degesz/LATEX_Bakalarka/STM32_firmware/CLI.md

# CLI Reference

This document describes the serial command interface exposed by the STM32 LCR meter firmware.

The CLI is implemented with `SimpleCLI` in `src/command_interface.cpp`.

## Serial Settings

- baud rate: `115200`
- line ending: `LF` or `CRLF`

Commands are line-based. Send one command per line.
After each command response, the firmware emits one extra blank line to make responses easier to separate in a serial terminal.

Example:

```text
status
capture
dds 10000 1
```

## Startup Messages

On successful startup the firmware prints:

```text
ready,stm32f103_lcr_meter
```

If acquisition initialization fails, an error line is printed before the ready banner:

```text
error,<reason>
ready,stm32f103_lcr_meter
```

## Command Summary

- `help`
- `id`
- `status`
- `capture [count] [rate] [channel]`
- `capturepair [count] [rate]`
- `measure [count] [rate]`
- `dds [freq_hz] [enable]`
- `amp [value]`
- `offset [value]`
- `range [value]`
- `vpga [value]`
- `ipga [value]`

## Command Details

### `help`

Prints the command list generated by `SimpleCLI`.

Example:

```text
help
```

### `id`

Prints the device identifier and burst buffer capacity.

Example:

```text
id
```

Typical output:

```text
device,stm32f103_lcr_meter
firmware,acquisition_control
max_burst_samples,2048
```

### `status`

Prints the current acquisition settings and output settings.

Example:

```text
status
```

Typical output:

```text
sample_rate_hz,25000
sample_count,500
dds_frequency_hz,1000
dds_enabled,1
amp_wiper,128
offset_pwm,0
shunt_range,0
voltage_pga,0
current_pga,0
```

### `capture [count] [rate] [channel]`

Captures a synchronous AC burst and streams one selected channel in CSV format compatible with the PC oscilloscope script.

Arguments:

- `count`: number of synchronous voltage/current sample pairs
- `rate`: requested sample rate in Hz
- `channel`: `voltage`, `current`, `v`, or `i`

Defaults:

- `count = 500`
- `rate = 0` which means `min(dds_frequency_hz * 25, 1000000)`
- `channel = voltage`

Example:

```text
capture
capture 512 250000 voltage
```

Output format:

```text
sample_rate_hz,250000
index,value
0,2038
1,2060
2,2075
...
```

Notes:

- The actual sample rate reported back is the configured timer rate after integer divider rounding.
- With `rate = 0`, the firmware derives the request from the active DDS frequency so the target is `25` samples per period.
- If `dds_frequency_hz * 25` exceeds `1000000 Hz`, the firmware captures `500` samples at the fastest achievable rate instead.
- Requested sample rates must be between `1000 Hz` and `1000000 Hz`.
- On the current STM32F103 setup, `TIM3` runs from a `72 MHz` timer clock, so the reported rate is the nearest achievable divider result in that range.
- Valid sample count is limited by the burst buffer size.

### `capturepair [count] [rate]`

Captures a synchronous AC burst and prints both channels together.

Arguments:

- `count`: number of sample pairs
- `rate`: requested sample rate in Hz

Defaults:

- `count = 500`
- `rate = 0` which means `min(dds_frequency_hz * 25, 1000000)`

Example:

```text
capturepair
capturepair 128 100000
```

Typical output:

```text
sample_rate_hz,100000
index,v_raw,i_raw
0,2042,2037
1,2068,2059
2,2081,2074
...
```

This command is useful when host software needs both synchronous AC channels at once.

Sample-rate limits are the same as `capture`: request `1000..1000000 Hz`, or pass `0` to auto-select from DDS frequency with a `25` samples-per-period target.

### `measure [count] [rate]`

Captures a synchronous burst, converts both channels to physical units, runs a single-frequency DFT at the active DDS frequency, and reports amplitude, phase, and impedance.

Arguments:

- `count`: number of sample pairs
- `rate`: requested sample rate in Hz

Defaults:

- `count = 500`
- `rate = 0` which means `min(dds_frequency_hz * 25, 1000000)`

Example:

```text
measure
measure 512 200000
```

Typical output:

```text
sample_rate_hz,200000
dds_frequency_hz,10000
shunt_range,1
voltage_pga,0
current_pga,0
shunt_resistance_ohm,1000.000000
samples_per_period,20.000000
captured_cycles,25.600000
voltage_amplitude_v,0.120000
voltage_phase_deg,3.400000
current_amplitude_a,0.000118
current_phase_deg,-1.100000
phase_diff_deg,4.500000
impedance_mag_ohm,1016.949158
impedance_real_ohm,1013.815613
impedance_imag_ohm,79.796631
```

Notes:

- ADC samples are converted from `0..3.3 V` and centered by subtracting `1.65 V`.
- Current is derived from the centered current-channel voltage and the active shunt value.
- With `rate = 0`, the firmware requests `25` samples per DDS period and caps the request at `1000000 Hz`.
- The reported phase difference includes a fixed `180 deg` compensation for the inverted current analog path.
- Shunt mapping is `0=100 ohm`, `1=1 kohm`, `2=10 kohm`, `3=100 kohm`.
- Voltage and current PGA scaling currently use placeholder gain tables set to `1.0`; update `src/impedance_analyzer.cpp` with real analog gains later.

### `dds [freq_hz] [enable]`

Sets DDS frequency and output enable state.

Arguments:

- `freq_hz`: desired DDS output frequency in Hz
- `enable`: `1` to run, `0` to hold reset

Defaults:

- `freq_hz = 1000`
- `enable = 1`

Example:

```text
dds 10000 1
```

Success response:

```text
ok,dds
```

### `amp [value]`

Sets the MCP4561 volatile wiper value.

Full-scale reference: `amp 255` corresponds to approximately `3.55 Vpp`.

Arguments:

- `value`: `0..255`

Example:

```text
amp 180
```

Success response:

```text
ok,amp
```

Failure response:

```text
error,mcp4561 write failed
```

### `offset [value]`

Sets the PWM duty applied to `PA7` for generated source offset control.

Full-scale reference: `offset 255` corresponds to approximately `3.3 V`.

Arguments:

- `value`: `0..255`

Example:

```text
offset 140
```

Success response:

```text
ok,offset
```

### `range [value]`

Sets the 2-bit shunt range selector.

Arguments:

- `value`: `0..3`

Example:

```text
range 2
```

Success response:

```text
ok,range
```

### `vpga [value]`

Sets the 2-bit voltage PGA selector.

Arguments:

- `value`: `0..3`

Example:

```text
vpga 1
```

Success response:

```text
ok,vpga
```

### `ipga [value]`

Sets the 2-bit current PGA selector.

Arguments:

- `value`: `0..3`

Example:

```text
ipga 3
```

Success response:

```text
ok,ipga
```

## Error Responses

The CLI returns simple text errors when parsing or validation fails.

Examples:

```text
error,invalid capture arguments
error,invalid range value
error,invalid dds arguments
error,dma transfer error
```

`SimpleCLI` parser errors are also forwarded as:

```text
error,<SimpleCLI message>
```

## Typical Workflows

### 1. Basic bring-up

```text
id
status
```

### 2. Set source and frontend, then capture one channel

```text
dds 10000 1
amp 160
offset 0
range 1
vpga 2
ipga 2
capture 512 200000 voltage
```

### 3. Capture both synchronous AC channels

```text
capturepair
```

### 4. Use with the Python oscilloscope

Run on the PC:

```bash
python3 pc_osc/pc_oscilloscope.py --port /dev/ttyACM0 --baud 115200 --samples 500 --sample-rate 0
```

Then send on the device serial port:

```text
capture
```

## Notes

- The CLI is designed for development and bring-up, not yet for a polished production protocol.
- `capture` is the easiest way to stay compatible with the existing oscilloscope tool.
- `capturepair` is more suitable for future host-side impedance processing.
- The MCP4561 digipot address is fixed in firmware to `47` decimal (`0x2F`).
