degesz/LATEX_Bakalarka/LATEX_Bakalarka/text/zkratky.tex

\chapter*{\listofabbrevname}
\phantomsection
\addcontentsline{toc}{chapter}{\listofabbrevname}

\begin{acronym}[KolikMista]

	\acro{LCR}
		{indukčnost, kapacita, odpor}
	\acro{ESR}
		{equivalent series resistance (ekvivalentní sériový odpor)}
	\acro{DUT}	 
		{device under test (měřené zařízení)}
	\acro{A/D}	
		{analogově--digitální}
	\acro{DDS}	
		{direct digital synthesis}
	\acro{LUT}	
		{lookup table}
	\acro{D/A}	
		{digitálně--analogový}
	\acro{PGA}	
		{programmable gain amplifier}
	\acro{ADC}	
		{analog-digital converter (analogově-digitální převodník)}
	\acro{SAR}{successive approximation register (registr postupné aproximace)}		
	\acro{OZ}
		{operační zesilovač}
	\acro{GBW}
		{gain bandwidth product}
	\acro{DFT}
		{discrete Fourier transform (diskrétní Fourierova transformace)}
	\acro{FFT}
		{fast Fourier transform (rychlá Fourierova transformace)}
	\acro{RMS}
		{root mean square (efektivní hodnota)}
	\acro{CMOS}
		{complementary metal-oxide-semiconductor}
	\acro{I$^{2}$S}{inter-IC sound}
	\acro{DMA}{direct memory access (přímý přístup do paměti)}
	\acro{UART}{universal asynchronous receiver-transmitter}
	\acro{HP}{horní propust}
	\acro{BNC}{Bayonet Neill-Concelman}
	\acro{CR}{kapacita-odpor (capacitor-resistor)}
	\acro{CSV}{comma-separated values}
	\acro{DC}{direct current (stejnosměrný proud)}
	\acro{DPS}{deska plošných spojů}
	\acro{ESD}{electrostatic discharge (elektrostatický výboj)}
	\acro{HAL}{Hardware Abstraction Layer}
	\acro{I/O}{input/output (vstup/výstup)}
	\acro{I$^{2}$C}{Inter-Integrated Circuit}
	\acro{LAN}{local area network}
	\acro{LED}{light-emitting diode (svítivá dioda)}
	\acro{PC}{personal computer (osobní počítač)}
	\acro{PTC}{positive temperature coefficient (pozitivní teplotní koeficient)}
	\acro{PWM}{pulse-width modulation (pulzně šířková modulace)}
	\acro{RC}{odpor-kapacita (resistor-capacitor)}
	\acro{RGB}{red-green-blue}
	\acro{RL}{odpor-indukčnost (resistor-inductor)}
	\acro{RLC}{rezistor-indukčnost-kapacita (resistor-inductor-capacitor)}
	\acro{SMD}{surface-mount device (součástka pro povrchovou montáž)}
	\acro{SPI}{Serial Peripheral Interface}
	\acro{TVS}{transient voltage suppression}
	\acro{XOR}{exclusive OR}
	
	\acro{DAC}
		{digital-analog converter (digitálně-analogový převodník)}
% rozvinutí zkratky
	%%% bsymfvz
	\acro{symfvz}						% název
		[\ensuremath{f_\textind{vz}}] % symbol
		{vzorkovací kmitočet}					% popis
	%%% esymfvz
 
\end{acronym}
