degesz/LATEX_Bakalarka/LATEX_Bakalarka/text/firmware.tex

\chapter{Firmware}

Firmware finálního prototypu je určen především pro ovládání analogové části, vzorkování napěťového a proudového signálu a následný výpočet impedance. 
Je napsán pro mikrokontrolér STM32F103C8 v prostředí PlatformIO s frameworkem Arduino. 
Pro části, které se dotýkají časování a nastavení ADC, je však použita přímo knihovna STM32 HAL. \cite{STM32_manual}

Program po spuštění inicializuje komunikační rozhraní, řídicí výstupy, zdroj měřicího signálu, indikační LED a snímací část. 
Poté  v hlavní smyčce pouze zpracovává příkazy ze sériové linky. 
Samotné měření tedy není spuštěno trvale, ale vždy až na požadavek z počítače.

\section{Komunikační rozhraní}

Zařízení je ovládáno textovým příkazovým rozhraním po sériové lince je k tomu využita knihovna SimpleCLI \cite{SimpleCLI}. 
Rozhraní slouží jak pro nastavování generátoru a analogového frontendu, tak pro vyvolání snímání nebo výpočtu impedance.

Mezi hlavní příkazy patří:
\begin{table}[H]
    \centering
    \small
    \begin{tabular}{ll}
        \toprule
        Příkaz & Význam \\
        \midrule
        \texttt{status} & Vypíše aktuální nastavení. \\
        \texttt{dds <frekvence> <povoleni>} & Nastaví frekvenci a zapnutí zdroje měřicího signálu. \\
        \texttt{amp <hodnota>} & Nastaví amplitudu měřicího signálu. \\
        \texttt{offset <hodnota>} & Nastaví stejnosměrnou složku signálu pomocí PWM. \\
        \texttt{range <hodnota>} & Vybere bočník pro změnu měřicího rozsahu. \\
        \texttt{vpga <hodnota>} & Nastaví zesílení napěťového kanálu. \\
        \texttt{ipga <hodnota>} & Nastaví zesílení proudového kanálu. \\
        \texttt{capture} & Sejme a odešle jeden z měřicích kanálů. \\
        \texttt{capturepair} & Sejme a odešle oba měřicí kanály. \\
        \texttt{measure} & Sejme oba kanály a vypočítá impedanci. \\
        \bottomrule
    \end{tabular}
    \caption{Přehled podporovaných příkazů firmwaru}
    \label{tab:firmware_prikazy}
\end{table}

Odpovědi jsou záměrně jednoduché a mají podobu řádků oddělených čárkou. 
To umožňuje snadné algoritmické zpracování na straně počítače a zároveň jednoduché ruční testování v sériovém terminálu.

\section{Řízení zdroje měřicího signálu a rozsahů}

Zdroj měřicího signálu je založen na obvodu . 
Mikrokontrolér ovládá obvod AD9837 sériovým rozhraním. 
Při změně frekvence firmware vypočítá ladicí slovo podle hodinového kmitočtu 16 MHz 
a zapíše jej do frekvenčního registru DDS. 
Výstup lze také softwarově zapnout a vypnout.

Amplituda výstupního signálu je nastavována digitálním potenciometrem MCP4561 přes sběrnici I\textsuperscript{2}C. 
Firmware zapisuje hodnotu 0 až 255 do jeho registru jezdce. 
Stejnosměrná složka zdroje je nastavována změnou střídy PWM výstupu, který je v analogové části filtrován.

Proudový rozsah a zesílení obou měřicích větví jsou řízeny jako tři dvoubitové hodnoty na šesti digitálních výstupech. 
%%TODO: good or not?   Firmware pro tyto volby pouze nastavuje příslušné binární kombinace; fyzický význam jednotlivých kódů je dán zapojením analogové části.

\section{Synchronní snímání signálů}

Měřené střídavé signály jsou přivedeny na dva analogové vstupy mikrokontroléru. 
Protože pro výpočet impedance je důležitý nejen poměr amplitud, ale i fázový rozdíl,
musí být oba kanály vzorkovány současně.

Firmware k tomu využívá dvojici \acs{A/D} převodníků v režimu současné pravidelné konverze. 
Spouštění převodu zajišťuje časovač TIM3, jehož událost update je přivedena jako externí trigger pro ADC1. 
Po každém impulzu časovače tedy vznikne jeden synchronní pár vzorků.

Výsledky převodu jsou ukládány pomocí \acs{DMA} do paměťového bufferu. 
Každá položka bufferu je 32bitové slovo, ve kterém je v dolních 16 bitech uložen vzorek napěťového kanálu a v horních 16 bitech vzorek proudového kanálu. 
Maximální délka jedné dávky je 2048 dvojic vzorků.

Vzorkování je dávkové. 
Hostitelský počítač pošle požadovaný počet vzorků a požadovanou vzorkovací frekvenci. 
Firmware podle požadované frekvence nastaví děličku a periodu časovače TIM3, spustí ADC a DMA, 
počká na dokončení přenosu a po skončení časovač i převodníky zastaví. 
Protože časovač používá celočíselné dělení, skutečná frekvence nemusí být přesně rovna požadované hodnotě; 
firmware proto v odpovědi vždy vrací skutečně nastavenou hodnotu.

Pokud je požadovaná vzorkovací frekvence v příkazu zadána jako nula, 
firmware ji automaticky odvodí z aktuální frekvence DDS. 
Cílem je 25 vzorků na periodu měřicího signálu, při měřicí frekvenci větší než 40 kHz 
je však dosažen hardwarový limit vzorkovací frekvence 1 MHz a počet vzorků na periodu se snižuje.

Získané vzorky jsou následně buď odeslány po sériové lince do PC, nebo je z nich vypočítána impedance 
(v závislosti na použití příkazu \texttt{capture} nebo \texttt{measure}).

\section{Výpočet impedance}
%%TODO: vypocet impedance ve firmwaru

\section{Stavová indikace}

Pro jednoduchou kontrolu běhu programu je použit výstup na signalizační LED. 
Firmware na něm generuje signál PWM s pomalu se měnící střídou a tím vizuálně indikuje, 
že hlavní smyčka běží a mikrokontrolér není zablokovaný.

Pro další signalizační účely jsou na DPS zapojené dvě adresovatelné RGB diody, 
ale v současnosti nejsou ve firmwaru nijak implementovány.
