degesz/LATEX_Bakalarka/LATEX_Bakalarka/text/literatura.tex

% Seznam citací definovaný přímo pomocí prostředí thebibliography
% Formátováno podle normy ČSN ISO 690

\begin{thebibliography}{99}

% ==================== ZDROJE TEORIE ====================

\bibitem{KeysightImpedanceHandbook}
	KEYSIGHT TECHNOLOGIES.
	\emph{Impedance Measurement Handbook: A~Guide to Measurement Technology and Techniques.}  [online].
	6th ed.
	Application Note 5950-3000.
%	2020.
	Dostupné~z: \url{https://www.keysight.com/us/en/assets/7018-06840/application-notes/5950-3000.pdf}. [cit.\,2026-01-03].

\bibitem{ArtOfElectronics}
	HOROWITZ, Paul a~Winfield HILL.
	\emph{The Art of Electronics.}
	3rd ed.
	Cambridge: Cambridge University Press, 2015.
	ISBN~978-0521809269.

\bibitem{smith_dsp_guide}
	SMITH, Steven~W.
	\emph{The Scientist and Engineer's Guide to Digital Signal Processing.}
	San Diego: California Technical Publishing, 1997.
	ISBN~978-0-9660176-3-2.
	Dostupné také z: \url{http://www.dspguide.com/}. [cit.\,2026-01-03].

\bibitem{Shannon1949}
	SHANNON, Claude~E.
	\emph{Communication in the Presence of Noise.}
	v Proceedings of the IRE,
	vol.\,37, no.\,1, s.\,10--21, 1949.
	DOI:~10.1109/JRPROC.1949.232969.
	Dostupné také~z: \url{https://ieeexplore.ieee.org/document/1697831} [cit.\,2026-01-03].

\bibitem{TI_ImpedanceMeasurement}
	TEXAS INSTRUMENTS.
	\emph{LCR Meter Analog Front-End Reference Design (TIDA-060029).} [online].
	%TIDUEU6B.
	%2021.
	Dostupné~z: \url{https://www.ti.com/lit/ug/tidueu6b/tidueu6b.pdf}. [cit.\,2026-01-03].

\bibitem{elliott_peakdetection}
	ELLIOTT, Rod.
	\emph{AN014 -- Peak Detection Circuits} [online].
	2017.
	Dostupné~z: \url{https://sound-au.com/appnotes/an014.htm}. [cit.\,2026-01-03].

\bibitem{TI_stability}
	KAY, Art a~Collin WELLS.
	\emph{Operational Amplifier Stability Theory and Compensation Methods.} [online].
	Texas Instruments, 2025.
	White Paper SBOA626.
	Dostupné~z: \url{https://www.ti.com/jp/lit/wp/sboa626/sboa626.pdf}. [cit.\,2026-05-24].

\bibitem{Steinbauer_Mereni2010}
	STEINBAUER, Miloslav, Jan MIKULKA, Eva GESCHEIDTOVÁ, Radek KUBÁSEK a~Jiří REZ.
	\emph{Měření v elektrotechnice.}
	2., dopl. vyd.
	Brno: VUT v~Brně, 2010.
	ISBN~978-80-214-4160-6.

% ==================== DATASHEETY PŘÍSTROJŮ ====================

\bibitem{RS_LCX_Datasheet}
	ROHDE \& SCHWARZ.
	\emph{R\&S LCX LCR Meters: Data Sheet.} [online].
	%Munich, Germany, 2022.
	Verze 03.00
	Dostupné~z: \url{https://scdn.rohde-schwarz.com/ur/pws/dl_downloads/pdm/cl_brochures_and_datasheets/data_sheet/3609_8309_32/LCX_dat_en_3609-8309-32_v0300.pdf}. [cit.\,2026-01-03].

\bibitem{Keysight_U1732C_Datasheet}
	KEYSIGHT TECHNOLOGIES.
	\emph{U1730C Series Handheld LCR Meters: Data Sheet.} [online].
	Dostupné~z: \url{https://www.keysight.com/us/en/assets/7018-02950/data-sheets/5990-7778.pdf}. [cit.\,2026-01-03].

\bibitem{BKPrecision_880_Datasheet}
	B\&K PRECISION.
	\emph{Model 880: Dual Display Handheld 100\,kHz LCR Meter with ESR: Datasheet.} [online].
	Dostupné~z: \url{https://www.bkprecision.com/products/component-testers/880}. [cit.\,2026-04-30].

\bibitem{hadex_lcrt4}
	HADEX.
	\emph{Univerzální tester součástek LCR-T4} [online].
	%2025.
	Dostupné~z: \url{https://www.hadex.cz/r098-univerzalni-tester-soucastek-lcr-t4/}. [cit.\,2026-01-03].

% ==================== DATASHEETY SOUČÁSTEK ====================

\bibitem{CD4052B}
	TEXAS INSTRUMENTS.
	\emph{CD405xB CMOS Single 8-Channel Analog Multiplexer/Demultiplexer With Logic-Level Conversion.} [online].
	Dostupné~z: \url{https://www.ti.com/lit/ds/symlink/cd4052b.pdf}. [cit.\,2026-05-05].

\bibitem{citrelay_j104d}
	CIT RELAY \& SWITCH.
	\emph{J104D Series Relay Datasheet.} [online].
	Rev.\,B.
	%Rogers, MN, USA, 2022.
	Dostupné~z: \url{https://www.citrelay.com/wp-content/uploads/2025/05/Relay-J104D.pdf}. [cit.\,2026-01-03].

\bibitem{AD9837}
	ANALOG DEVICES, Inc.
	\emph{AD9837: Low Power, 8.5\,mW, 2.3\,V to 5.5\,V, Programmable Waveform Generator.} [online].
	Rev.\,A.
%	2011.
	Dostupné~z: \url{https://www.analog.com/media/en/technical-documentation/data-sheets/AD9837.PDF}. [cit.\,2026-01-03].

%% \bibitem{ESP32S3_Datasheet}
%% 	ESPRESSIF SYSTEMS.
%% 	\emph{ESP32-S3 Series Datasheet.} [online].
%% %	2024.
%% 	Dostupné~z: \url{https://documentation.espressif.com/esp32-s3_datasheet_en.pdf}. [cit.\,2026-01-03].
%% 
%% \bibitem{ESP32S3_HardwareDesign}
%% 	ESPRESSIF SYSTEMS.
%% 	\emph{ESP32-S3 Hardware Design Guidelines.} [online].
%% %	Release master.
%% %	2025.
%%	Dostupné~z: \url{https://docs.espressif.com/projects/esp-hardware-design-guidelines/en/latest/esp32s3/esp-hardware-design-guidelines-en-master-esp32s3.pdf}. [cit.\,2026-01-03].

\bibitem{LM27762}
	TEXAS INSTRUMENTS.
	\emph{LM27762 Switched Capacitor Inverting Regulator.} [online].
%	2024.
	Dostupné~z: \url{https://www.ti.com/lit/ds/symlink/lm27762.pdf}. [cit.\,2026-01-03].

\bibitem{REF3033}
	TEXAS INSTRUMENTS.
	\emph{REF3033-Q1: 3.0-V, 50-ppm/°C, 50-µA, SOT-23-3 Voltage Reference.} [online].
%	2024.
	Dostupné~z: \url{https://www.ti.com/lit/ds/symlink/ref3033-q1.pdf}. [cit.\,2026-01-03].

%% \bibitem{NCD9801}
%% 	ON SEMICONDUCTOR.
%% 	\emph{NCD9801: 16-Bit, 1\,MSPS, Single-Channel, Low-Power ADC.} [online].
%% %	2024.
%% 	Dostupné~z: \url{https://www.onsemi.com/download/data-sheet/pdf/ncd9801-d.pdf}. [cit.\,2026-01-03].

%% \bibitem{OPA2810}
%% 	TEXAS INSTRUMENTS.
%% 	\emph{OPA2810 Wideband, Low-Noise, Voltage-Feedback Operational Amplifier.} [online].
%% %	2024.
%% 	Dostupné~z: \url{https://www.ti.com/lit/ds/symlink/opa2810.pdf}. [cit.\,2026-01-03].
%% 
\bibitem{OPA2192}
	TEXAS INSTRUMENTS.
	\emph{OPA2192: Dual, 36-V, 10-MHz, Low-Offset, Low-Noise, Rail-to-Rail Output Operational Amplifier.} [online].
	Dostupné~z: \url{https://www.ti.com/lit/ds/symlink/opa2192.pdf}. [cit.\,2026-05-01].

\bibitem{TLV9154}
	TEXAS INSTRUMENTS.
	\emph{TLV9154 Quad-Channel, 16-V, Low-Noise, Rail-to-Rail Input/Output Operational Amplifier.} [online].
%	2024.
	Dostupné~z: \url{https://www.ti.com/lit/ds/symlink/tlv9154.pdf}. [cit.\,2026-01-03].

\bibitem{INA823}
	TEXAS INSTRUMENTS.
	\emph{INA823 Precision, Low-Power, Wide-Supply (2.7-V to 36-V) Instrumentation Amplifier.} [online].
%	2021.
	Dostupné~z: \url{https://www.ti.com/lit/ds/symlink/ina823.pdf}. [cit.\,2026-01-03].

\bibitem{STM32_manual}
	STMICROELECTRONICS.
	\emph{RM0008: STM32F101xx, STM32F102xx, STM32F103xx, STM32F105xx a~STM32F107xx advanced Arm-based 32-bit MCUs.} [online].
	Rev.\,21.
	%2021.
	Dostupné~z: \url{https://www.st.com/resource/en/reference_manual/rm0008-stm32f101xx-stm32f102xx-stm32f103xx-stm32f105xx-and-stm32f107xx-advanced-armbased-32bit-mcus-stmicroelectronic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}. [cit.\,2026-05-24].

\bibitem{SimpleCLI}
SPACEHUHNTECH.
Knihovna \emph{SimpleCLI.} [online].
Dostupné~z: \url{https://github.com/spacehuhntech/SimpleCLI}. [cit.\,2026-05-06].

%%%  %%%%%%%%%%%%%%%%%%%%%%%%%%%%%%%%%%%%%%%%%%%%%%%%%%%%%%%%%%%%%%%%%%%%%%%%
%%%  %2) Seznam citací pomocí BibTeXu (automatické vytvoření seznamu literatury z databáze)
%%%  % V této variantě je třeba spouštět BibTeX zvlášť (není součástí překladu), což ale neplatí pro Overleaf, který BibTex spouští sám.
%%%  % Definice ‚stylu‘ seznamu
%%%  %\bibliographystyle{unsrturl}
%%%  %nebo
%%%  \bibliographystyle{czechiso} %pro ISO ČSN 690 (nespoléhejte na něj ale úplně; je to zastaralý soubor a z povahy věci rovněž plyne, že si neporadí se všemi nároky normy; běžnou praxí je nechat Bibtex vygenerovat seznam zdrojů a nakonec jej ručně doupravit do finální podoby.
%%%  % Soubor s databází zdrojů
%%%  \bibliography{text/literatura}

\end{thebibliography}
