degesz/LATEX_Bakalarka/LATEX_Bakalarka/text/prvni_prototyp.tex

\chapter{První prototyp}
První pokus o návrh zařízení byl založen na metodě převodu na stejnosměrná napětí, která je blíže popsána v kapitole \ref{sec:digit_DC}.
Tato metoda se však později ukázala jako slepá vývojová větev, protože neposkytovala dostatečnou přesnost měření. 
Pro ověření konceptu byl vytvořen prototyp zařízení (obr. \ref{fig:prototyp_render}).

Prototyp obsahoval pouze měřicí část bez uživatelského rozhraní. Naměřená data byla přenášena na počítač pomocí sériové linky.
Původní záměr byl připojit ovládací modul s displejem a tlačítky později jako samostatný modul.

\begin{figure}[htbp]
	\centering
	\begin{subfigure}[b]{0.48\textwidth}
		\centering
		
		\caption{ }
		\label{fig:prototyp_render_front}
	\end{subfigure}
	\hfill
	\begin{subfigure}[b]{0.48\textwidth}
		\centering
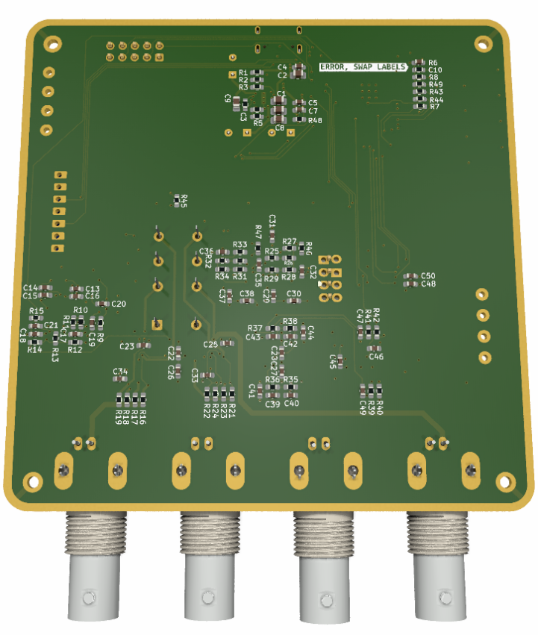
[picture p15: LATEX_Bakalarka/obrazky/prototyp_render_back.png]
		
		\caption{ }
		\label{fig:prototyp_render_back}
	\end{subfigure}
	\caption{3D render prvního prototypu: (a) přední strana, (b) zadní strana}
	\label{fig:prototyp_render}
\end{figure}

\section{Validované subsystémy}
Na prototypu byly odzkoušeny řešení pro napájení a generaci měřicího signálu. Tyto subsystémy fungovaly bezproblémově a byly proto přeneseny do finálního návrhu.

\subsection{Napájecí systém}
Celé zařízení je napájeno z 5V USB. Dále je zařazen jednoduchý lineární regulátor HT7533, který poskytuje napájecí linku 3,3 V pro digitální součástky.

Jelikož analogová část obvodu pracuje se střídavým napětím, potřebují \acs{OZ} kladnou i zápornou napájecí linku.
Tu zajišťuje integrovaný obvod LM27762 od společnosti Texas Instruments \cite{LM27762}.
Tento čip v sobě sdružuje invertující nábojovou pumpu a lineární regulátory pro obě koleje.
Schéma napájecího systému je zobrazeno na~obr.~\ref{fig:power_sch}.

\begin{figure}[h!]
    \centering
    
    \caption{Schéma napájecího systému prvního prototypu.}
    \label{fig:power_sch}
\end{figure}

Rezistory $R_{4}$ až $R_{7}$ tvoří děliče zpětné vazby a nastavují výstupní napětí regulátorů.

Výstupní napětí kladné koleje je dáno vztahem \ref{eq:vout_pos}.
\begin{equation}
    V_{OUT+} = 1{,}2\ \unit{V} \cdot \frac{R_4 + R_5}{R_5}
    \label{eq:vout_pos}
\end{equation}
Analogicky pro zápornou kolej platí vztah \ref{eq:vout_neg}.
\begin{equation}
    V_{OUT-} = -1{,}2\ \unit{V} \cdot \frac{R_6 + R_7}{R_7}
    \label{eq:vout_neg}
\end{equation}

Zvolením hodnot $R_4 = R_6 = 68\ \unit{k\Omega}$ a $R_5 = R_7 = 22\ \unit{k\Omega}$ je regulace výstupu nastavena na $\pm 4{,}91\ \unit{V}$.
Tím je zajištěn dostatečný prostor pro úbytek napětí na~regulátorech. \cite{LM27762}

\subsection{Generátor měřicího signálu}

Generátor měřicího signálu je realizován pomocí \acs{DDS} syntézy, jak bylo popsáno v~kapitole \ref{sec:dds}.
Jelikož výstupní signál integrovaného obvodu AD9837 má jak amplitudu, tak stejnosměrnou složku 0,3~V \cite{AD9837}, bylo nutné použít upravovací obvod se zesilovačem, digitálním potenciometrem a sčítačkou.
Schéma generátoru je zobrazeno na obr.~\ref{fig:sigsource_sch}.

Měřením bylo zjištěno, že tento návrh generátoru signálu je plně funkční i při maximální frekvenci 100~kHz.

\begin{figure}[h!]
    \centering
    
    \caption{Schéma generátoru měřicího signálu.}
    \label{fig:sigsource_sch}
\end{figure}

\subsection{Referenční bočníky}

Rozsah měření je určen referenčním bočníkem, což je rezistor, který převádí proud na napětí. 
Jejich přepínání je řešeno pomocí analogových spínačů CD4052 \cite{CD4052B}, které jsou řízeny dvěma binárními signály 
z mikrokontroléru. 

Jelikož vnitřní odpor spínačů není v porovnání s bočníkem o nejmenší hodnotě zanedbatelný, 
je tento bočník spínán pomocí relé. Toto relé je řízeno pomocí NOR hradla ze stejných binárních signálů.

Pro další potlačení vlivu vnitřního odporu spínačů je zapojení provedeno tak, 
aby proudová cesta a signál do vstupu \acs{OZ} měly separátní spínače (viz obr.~\ref{fig:range_switch}).

Hodnoty bočníků byly převzaty z doporučení v dokumentu Texas Instruments \cite{TI_ImpedanceMeasurement}.

\begin{figure}[H]
    \centering
    
    \caption{Zjednodušené schéma přepínání referenčních bočníků}
    \label{fig:range_switch}
\end{figure}

Pro vizualizaci aktuálně zvoleného bočníku byl použit další analogový spínač připojený na stejné řídící signály, 
který spínal signalizační LED.

\subsection{Nastavitelné zesilovače}
Aby nedošlo ke zkreslení měřených signálů vlivem vstupní impedance \acs{A/D} převodníku, musí být
signály odděleny aktivním prvkem s nízkou výstupní impedancí.

K tomu účelu byly zapojeny diferenční zesilovače INA823 \cite{INA823} s nastavitelným zesílením, 
díky kterým lze navíc zesílit slabé signály a tak rozšířit oblast použitelnosti jednotlivých bočníků.

Zesílení \(G\) se nastavuje připojeným rezistorem \(R_G\).

\begin{equation}
    G = 1 + \frac{100~\mathrm{k\Omega}}{R_G}
\end{equation}

Byly zvoleny možnosti zesílení \(1\times\), \(2\times\), \(5\times\) a \(10\times\), 
tedy rezistory \(R_G = 100~\mathrm{k\Omega}\), \(25~\mathrm{k\Omega}\) a \(11~\mathrm{k\Omega}\).
 Pro zesílení \(1\times\) je potřebný odpor nekonečný, není tedy zapojen žádný rezistor.

Přepínání rezistorů i se signalizací bylo řešeno analogovými spínači podobě jako přepínání bočníků.

%%TODO: auto balancing bridge stability issue - resistor in series with measured impedance

%%TODO: \subsection{Omezení při měření nízkých impedancí}
%%
%%Nejmenší použitý bočník má v současné revizi příliš vysokou hodnotu pro přesné měření velmi nízkých impedancí. To se projevuje zejména při výpočtu parametrů ESR, Q a D, které jsou citlivé na přesnost určení malé reálné nebo imaginární složky impedance. Tyto veličiny jsou proto ve výsledcích uváděny pouze jako orientační.
%%

\subsection{4-bodové měření}
Jelikož vodiče mezi měřenou impedancí a měřicím přístrojem mají vlastní impedanci, která není předmětem měření, 
byla k potlačení jejího vlivu použita 4-bodová konfigurace, v odborné literatuře často označovaná jako Kelvinovo připojení~\cite[str.~277]{ArtOfElectronics}.

\vspace{0.5cm}
\begin{figure}[htbp]
	\centering
	\begin{subfigure}[b]{0.34\textwidth}
		\centering
		
		\caption{ }
		\label{fig:4wire_connection_sch}
	\end{subfigure}
	\hfill
	\begin{subfigure}[b]{0.62\textwidth}
		\centering
		
		\caption{ }
		\label{fig:4wire_diagram}
	\end{subfigure}
	\caption{Princip 4-bodového (Kelvinova) připojení měřené impedance: (a) schématické znázornění, (b) fyzická realizace (převzato z~\cite{KeysightImpedanceHandbook}).}
	\label{fig:4wire_connection}
\end{figure}
Tato konfigurace se vyznačuje připojení měřené impedance čtyřmi vodiči, přičemž dvěmi protéká proud a dvěmi se snímá napětí.
Z důvodu vysoké vstupní impedance diferenciálních zesilovačů je proud protékající napěťovými vodiči zanedbatelný, nezpůsobuje tedy pokles napěťí.
Stínění připojené k zemi poskytuje další odolnost vůči šumu.

\begin{figure}[H]
    \centering
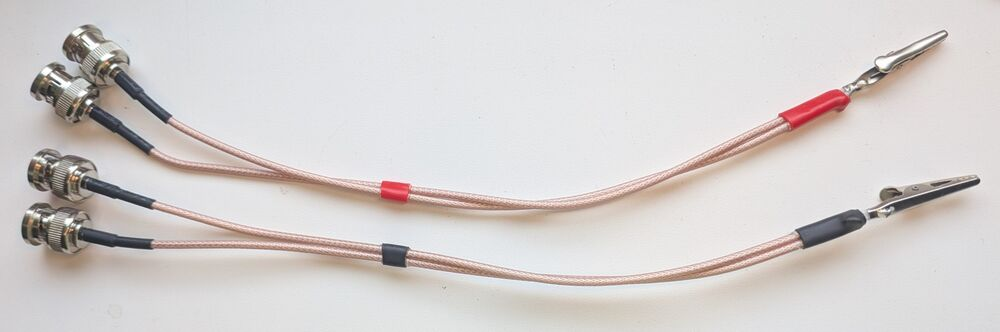
[picture p16: LATEX_Bakalarka/obrazky/leads.jpg]
    
    \caption{Fotografie měřicích vodičů.}
    \label{fig:merici_vodice}
\end{figure}

Terminály se standardně označují $H_{\mathrm{CUR}}$, $H_{\mathrm{POT}}$, $L_{\mathrm{POT}}$, $L_{\mathrm{CUR}}$ 
(z anglických slov \uv{potential} a \uv{current}).
Typicky jsou realizovány pomocí koaxiálních BNC konektorů s roztečí 22 mm, 
což bylo dodrženo pro zachování kompatibility komerčních měřicích fixtur.

\section{Zjištěné nedostatky}
V průběhu testování prototypu došlo k odkrytí několika chyb v návrhu. Z toho pramenil další výzkum způsobů měření, jako metoda přímého vzorkování signálů.

\subsection{Zkreslující OZ}
V zájmu snížení nákladů na prototyp byl v samovyvažovacím můstku použit levnější OZ TLV9154 \cite{TLV9154}.
Při vyšších frekvencích bylo osciloskopem změřeno, že tento OZ zkresluje tvar sinusového signálu, což výrazně snižuje přesnost měření.

%note
%%  \subsection{Nadbytečné zesilovače}
%%  V návrhu prototypu byly v dráze signálu měřeného napětí a proudu použity diferenční zesilovače INA823 s nastavitelným zesílením \cite{INA823}.
%%  Zesílení bylo nastavováno připojením různých rezistorů pomocí analogového multiplexeru.
%%  
%%  To se ukázalo jako zbytečná komplikace, nastavování rozsahů pak bylo příliš složité.

\subsection{Nevhodný způsob měření fáze}
V tomto prototypu bylo měření fáze implementováno pomocí detekce průchodu nulou komparátorem a následném měření časové prodlevy hran pulzů mikrokontrolérem.
Takové měření je nejen nákladné na procesorový čas vzhledem k časté aktivaci přerušení, ale také při frekvenci 100 kHz neposkytuje vysoké rozlišení.

\subsection{Nevhodný způsob měření amplitud}
Metoda převodu na stejnosměrné napětí blíže popsaná v kapitole \ref{sec:digit_DC} se ukázala jako nepřesná.
