degesz/LATEX_Bakalarka/LATEX_Bakalarka/obrazky/lcr_compensated_exact.pdf

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

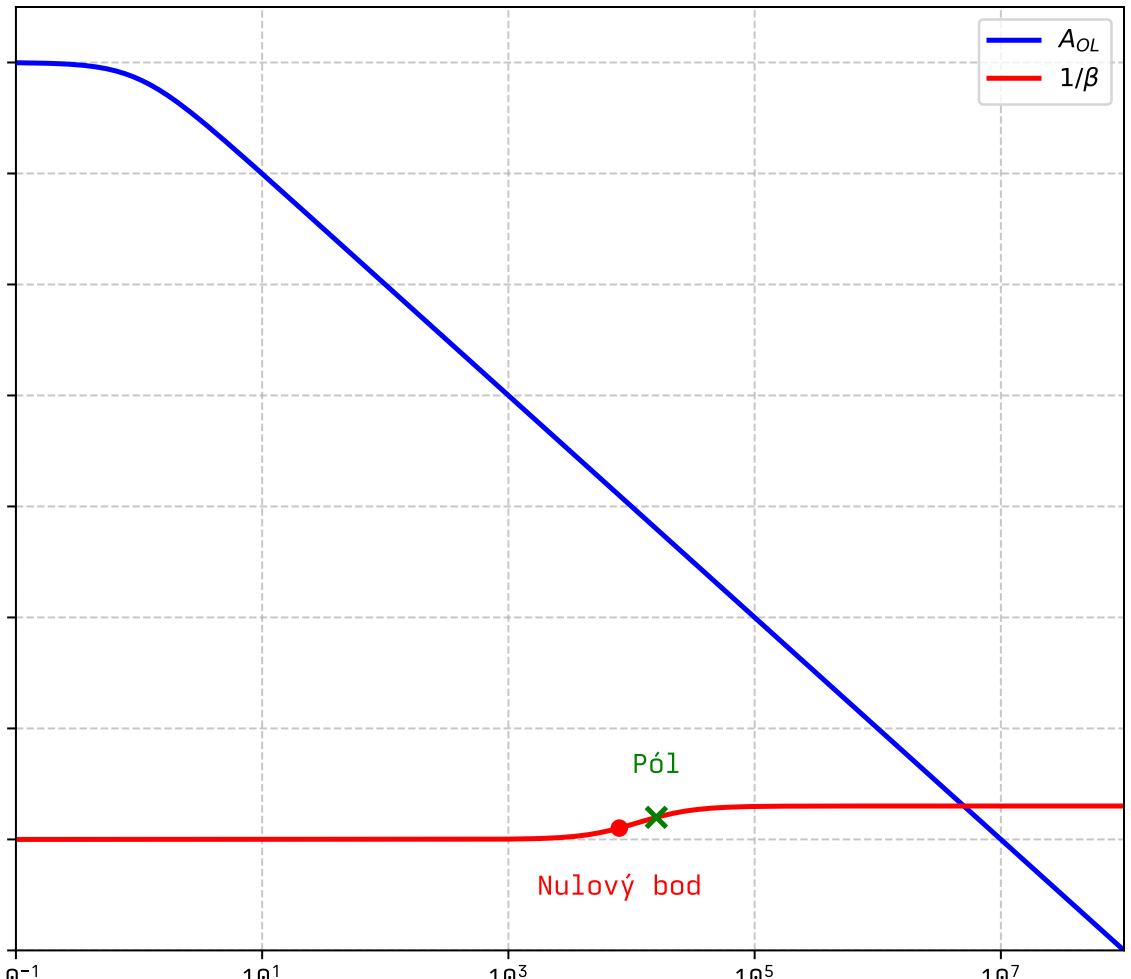
[picture p57: figure]
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
