degesz/LATEX_Bakalarka/LATEX_Bakalarka/obrazky/lcr_uncompensated_exact.pdf

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

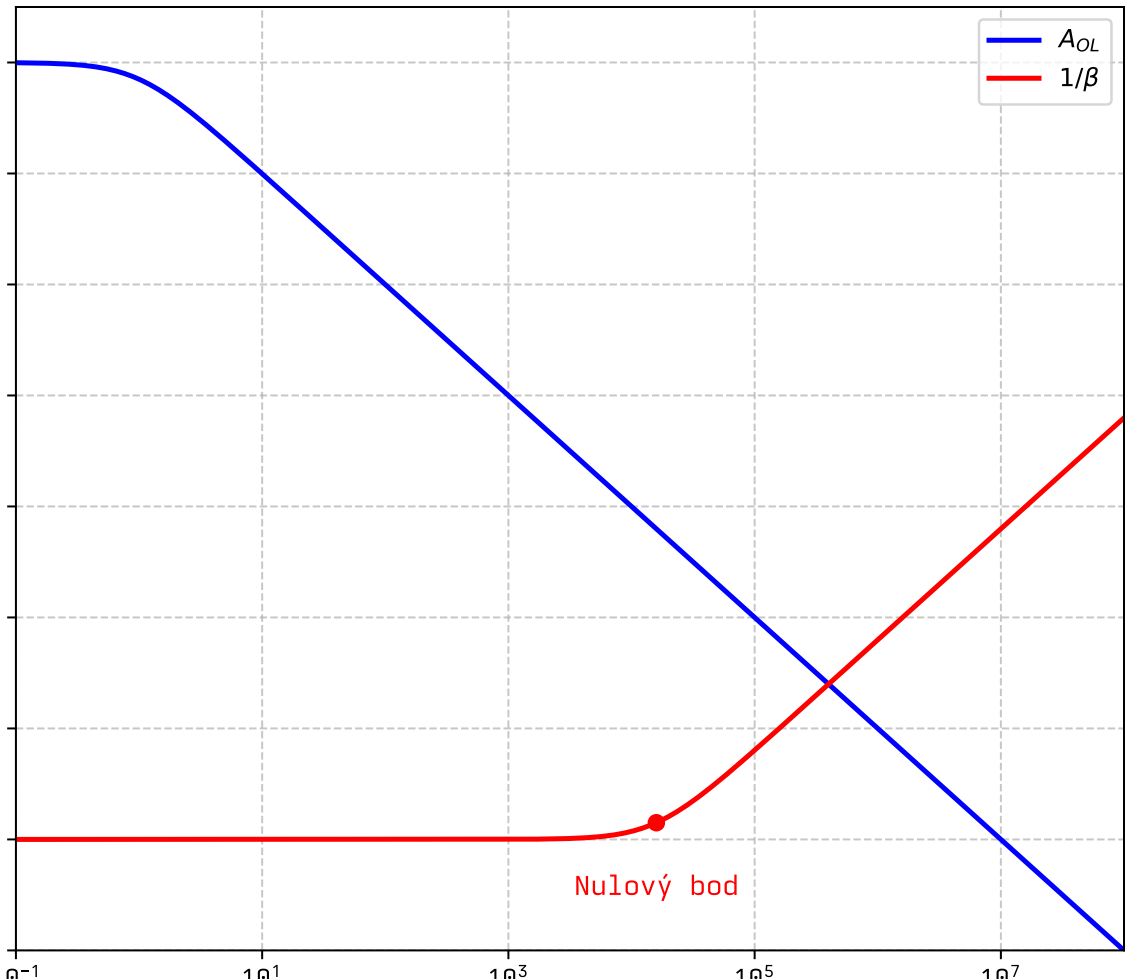
[picture p58: figure]
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
