degesz/LATEX_Bakalarka/LATEX_Bakalarka/obrazky/final_PCB_photo_marked.pdf

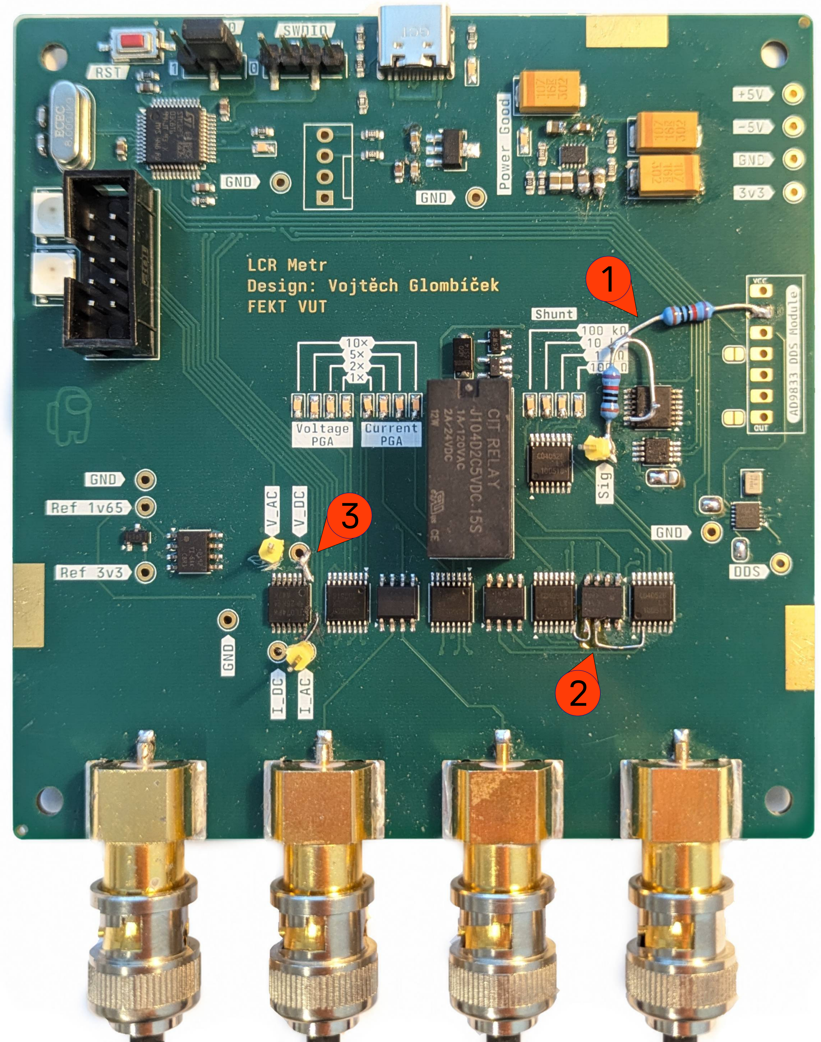
[picture p59: page 1]

1

2

3
