degesz/LATEX_Bakalarka/LATEX_Bakalarka/obrazky/layout_img.pdf

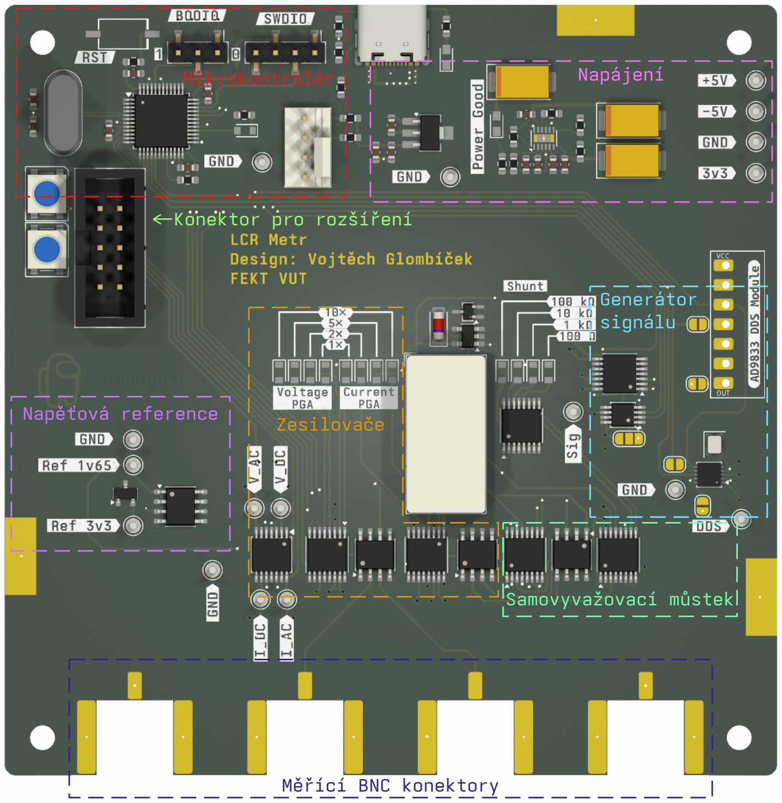
[picture p60: page 1]

Napájení

Napěťová reference Zesilovače

Samovyvažovací můstek

Generátor
signálu

Měřící BNC konektory

Mikrokontrolér

Konektor pro rozšíření

amongus
