degesz/LATEX_Bakalarka/LATEX_Bakalarka/obrazky/komponent_viz/C_Elektrolyt_1kHz.pdf

Kondenzátor elektrolytický

80 μF | 100 μF | 120 μF | 140 μF | 160 μF
