degesz/LATEX_Bakalarka/LATEX_Bakalarka/obrazky/komponent_viz/L_Toroid_1kHz.pdf

Induktor toroidní

100 μH | 105 μH | 110 μH | 115 μH
