degesz/LATEX_Bakalarka/2nd_prototype_LCRmeter/___V2_LCR_Meter.png

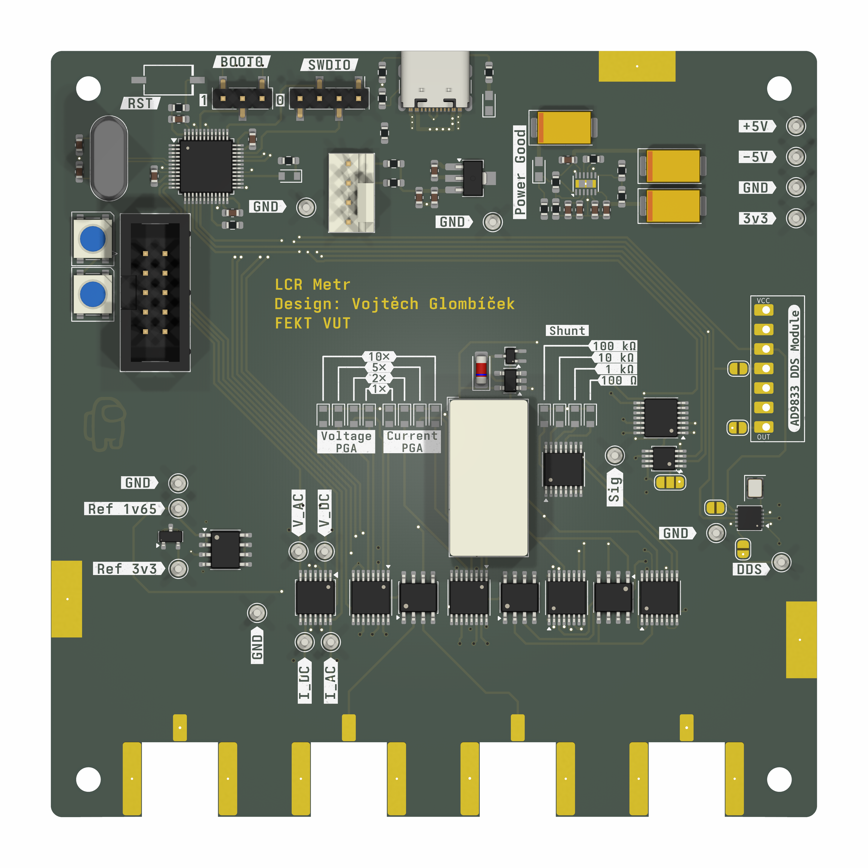
2nd_prototype_LCRmeter/___V2_LCR_Meter.png
