degesz/LATEX_Bakalarka/LATEX_Bakalarka/obrazky/komponenty/PXL_20260515_114136033.MP.jpg

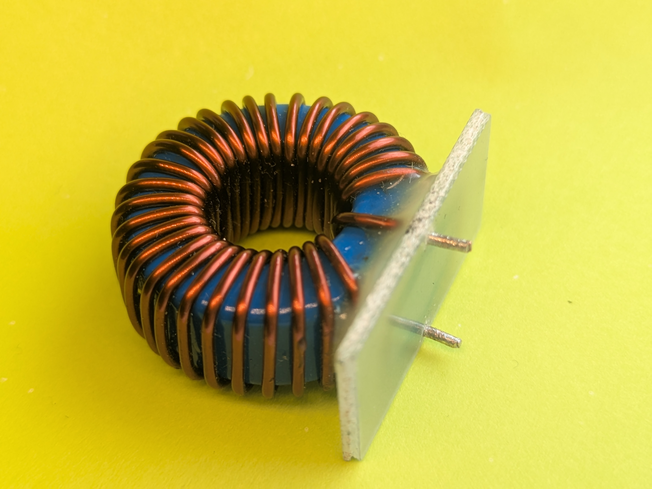
LATEX_Bakalarka/obrazky/komponenty/PXL_20260515_114136033.MP.jpg
