degesz/LATEX_Bakalarka/LATEX_Bakalarka/obrazky/stats_meas.png

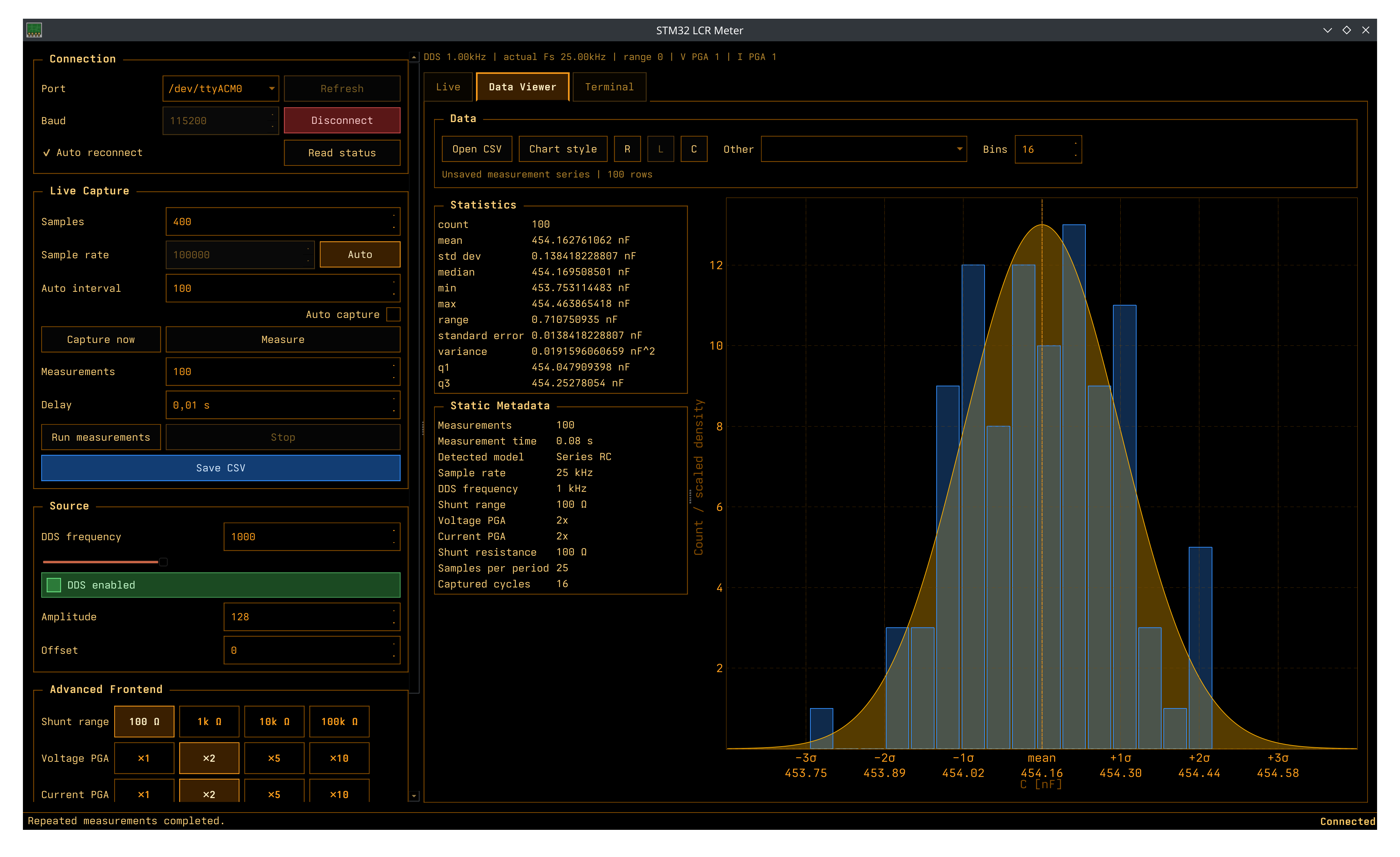
LATEX_Bakalarka/obrazky/stats_meas.png
