degesz/LATEX_Bakalarka/Test_board_BAKALARKA/front_panel/graphics/WideGamut-Spectrum-sRGB.jpg

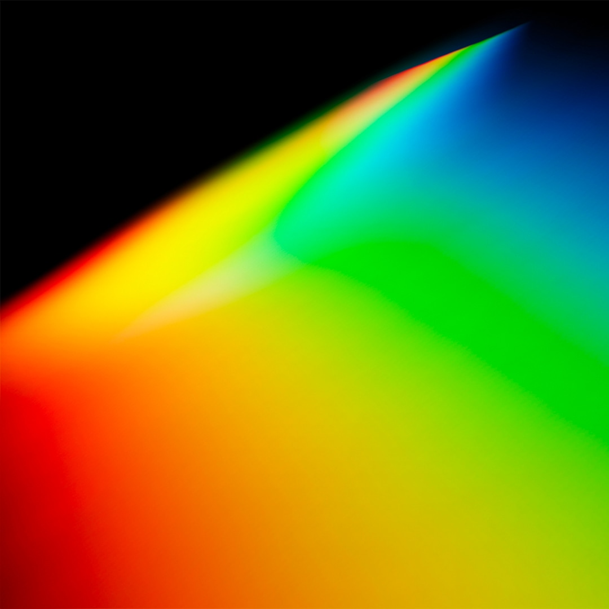
Test_board_BAKALARKA/front_panel/graphics/WideGamut-Spectrum-sRGB.jpg
