degesz/LATEX_Bakalarka/2nd_prototype_LCRmeter/3D_Models/ESP32-S2-SOLO-2.STEP

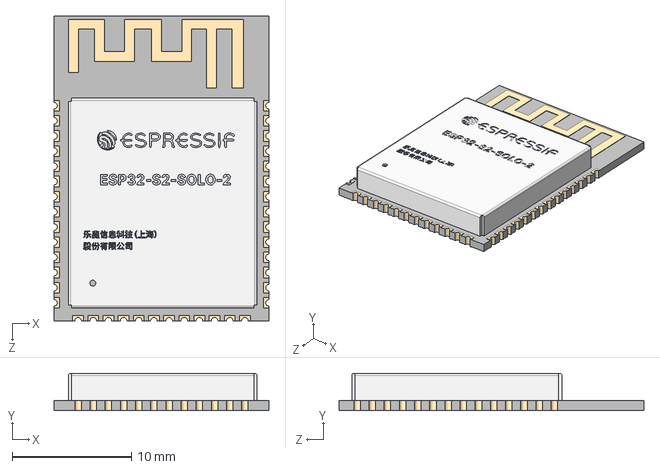
[picture p65: CAD file, 2026-02-22]
2nd_prototype_LCRmeter/3D_Models/ESP32-S2-SOLO-2.STEP
18.0 x 3.14 x 25.5 mm
