degesz/LATEX_Bakalarka/2nd_prototype_LCRmeter/3D_Models/GY-511_LSM303DLHC.step

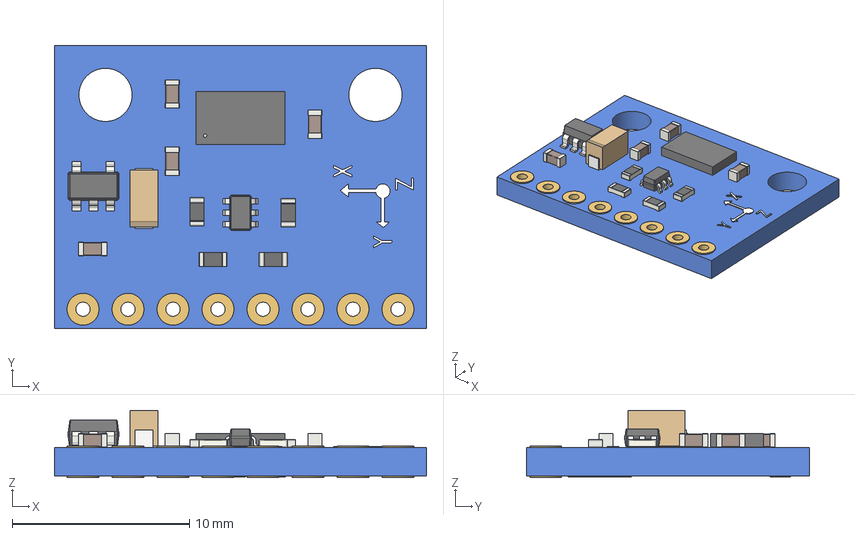
[picture p66: CAD file, 2026-02-22]
2nd_prototype_LCRmeter/3D_Models/GY-511_LSM303DLHC.step
21.0 x 16.0 x 3.80 mm
PCB
trou1
trou002
trou003
trou004
trou005
trou006
trou007
trou008
Text_VIN
Text_3.3V
Text_GND
Text_SCL
Text_SDA
Text_INT2
Text_INT1
Text_DRDY
R_0603_1608Metric
R_0603_1608Metric001
R_0603_1608Metric002
R_0603_1608Metric003
C_0603_1608Metric001
C_0603_1608Metric003
Corps002
Corps001 (Mirror #1)
C_0603_1608Metric004
C_0603_1608Metric005
Text_ITGMPU
SOT_23_5
Text_XYZ
LGA_14_3x5mm_P08mm_LayoutBorder1x6y
SOT_363_SC_70_6
Corps001
