degesz/LATEX_Bakalarka/2nd_prototype_LCRmeter/3D_Models/RELAY8_J104D2C24VDC_15S_CRS.step

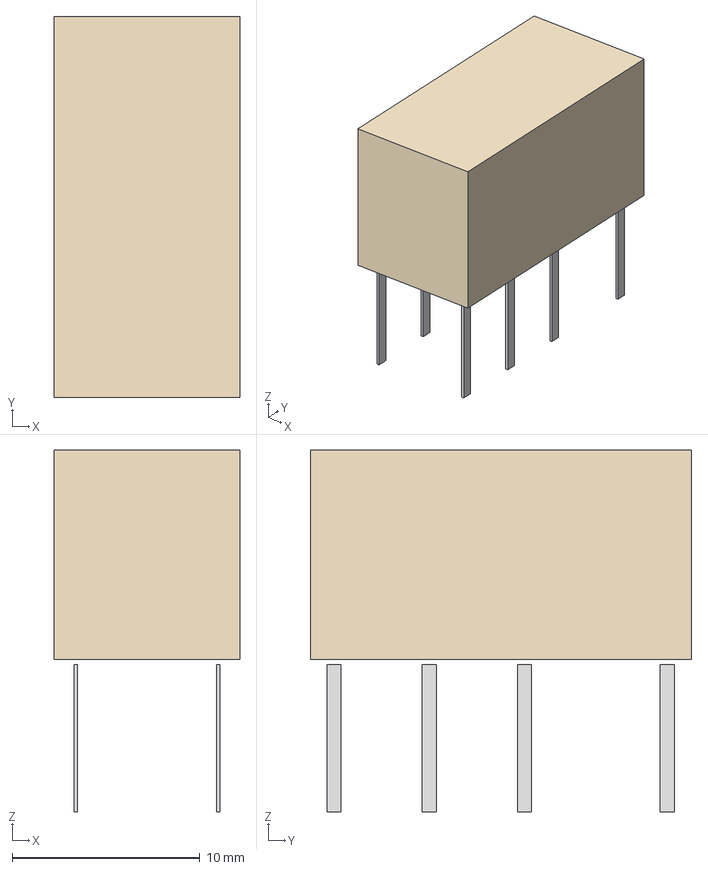
[picture p67: CAD file, 2025-12-03]
2nd_prototype_LCRmeter/3D_Models/RELAY8_J104D2C24VDC_15S_CRS.step
9.91 x 20.3 x 19.3 mm
