degesz/LATEX_Bakalarka/2nd_prototype_LCRmeter/3D_Models/TactileButton(6x3,5mm)_SMD.stp

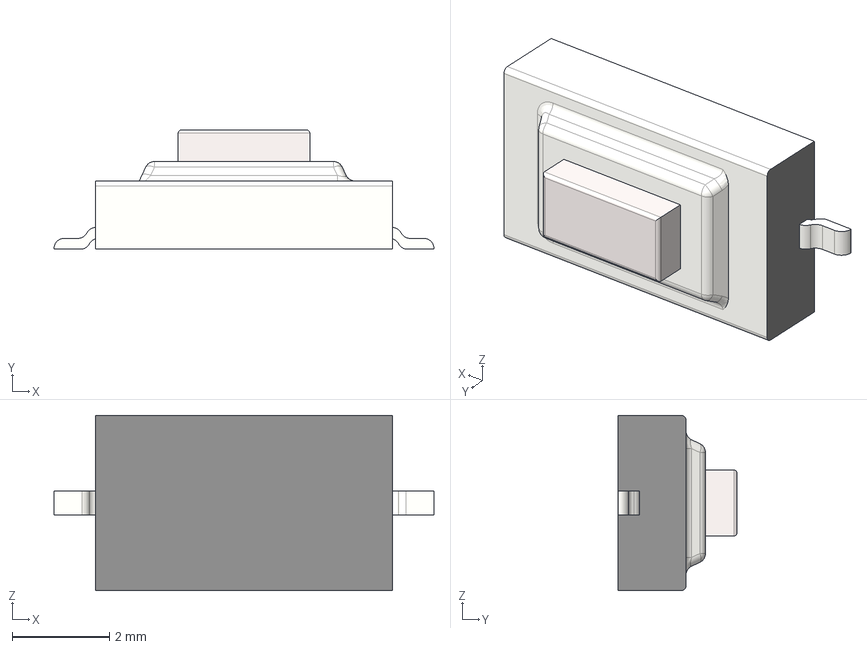
[picture p68: CAD file, 2025-12-03]
2nd_prototype_LCRmeter/3D_Models/TactileButton(6x3,5mm)_SMD.stp
7.80 x 2.45 x 3.60 mm
