degesz/LATEX_Bakalarka/2nd_prototype_LCRmeter/3D_Models/73100-0131.STEP

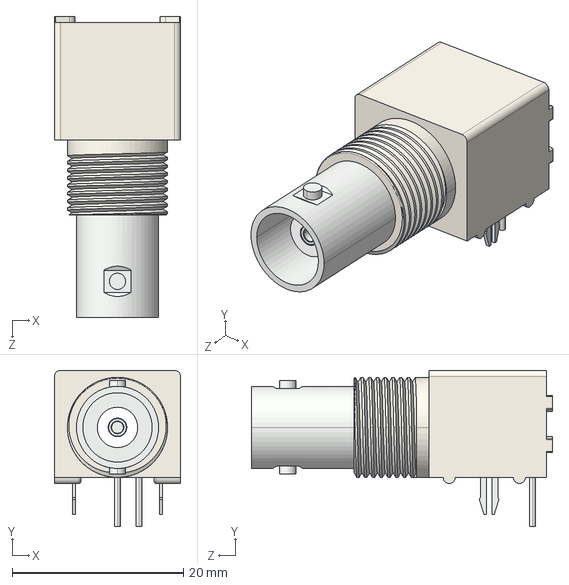
[picture p69: CAD file, 2025-12-03]
2nd_prototype_LCRmeter/3D_Models/73100-0131.STEP
14.8 x 18.2 x 35.2 mm
