degesz/LATEX_Bakalarka/Test_board_BAKALARKA/front_panel/production/gerb_1/How-to-order-PCB.txt

How to Order PCB

Please refer to:
https://prodocs.easyeda.com/en/pcb/order-order-pcb/index.html
