degesz/LATEX_Bakalarka/Test_board_BAKALARKA/front_panel/back_print.png

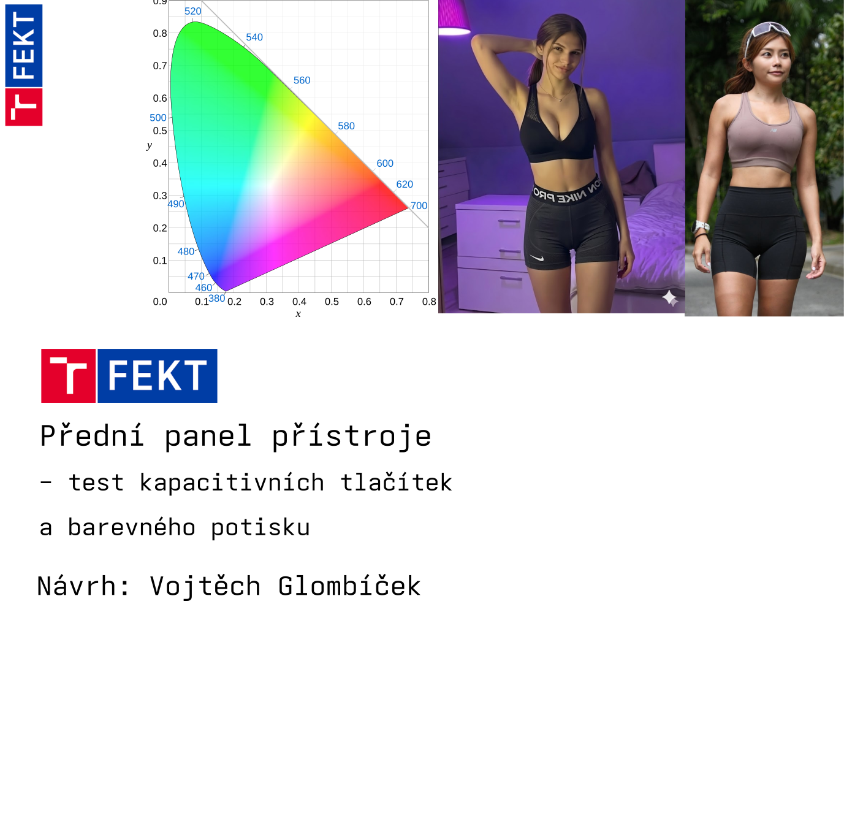
Test_board_BAKALARKA/front_panel/back_print.png
