degesz/LATEX_Bakalarka/Test_board_BAKALARKA/front_panel/front_print.png

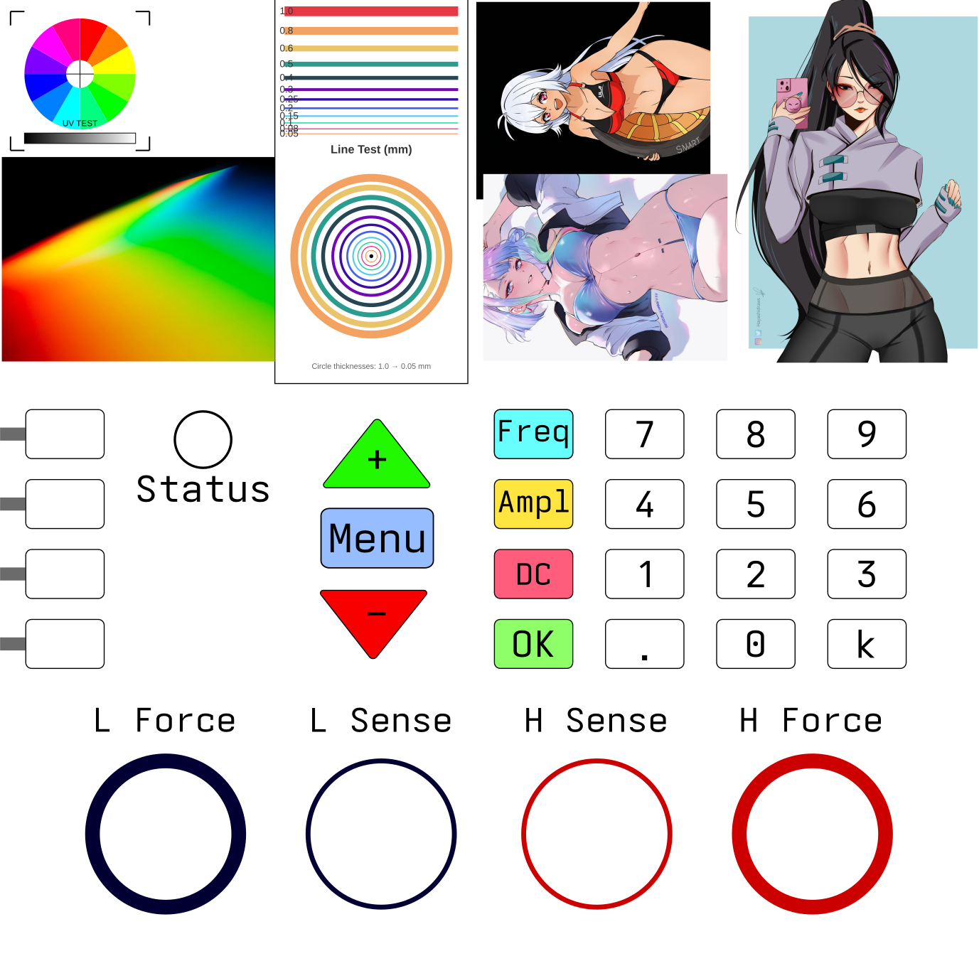
Test_board_BAKALARKA/front_panel/front_print.png
