degesz/LATEX_Bakalarka/Measurements/1000lcr_measurements_20260505_213827.csv

index | elapsed_s | model | series_r | series_l | series_c | current_phase_deg | voltage_phase_deg | samples_per_period | current_amplitude_a | shunt_resistance_ohm | current_pga | phase_diff_deg | dds_frequency_hz | shunt_range | voltage_pga | impedance_mag_ohm | impedance_imag_ohm | captured_cycles | voltage_amplitude_v | impedance_real_ohm | sample_rate_hz
1 | 0.055633 | Series RL | 0.344724 | 0.000108166967354 |  | -130.368652 | 139.050109 | 20.000000 | 0.007850 | 100.000000 | 0 | 89.418792 | 50000 | 0 | 0 | 33.983402 | 33.981655 | 20.000000 | 0.266763 | 0.344724 | 1000000
2 | 0.113849 | Series RL | 0.309534 | 0.000108025443595 |  | -23.397192 | -113.919761 | 20.000000 | 0.007852 | 100.000000 | 0 | 89.477432 | 50000 | 0 | 0 | 33.938606 | 33.937194 | 20.000000 | 0.266501 | 0.309534 | 1000000
3 | 0.169950 | Series RL | 0.483679 | 0.000108155842423 |  | -60.748580 | -151.564132 | 20.000000 | 0.007854 | 100.000000 | 0 | 89.184448 | 50000 | 0 | 0 | 33.981601 | 33.978160 | 20.000000 | 0.266875 | 0.483679 | 1000000
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
