degesz/LATEX_Bakalarka/Measurements/1X_1000SAMPLES_100.csv

index | elapsed_s | model | series_r | series_l | series_c | shunt_range | voltage_pga | impedance_imag_ohm | impedance_real_ohm | phase_diff_deg | shunt_resistance_ohm | current_pga | current_phase_deg | impedance_mag_ohm | samples_per_period | current_amplitude_a | sample_rate_hz | captured_cycles | dds_frequency_hz | voltage_amplitude_v | voltage_phase_deg
1 | 0.390346 | Series RL | 0.598305 | 0.000108521797994 |  | 0 | 0 | 40.911754 | 0.598305 | 89.162147 | 100.000000 | 0 | -0.200514 | 40.916126 | 16.666666 | 0.007765 | 1000000 | 60.000003 | 60000 | 0.317701 | -91.038360
2 | 0.777401 | Series RL | 0.539678 | 0.000108561302904 |  | 0 | 0 | 40.926647 | 0.539678 | 89.244506 | 100.000000 | 0 | -5.266184 | 40.930206 | 16.666666 | 0.007764 | 1000000 | 60.000003 | 60000 | 0.317784 | -96.021667
3 | 1.164556 | Series RL | 0.559295 | 0.00010854257302 |  | 0 | 0 | 40.919586 | 0.559295 | 89.216918 | 100.000000 | 0 | 81.587768 | 40.923408 | 16.666666 | 0.007766 | 1000000 | 60.000003 | 60000 | 0.317824 | -9.195309
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
