degesz/LATEX_Bakalarka/Measurements/1X_400SAMPLES_300.csv

index | elapsed_s | model | series_r | series_l | series_c | shunt_range | voltage_pga | impedance_imag_ohm | impedance_real_ohm | phase_diff_deg | shunt_resistance_ohm | current_pga | current_phase_deg | impedance_mag_ohm | samples_per_period | current_amplitude_a | sample_rate_hz | captured_cycles | dds_frequency_hz | voltage_amplitude_v | voltage_phase_deg
1 | 0.105638 | Series RL | 0.569612 | 0.000108663209814 |  | 0 | 0 | 40.965065 | 0.569612 | 89.203361 | 100.000000 | 0 | 66.858863 | 40.969024 | 16.666666 | 0.007763 | 1000000 | 24.000000 | 60000 | 0.318038 | -23.937776
2 | 0.159535 | Series RL | 0.608276 | 0.000108523527478 |  | 0 | 0 | 40.912406 | 0.608276 | 89.148200 | 100.000000 | 0 | -27.672140 | 40.916927 | 16.666666 | 0.007763 | 1000000 | 24.000000 | 60000 | 0.317650 | -118.523941
3 | 0.212827 | Series RL | 0.533992 | 0.000108574032647 |  | 0 | 0 | 40.931446 | 0.533992 | 89.252563 | 100.000000 | 0 | -30.930326 | 40.934928 | 16.666666 | 0.007762 | 1000000 | 24.000000 | 60000 | 0.317740 | -121.677764
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
