degesz/LATEX_Bakalarka/Measurements/2X_1000SAMPLES_100.csv

index | elapsed_s | model | series_r | series_l | series_c | shunt_range | voltage_pga | impedance_imag_ohm | impedance_real_ohm | phase_diff_deg | shunt_resistance_ohm | current_pga | current_phase_deg | impedance_mag_ohm | samples_per_period | current_amplitude_a | sample_rate_hz | captured_cycles | dds_frequency_hz | voltage_amplitude_v | voltage_phase_deg
1 | 0.410858 | Series RL | 0.191815 | 0.000107869116836 |  | 0 | 1 | 40.665699 | 0.191815 | 89.729743 | 100.000000 | 1 | 159.627090 | 40.666149 | 16.666666 | 0.007515 | 1000000 | 60.000003 | 60000 | 0.305586 | 69.356834
2 | 0.798367 | Series RL | 0.206072 | 0.000107843888125 |  | 0 | 1 | 40.656188 | 0.206072 | 89.709587 | 100.000000 | 1 | -156.798904 | 40.656711 | 16.666666 | 0.007516 | 1000000 | 60.000003 | 60000 | 0.305583 | 112.910667
3 | 1.186502 | Series RL | 0.203424 | 0.000107868488174 |  | 0 | 1 | 40.665462 | 0.203424 | 89.713386 | 100.000000 | 1 | 107.624214 | 40.665969 | 16.666666 | 0.007516 | 1000000 | 60.000003 | 60000 | 0.305651 | 17.337600
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
