degesz/LATEX_Bakalarka/Measurements/2X_400SAMPLES_300.csv

index | elapsed_s | model | series_r | series_l | series_c | shunt_range | voltage_pga | impedance_imag_ohm | impedance_real_ohm | phase_diff_deg | shunt_resistance_ohm | current_pga | current_phase_deg | impedance_mag_ohm | samples_per_period | current_amplitude_a | sample_rate_hz | captured_cycles | dds_frequency_hz | voltage_amplitude_v | voltage_phase_deg
1 | 0.107177 | Series RL | 0.182905 | 0.000107803868614 |  | 0 | 1 | 40.641101 | 0.182905 | 89.742141 | 100.000000 | 1 | -34.490848 | 40.641513 | 16.666666 | 0.007515 | 1000000 | 24.000000 | 60000 | 0.305432 | -124.748695
2 | 0.161450 | Series RL | 0.189718 | 0.000107892822964 |  | 0 | 1 | 40.674636 | 0.189718 | 89.732757 | 100.000000 | 1 | 77.204864 | 40.675079 | 16.666666 | 0.007516 | 1000000 | 24.000000 | 60000 | 0.305704 | -13.062384
3 | 0.216494 | Series RL | 0.208121 | 0.000107840328359 |  | 0 | 1 | 40.654846 | 0.208121 | 89.706695 | 100.000000 | 1 | -127.893486 | 40.655380 | 16.666666 | 0.007517 | 1000000 | 24.000000 | 60000 | 0.305597 | 141.813186
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
