degesz/LATEX_Bakalarka/Measurements/c_big_100khz_1k_500.csv

index | elapsed_s | model | series_r | series_l | series_c | impedance_imag_ohm | phase_diff_deg | current_phase_deg | sample_rate_hz | current_amplitude_a | samples_per_period | voltage_pga | impedance_mag_ohm | voltage_amplitude_v | shunt_resistance_ohm | voltage_phase_deg | current_pga | dds_frequency_hz | shunt_range | impedance_real_ohm | captured_cycles
1 | 0.202428 | Series RC | -1.043635 |  | 5.35368701975e-07 | -2.972810 | -109.344146 | -177.450653 | 1000000 | 0.009000 | 10.000000 | 1 | 3.150678 | 0.028357 | 100.000000 | -106.794792 | 0 | 100000 | 0 | -1.043635 | 50.000000
2 | 0.375856 | Series RC | -0.935867 |  | 5.16426972037e-07 | -3.081848 | -106.891990 | 25.594417 | 1000000 | 0.009025 | 10.000000 | 1 | 3.220812 | 0.029067 | 100.000000 | 98.702438 | 0 | 100000 | 0 | -0.935867 | 50.000000
3 | 0.549622 | Series RC | -0.894741 |  | 5.72190853399e-07 | -2.781501 | -107.831718 | 48.573802 | 1000000 | 0.009028 | 10.000000 | 1 | 2.921868 | 0.026380 | 100.000000 | 120.742080 | 0 | 100000 | 0 | -0.894741 | 50.000000
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
