degesz/LATEX_Bakalarka/Test_board_BAKALARKA/front_panel/graphics/1263143766426292228_1.jpg

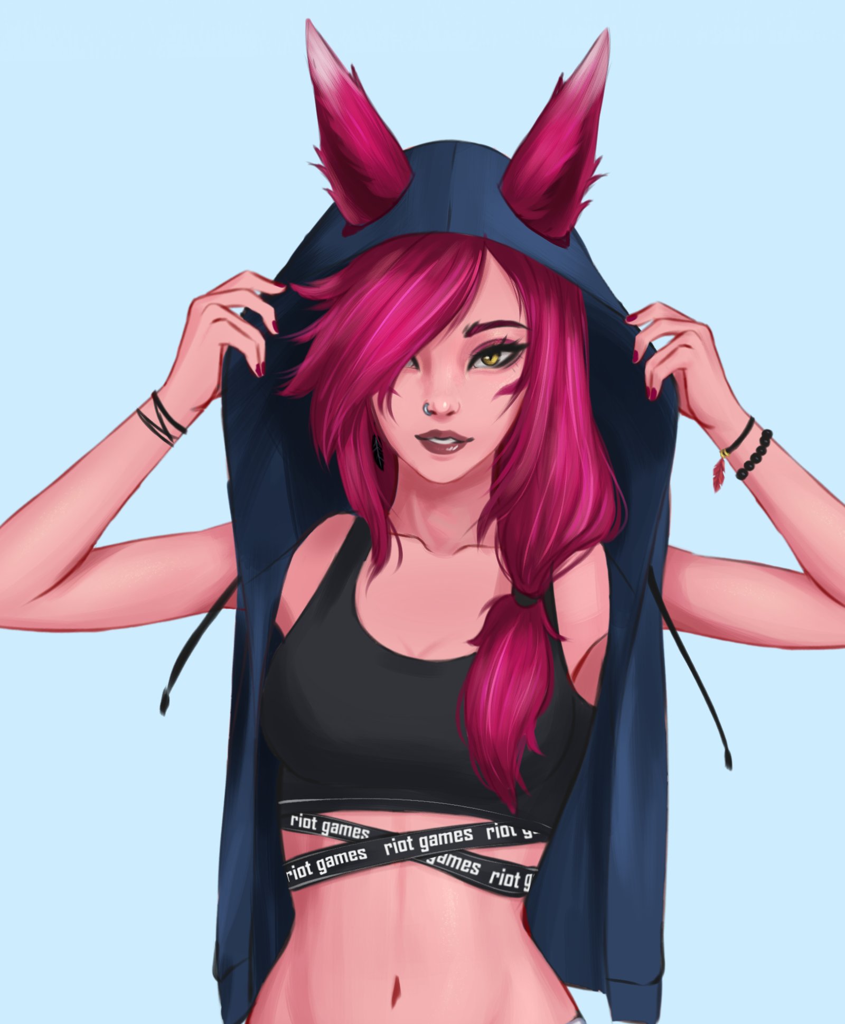
Test_board_BAKALARKA/front_panel/graphics/1263143766426292228_1.jpg
