degesz/LATEX_Bakalarka/Test_board_BAKALARKA/front_panel/graphics/1651703691420790786_1.jpg

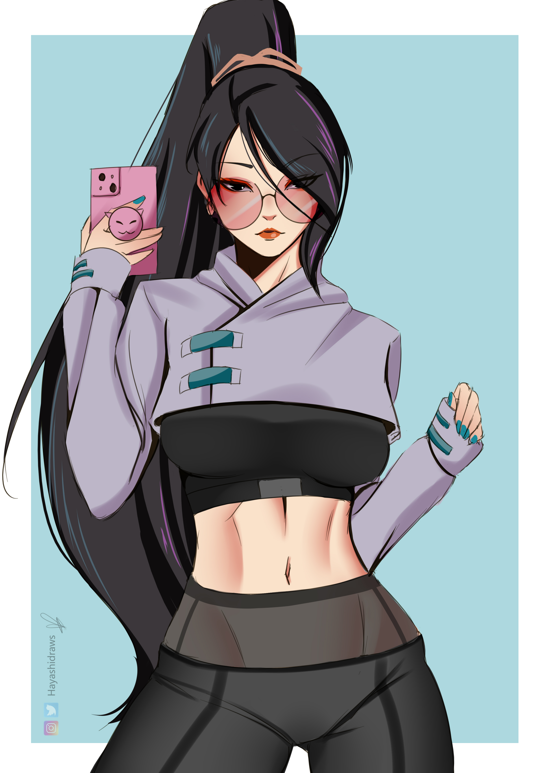
Test_board_BAKALARKA/front_panel/graphics/1651703691420790786_1.jpg
