degesz/LATEX_Bakalarka/Test_board_BAKALARKA/front_panel/graphics/images.png

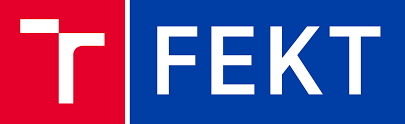
Test_board_BAKALARKA/front_panel/graphics/images.png
