degesz/LATEX_Bakalarka/Test_board_BAKALARKA/front_panel/graphics/jkjklliiiii.jpg

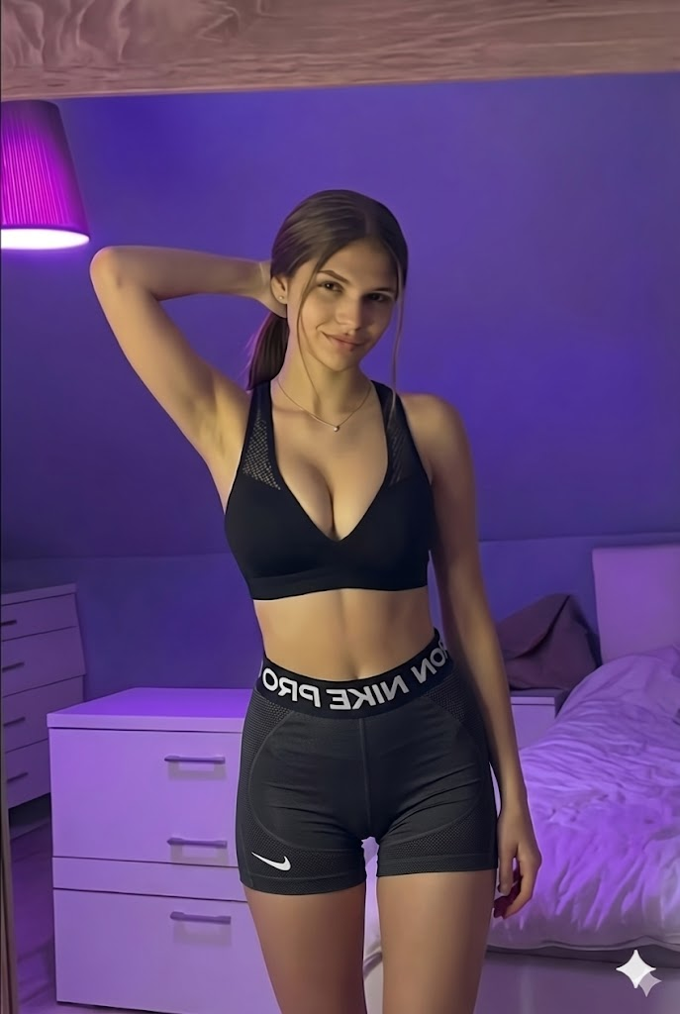
Test_board_BAKALARKA/front_panel/graphics/jkjklliiiii.jpg
