degesz/LATEX_Bakalarka/Test_board_BAKALARKA/front_panel/graphics/lucy_CyberpunkEdgerunners.jpg

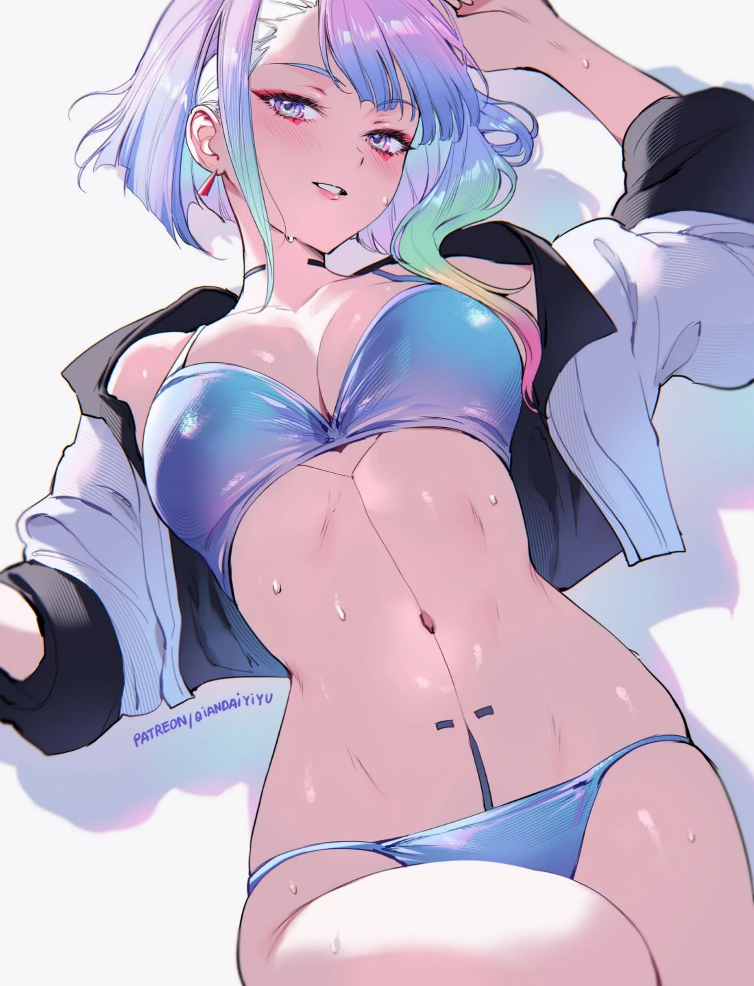
Test_board_BAKALARKA/front_panel/graphics/lucy_CyberpunkEdgerunners.jpg
