degesz/LATEX_Bakalarka/Test_board_BAKALARKA/front_panel/graphics/Screenshot_20251228-192421.png

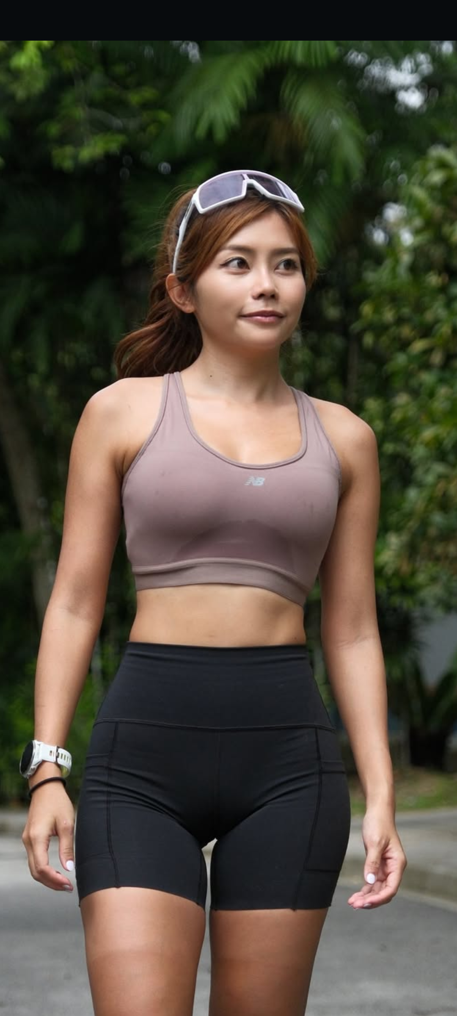
Test_board_BAKALARKA/front_panel/graphics/Screenshot_20251228-192421.png
