degesz/LATEX_Bakalarka/Test_board_BAKALARKA/front_panel/graphics/ULAchan.jpg

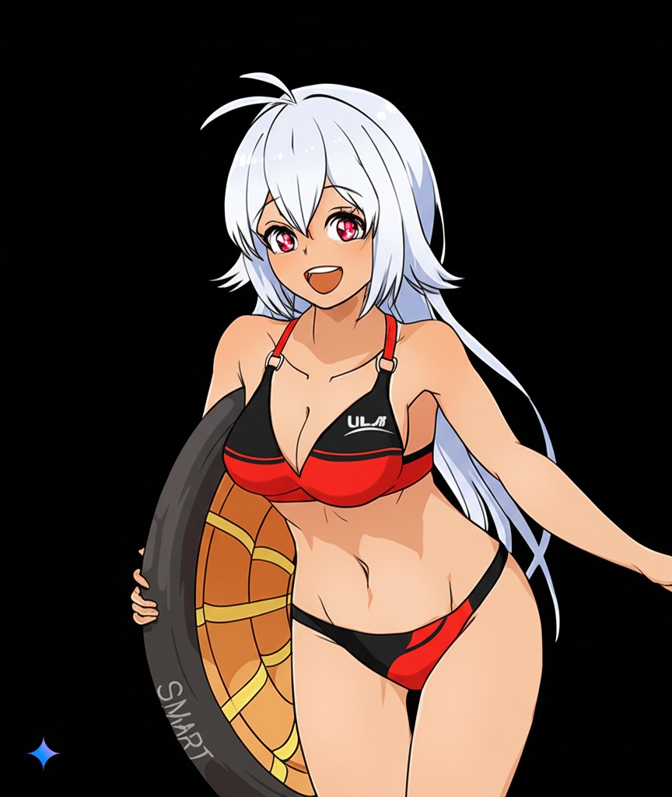
Test_board_BAKALARKA/front_panel/graphics/ULAchan.jpg
