degesz/LATEX_Bakalarka/LATEX_Bakalarka/obrazky/schema+layout/Final_LCR_Meter_page_1.pdf

2

2

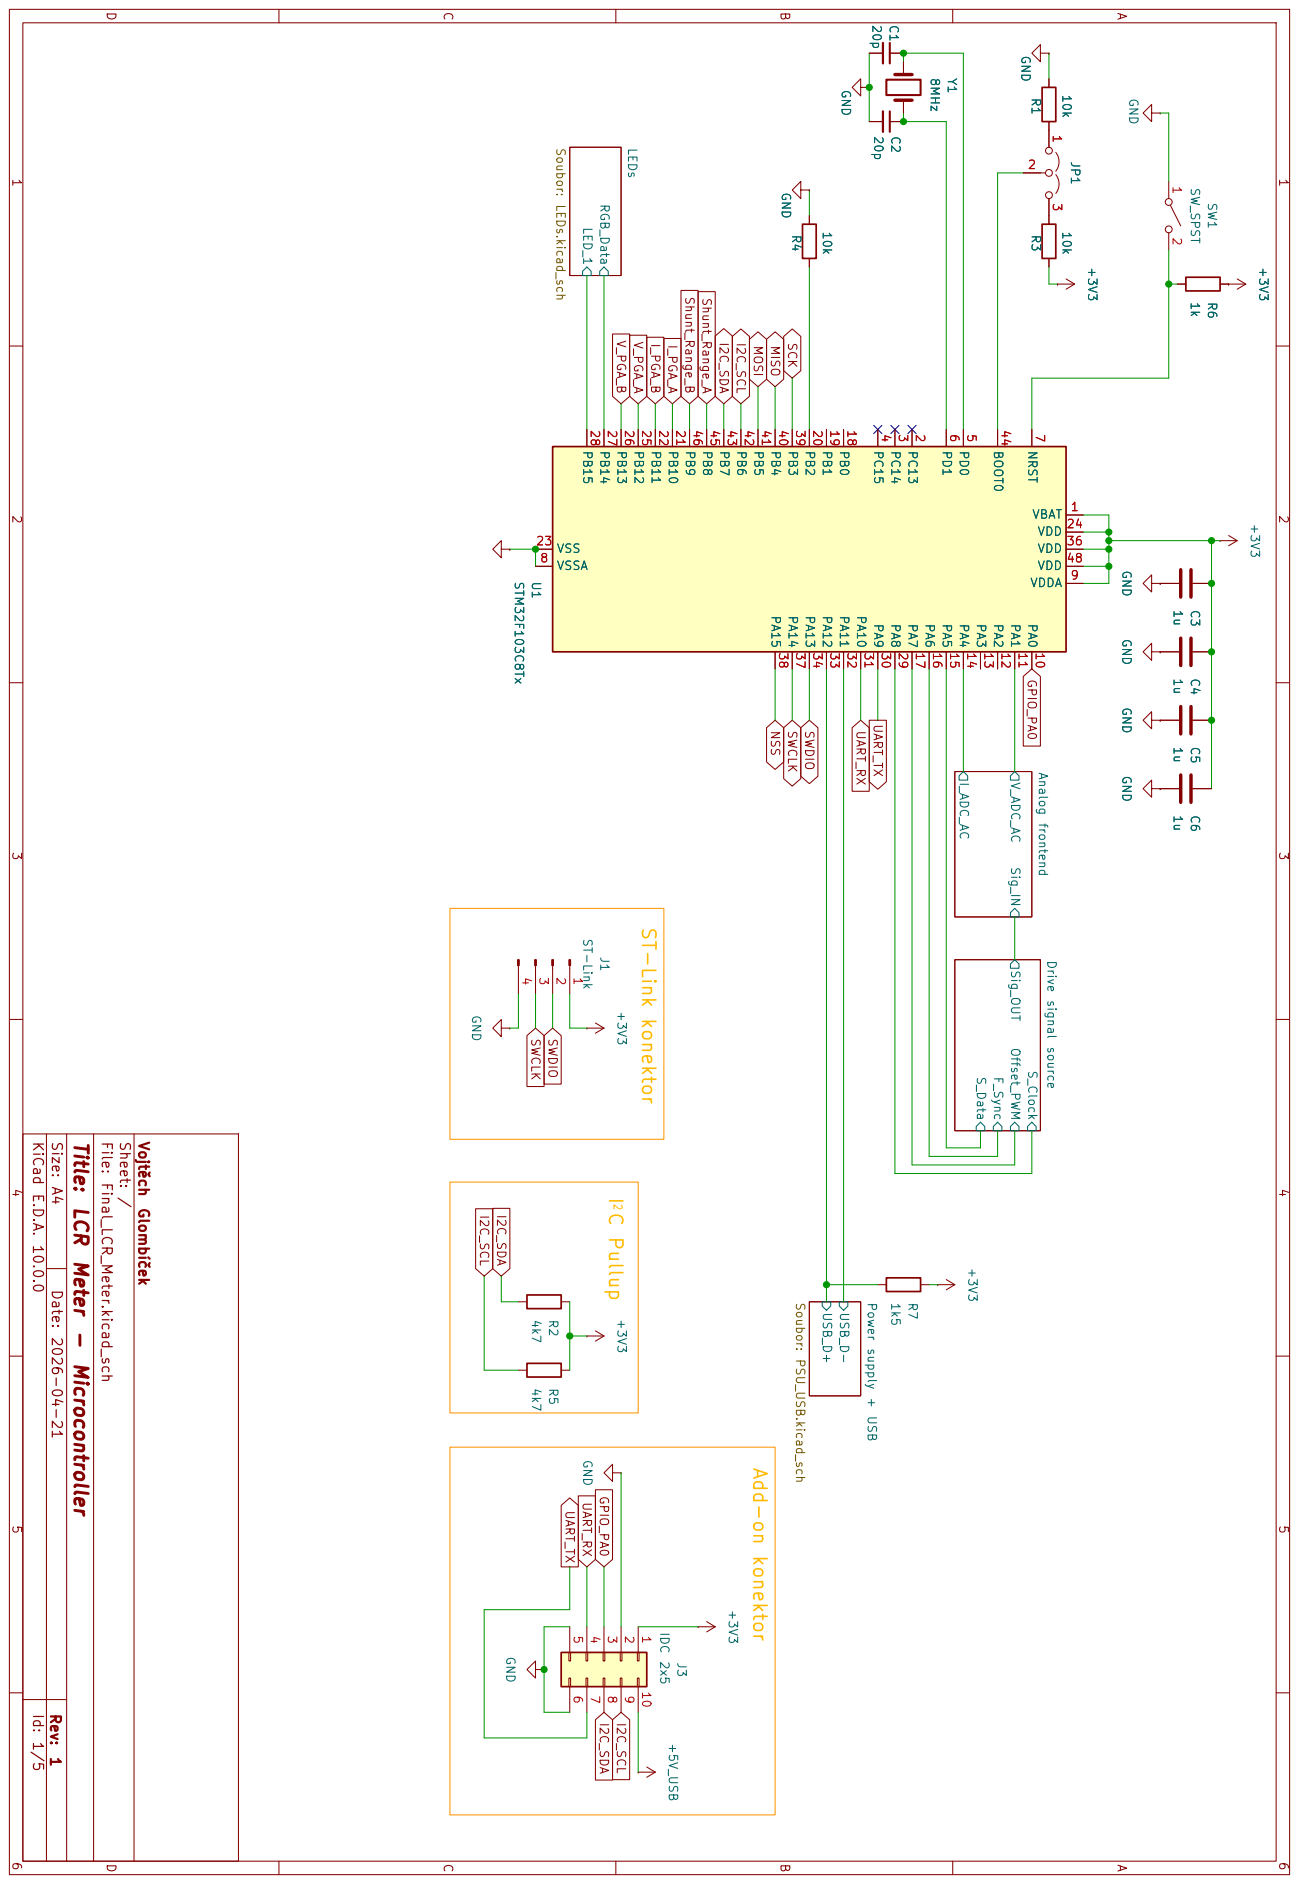
[picture p79: page 1]

SWDIO Net color tags

Date: 2026-04-21 KiCad E.D.A. 10.0.0 Rev: 1 Size: A4

Title: LCR Meter - Microcontroller
