degesz/LATEX_Bakalarka/LATEX_Bakalarka/obrazky/schema+layout/Final_LCR_Meter_page_2.pdf

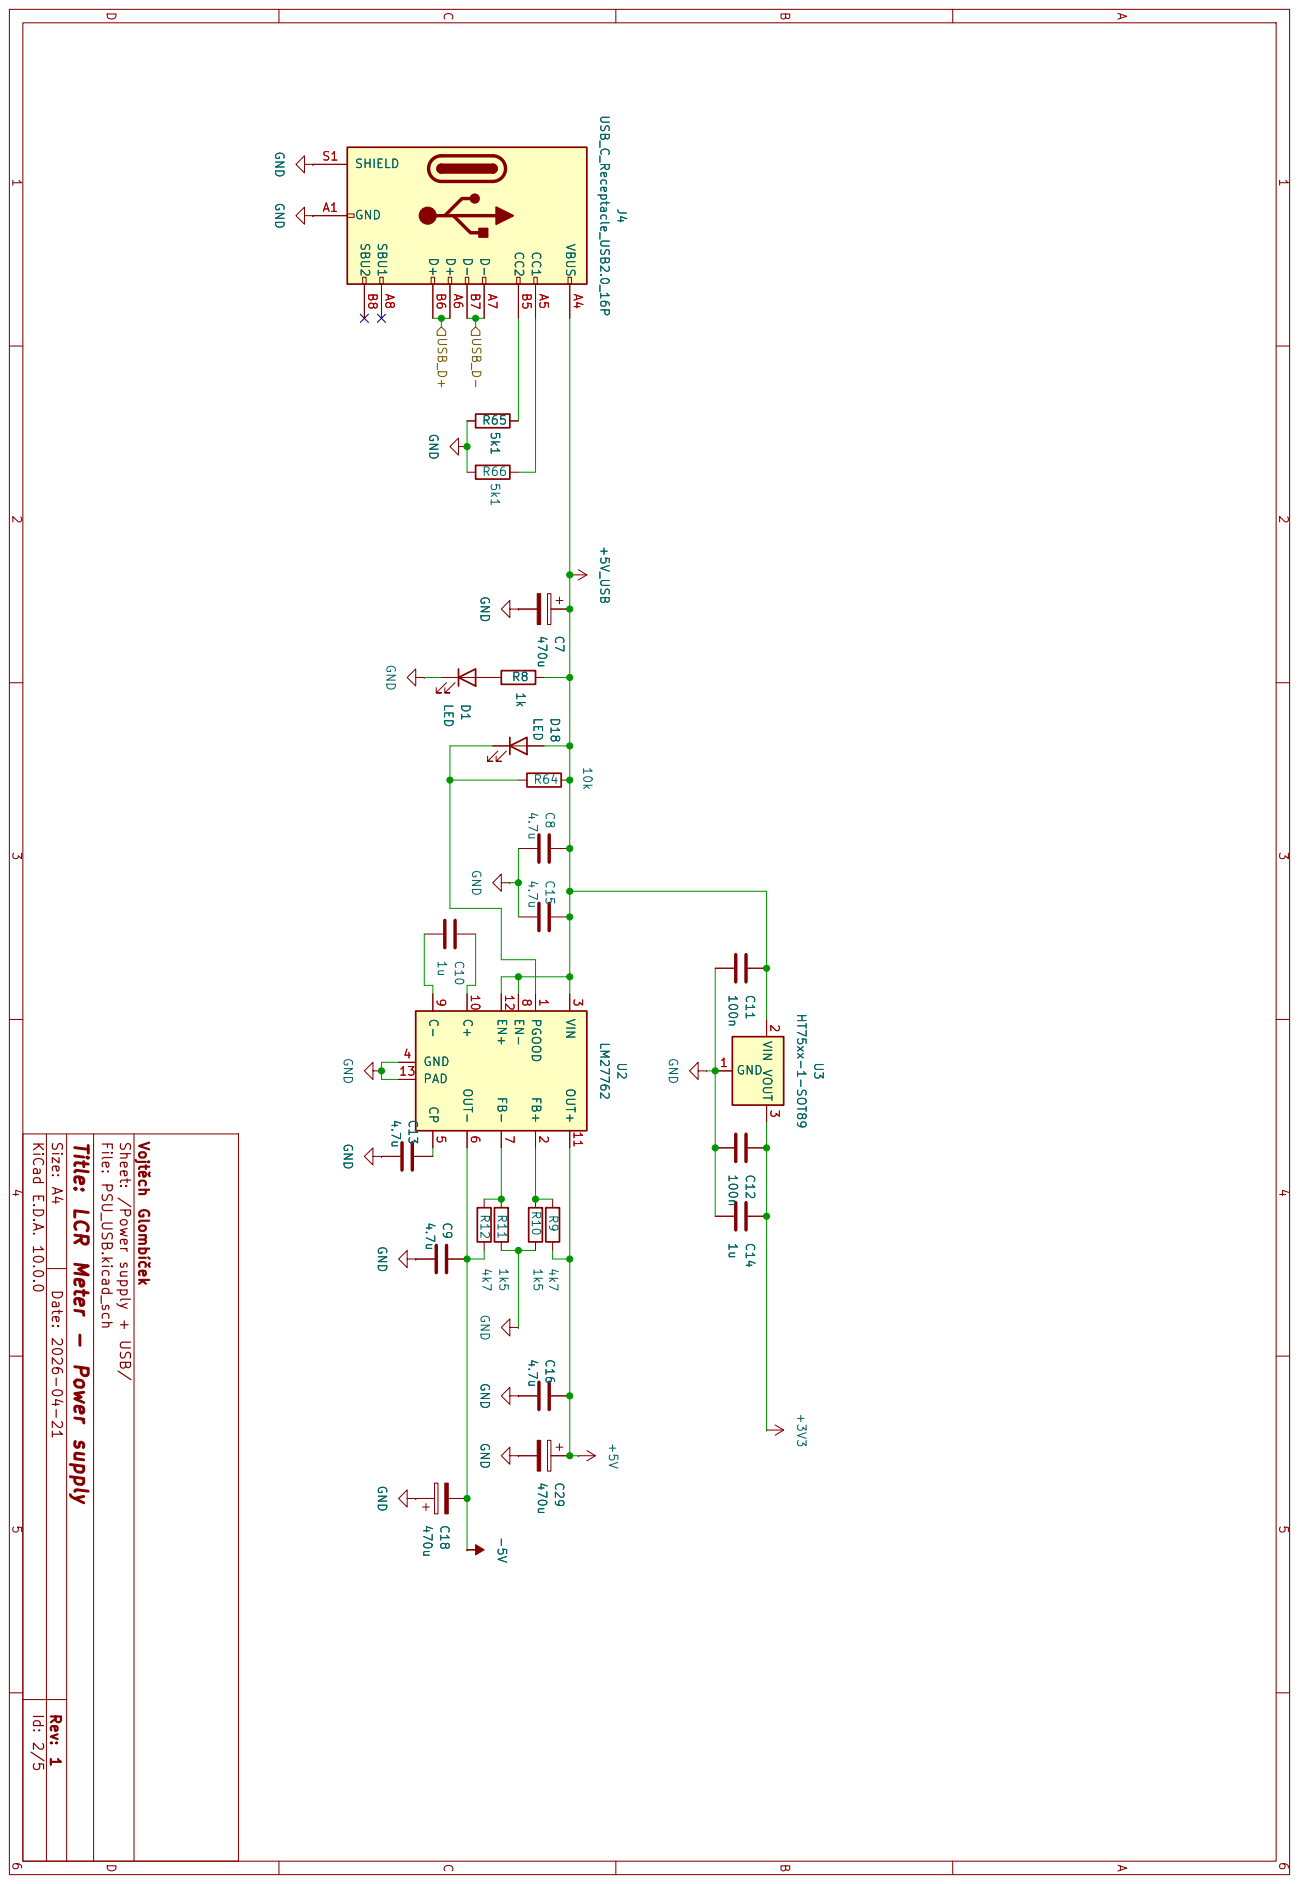
[picture p80: page 1]

Date: 2026-04-21 KiCad E.D.A. 10.0.0 Rev: 1 Size: A4

Title: LCR Meter - Power supply

Sheet: /Power supply + USB/
