degesz/LATEX_Bakalarka/LATEX_Bakalarka/obrazky/schema+layout/Final_LCR_Meter_page_3.pdf

8 | B

2

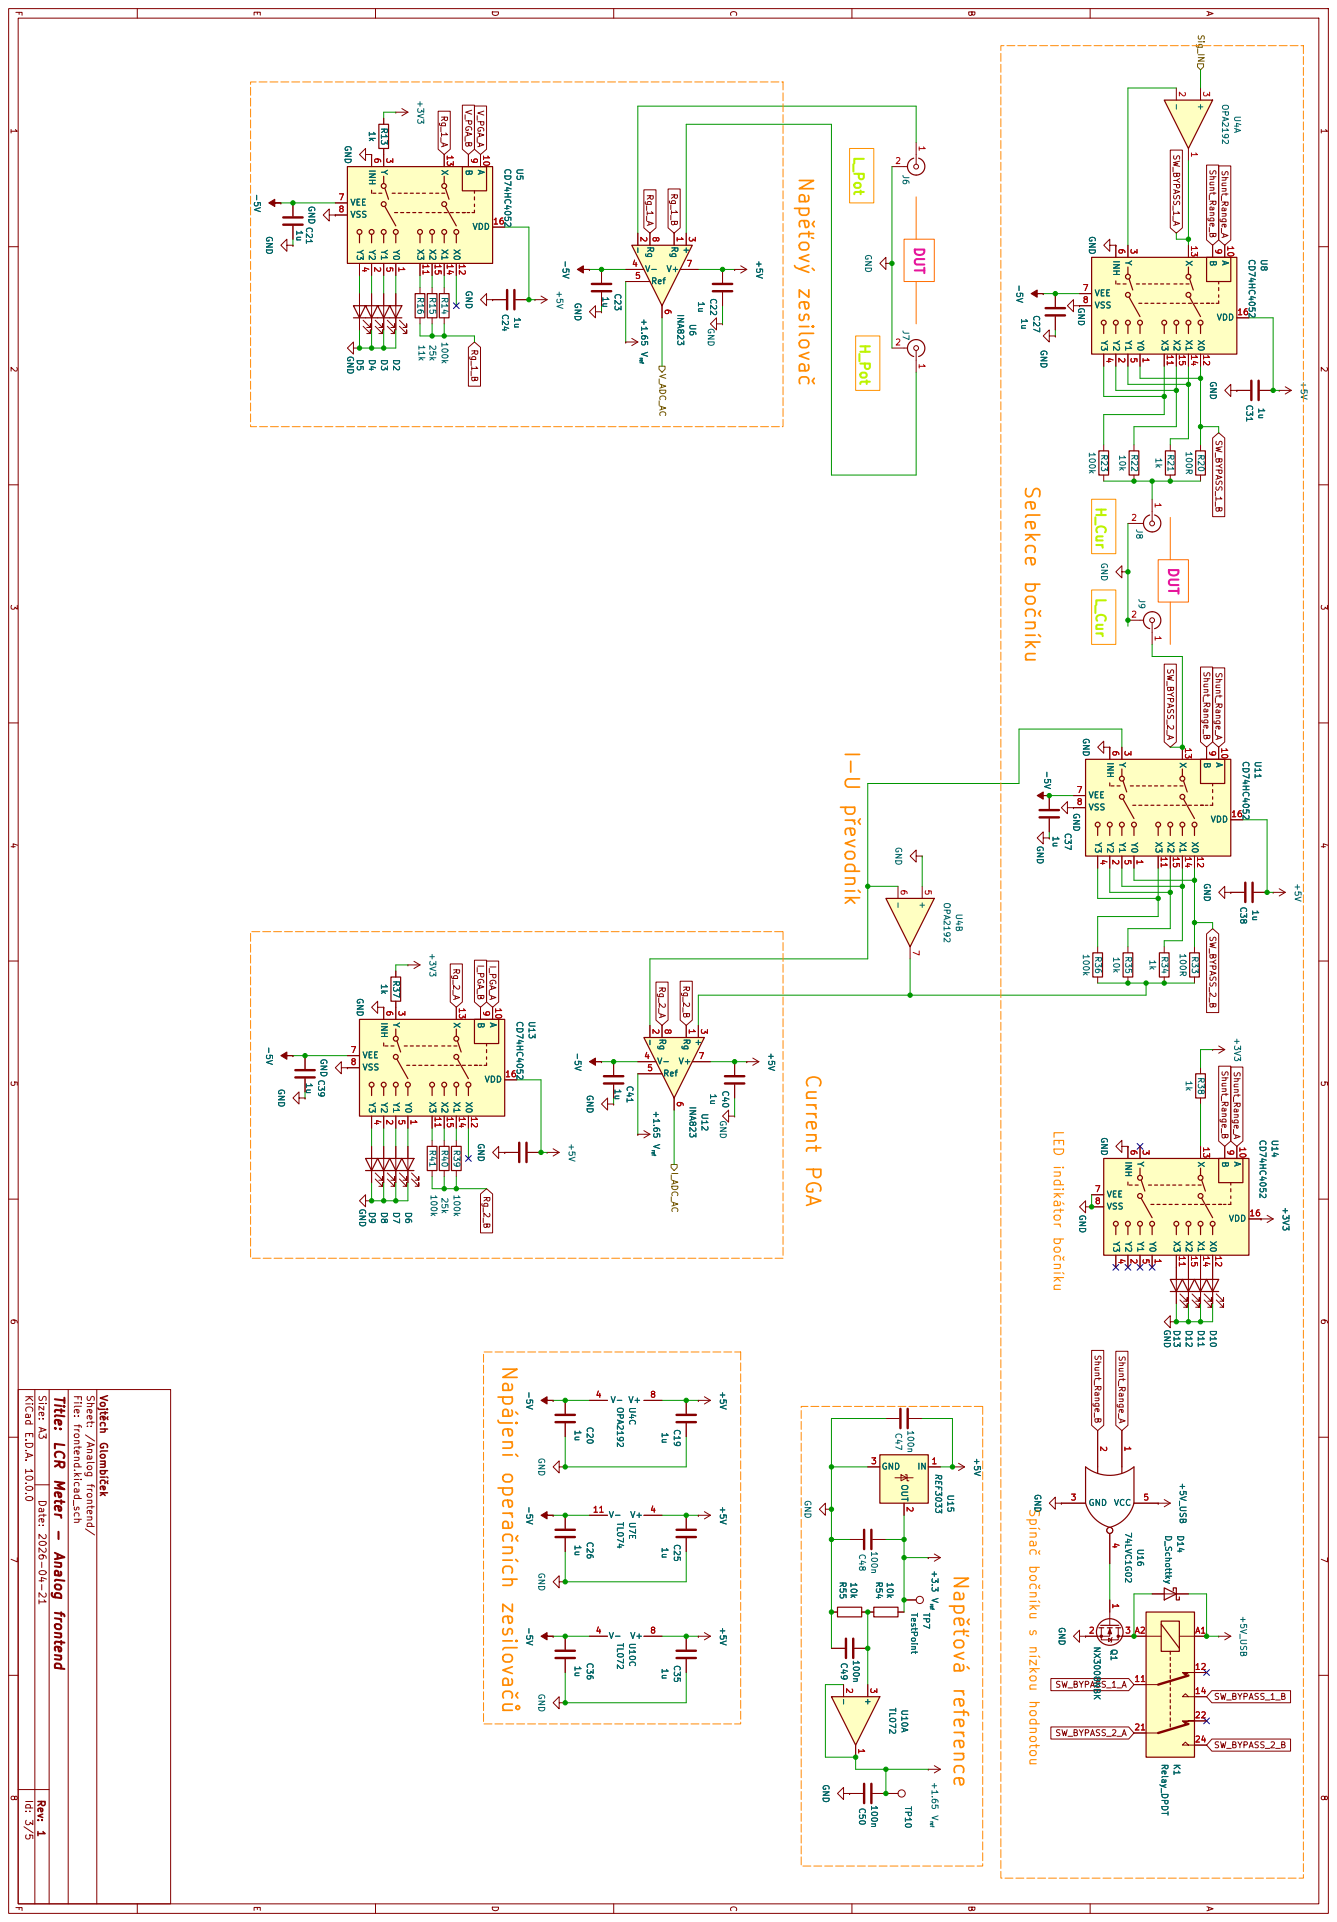
[picture p81: page 1]

Napěťový zesilovač Current PGA

Date: 2026-04-21 KiCad E.D.A. 10.0.0 Rev: 1 Size: A3

Title: LCR Meter - Analog frontend

Spínač bočníku s nízkou hodnotou
