degesz/LATEX_Bakalarka/LATEX_Bakalarka/obrazky/schema+layout/Final_LCR_Meter_page_4.pdf

4 V⁻ 11

## 2 OUT 3 Vcc 4

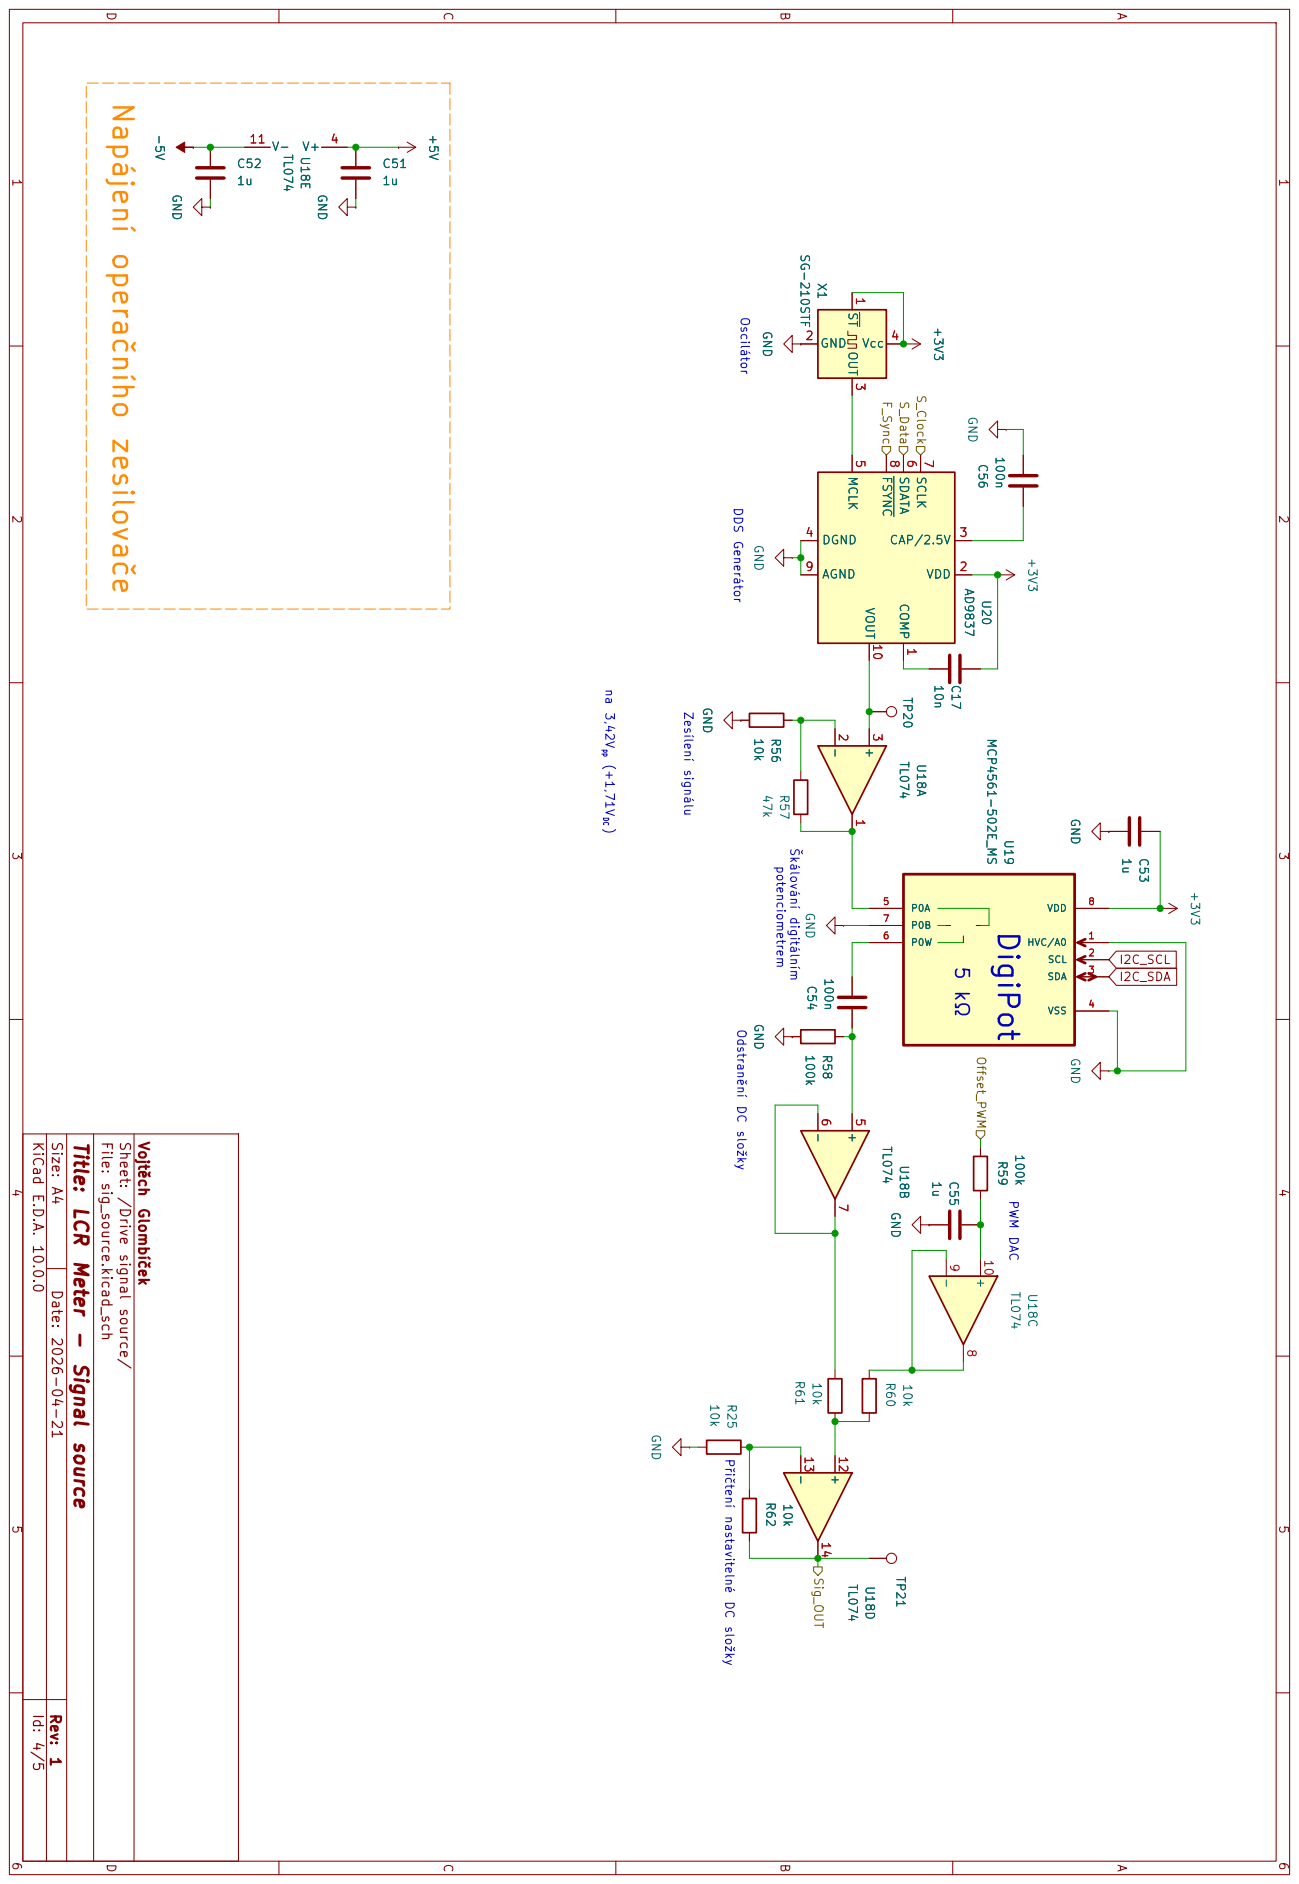
[picture p82: page 1]

Zesílení signálu Oscilátor Napájení operačního zesilovače

Přičtení nastavitelné DC složky DDS Generátor na 3,42V pp (+1,71V DC )

Date: 2026-04-21 KiCad E.D.A. 10.0.0 Rev: 1 Size: A4

Title: LCR Meter - Signal source

Sheet: /Drive signal source/
