degesz/LATEX_Bakalarka/LATEX_Bakalarka/obrazky/schema+layout/Final_LCR_Meter_page_5.pdf

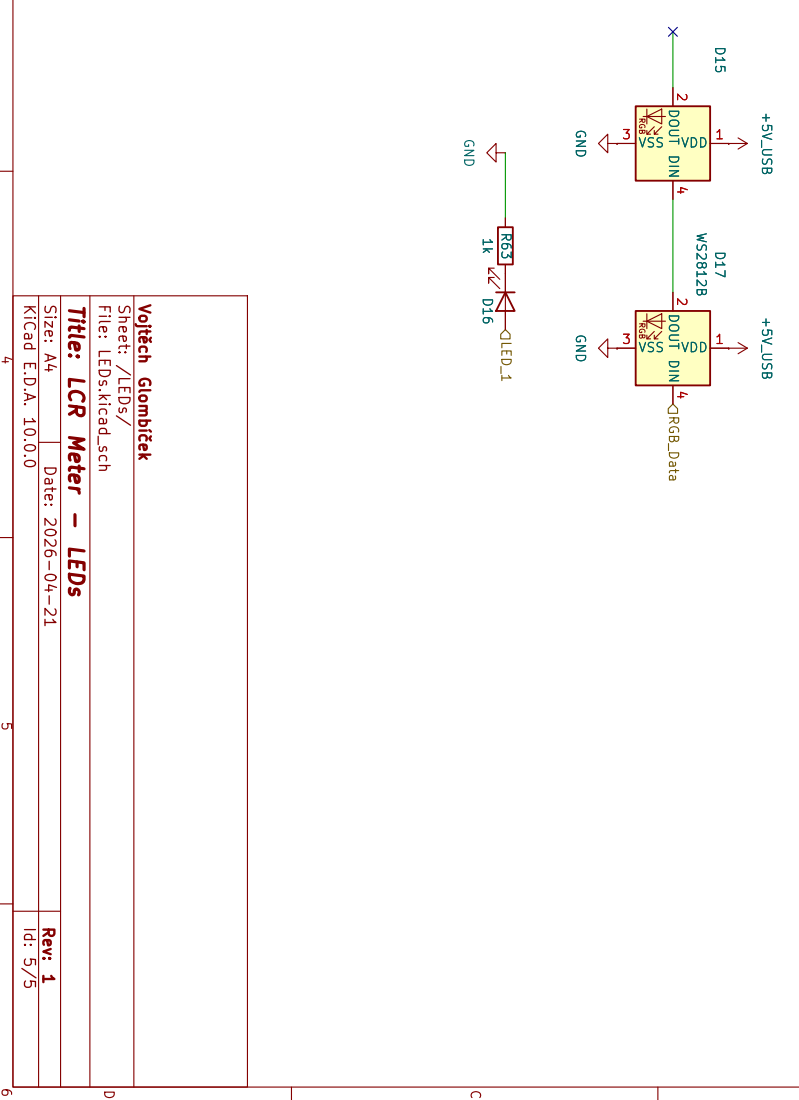
[picture p83: page 1]
File: LEDs.kicad_sch; Sheet: /LEDs/; RGB VDD; 1 DOUT 2 VSS; DIN; 4 D15 +5V_USB; GND; R63 1k +5V_USB; LED_1 RGB_Data D15 VDD; 4 +5V_USB; D17 WS2812B VDD

Vojtěch Glombíček GND

Date: 2026-04-21 KiCad E.D.A. 10.0.0 Rev: 1 Size: A4

Title: LCR Meter - LEDs
