degesz/LATEX_Bakalarka/LATEX_Bakalarka/obrazky/compensated.pdf

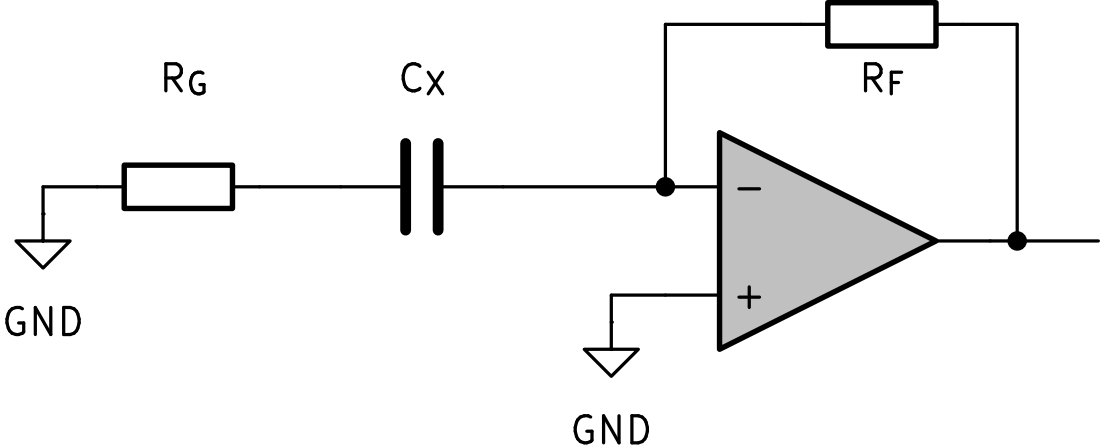
[picture p84: page 1]
