degesz/LATEX_Bakalarka/LATEX_Bakalarka/obrazky/uncompensated.pdf

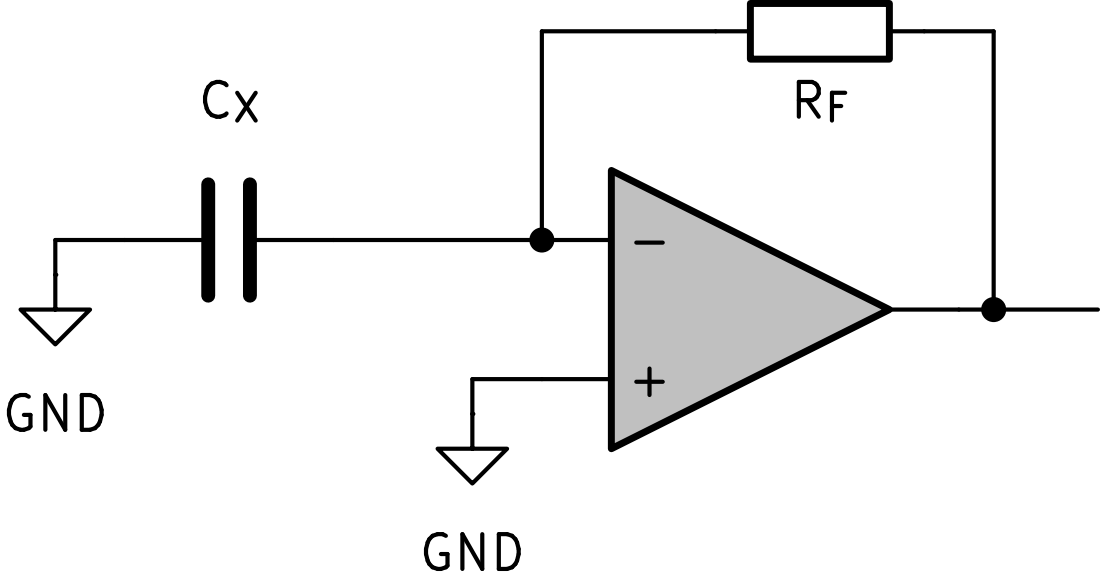
[picture p85: page 1]
