degesz/LATEX_Bakalarka/LATEX_Bakalarka/obrazky/4wire_connection.pdf

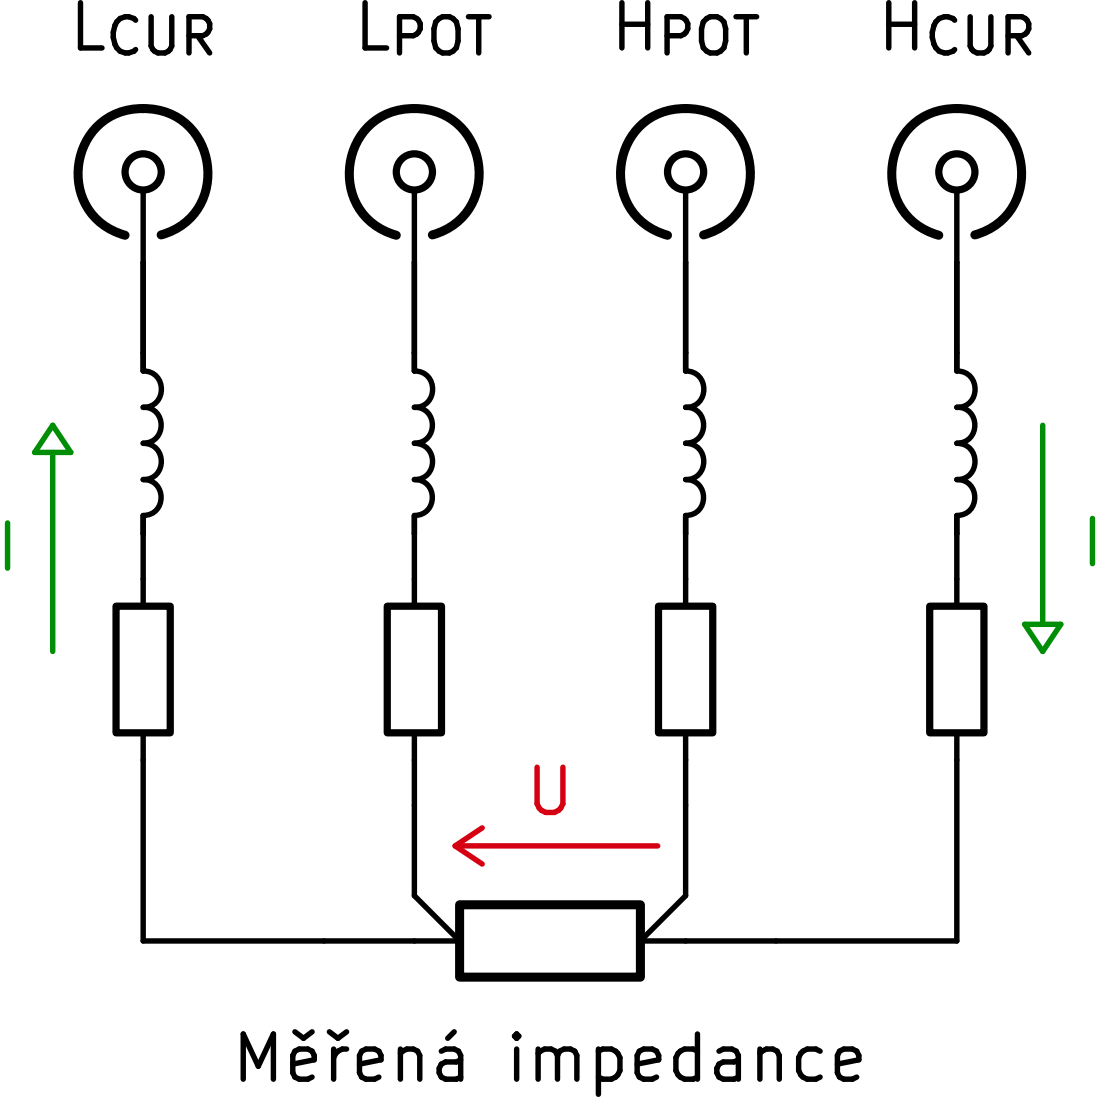
[picture p86: page 1]
