degesz/LATEX_Bakalarka/LATEX_Bakalarka/obrazky/4wire_diagram.pdf

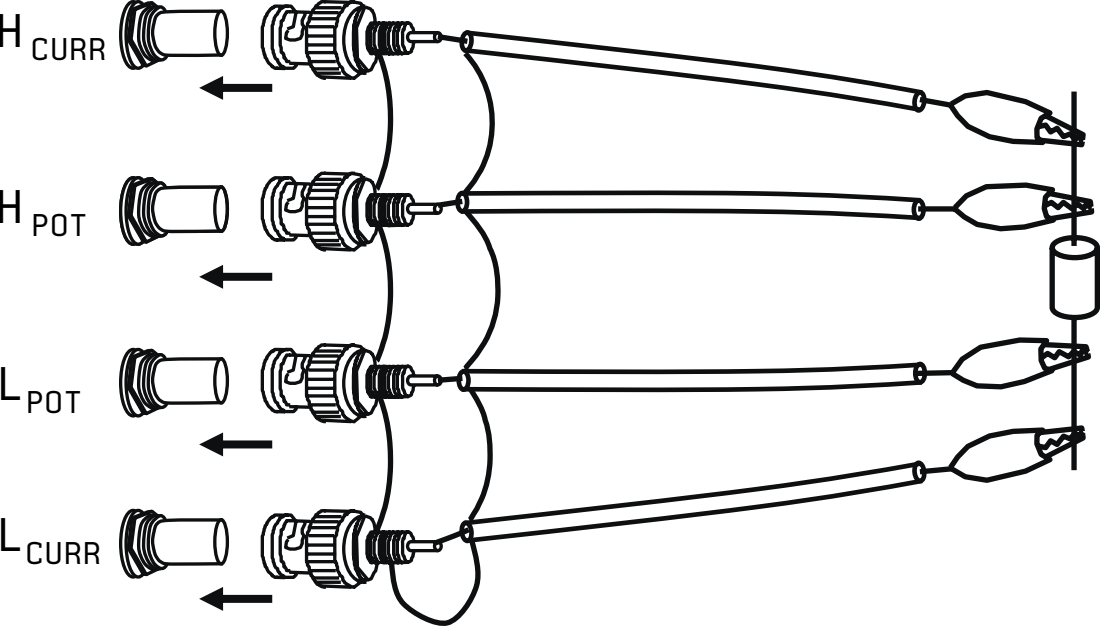
[picture p87: page 1]
HPOT; HCURR; LCURR; LPOT
