degesz/LATEX_Bakalarka/LATEX_Bakalarka/obrazky/4wire_diagram_with_current.pdf

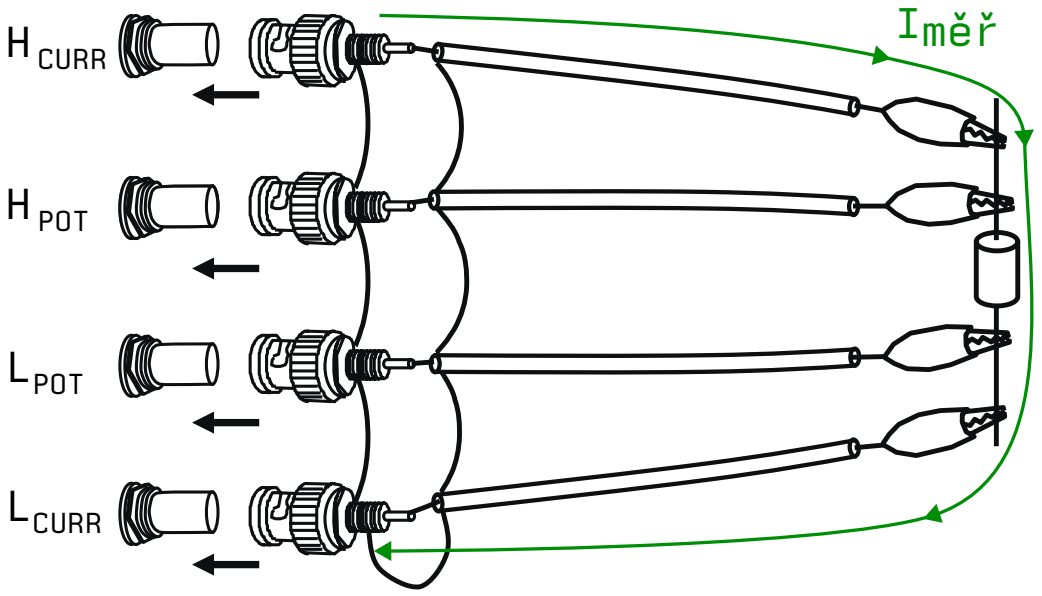
[picture p88: page 1]
měř

HPOT HCURR LCURR LPOT
