degesz/LATEX_Bakalarka/LATEX_Bakalarka/obrazky/range_switch.pdf

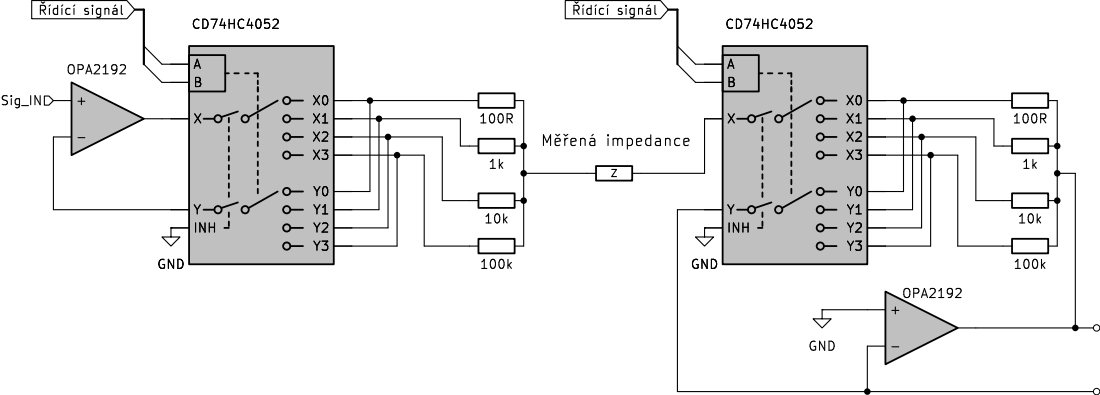
[picture p89: page 1]
