degesz/LATEX_Bakalarka/LATEX_Bakalarka/obrazky/block_diagram_meter.pdf

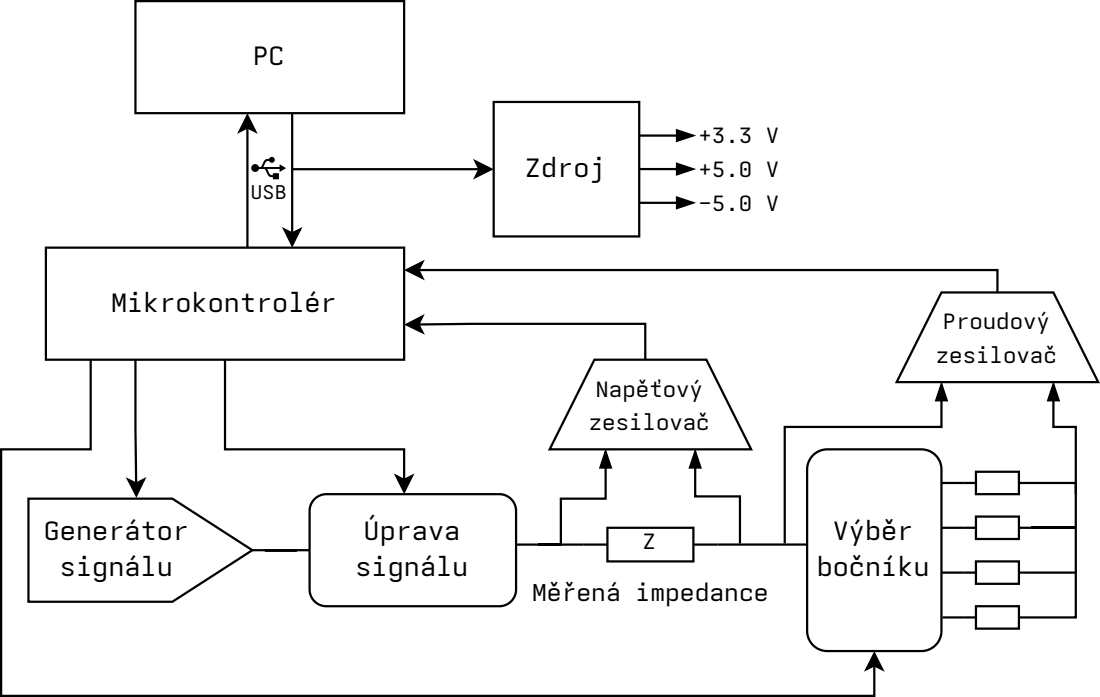
[picture p90: page 1]
Mikrokontrolér; USB; Úprava signálu; Výběr bočníku; Měřená impedance; Generátor signálu; Proudový zesilovač; Napěťový zesilovač; Zdroj
