degesz/LATEX_Bakalarka/LATEX_Bakalarka/obrazky/power_sch.pdf

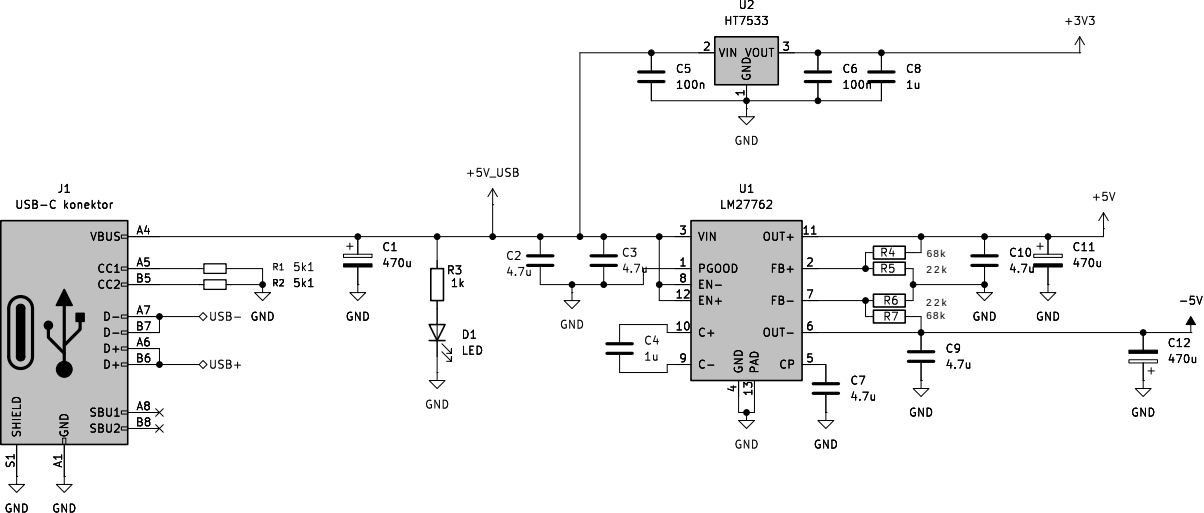
[picture p91: page 1]
