degesz/LATEX_Bakalarka/LATEX_Bakalarka/obrazky/sigsource_sch.pdf

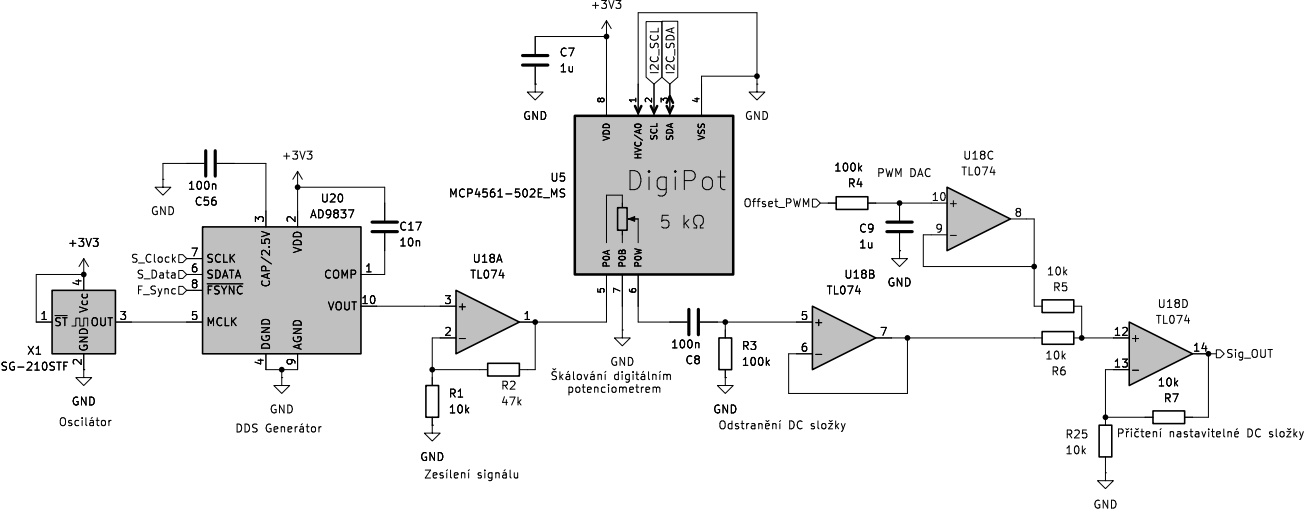
[picture p92: page 1]
