degesz/LATEX_Bakalarka/LATEX_Bakalarka/obrazky/wheatstone.pdf

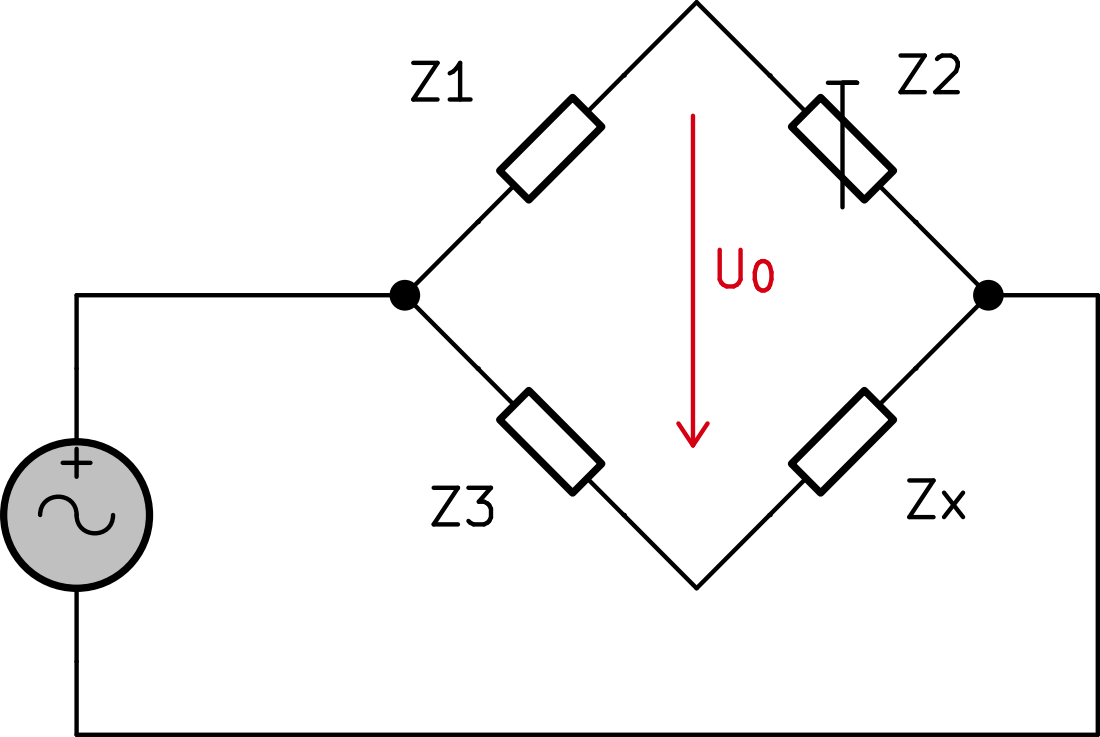
[picture p93: page 1]
