degesz/LATEX_Bakalarka/LATEX_Bakalarka/obrazky/adder_sch.pdf

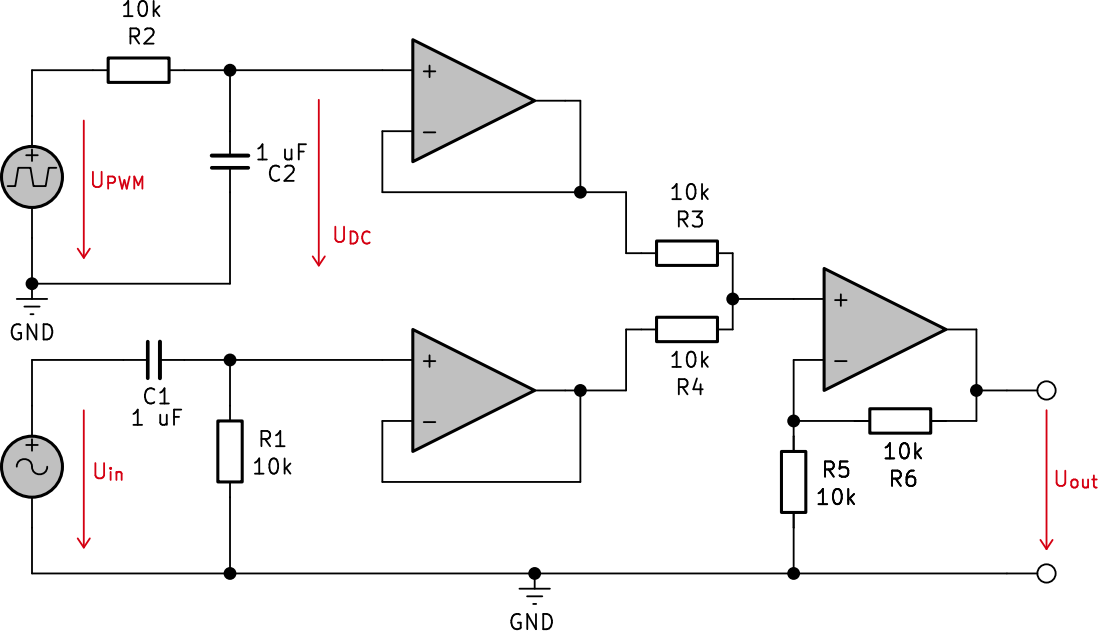
[picture p94: page 1]
