degesz/LATEX_Bakalarka/LATEX_Bakalarka/obrazky/amplitude_set_sch.pdf

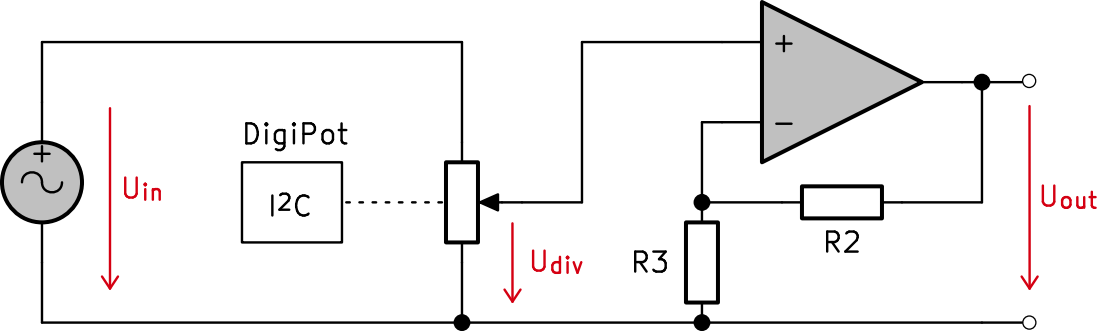
[picture p95: page 1]
