degesz/LATEX_Bakalarka/LATEX_Bakalarka/obrazky/DDS_chart.pdf

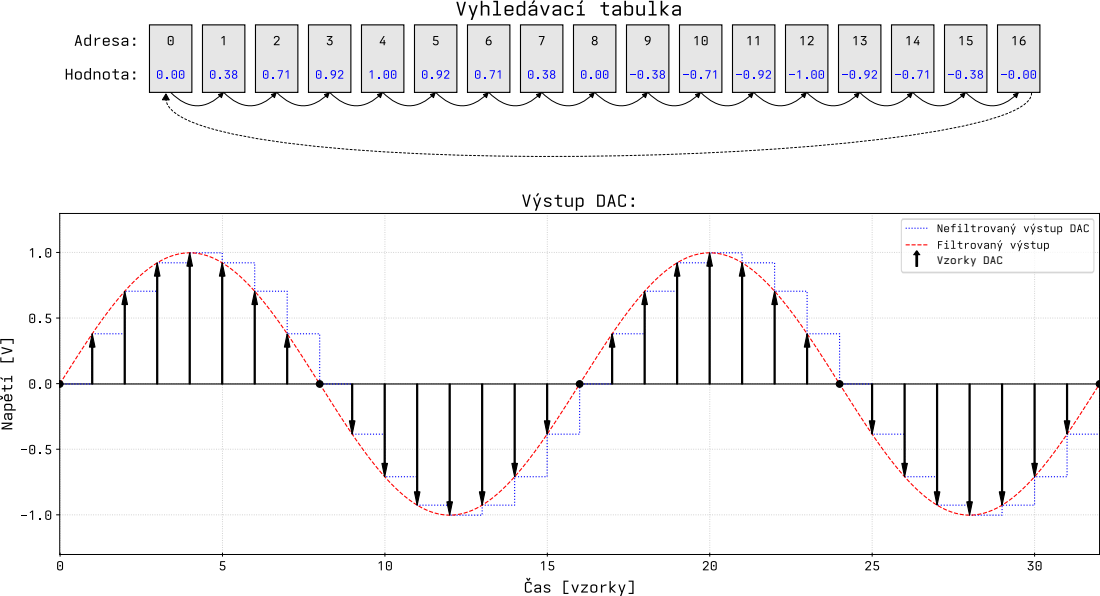
[picture p96: page 1]
Vzorky DAC
