degesz/LATEX_Bakalarka/LATEX_Bakalarka/obrazky/peak_detect_chart.pdf

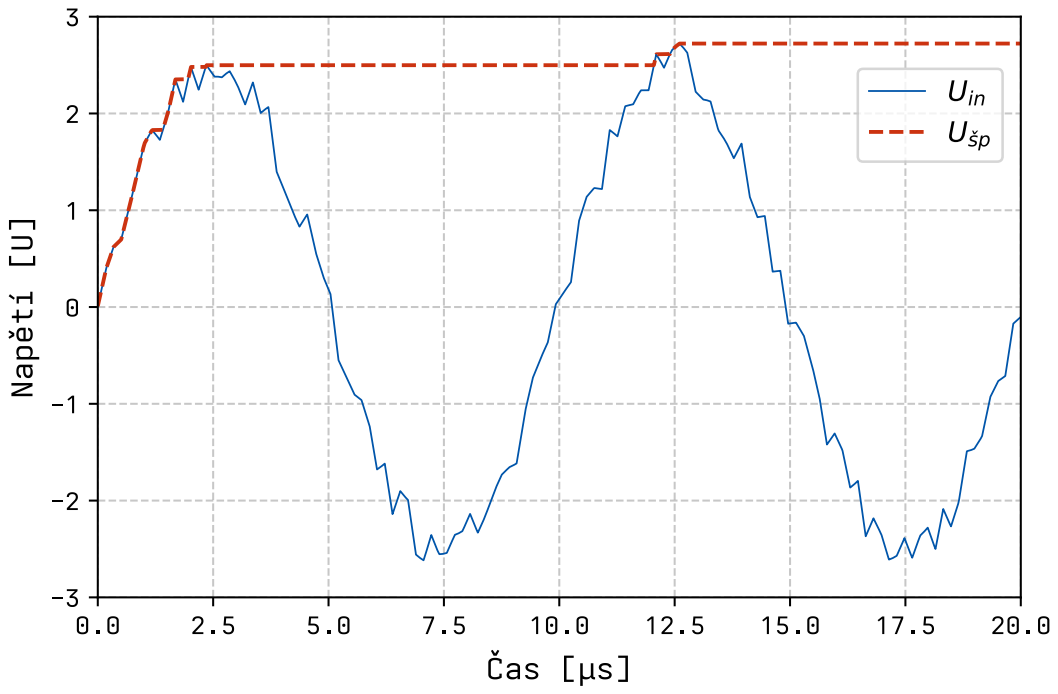
[picture p97: page 1]
