degesz/LATEX_Bakalarka/LATEX_Bakalarka/obrazky/peak_detector_sch.pdf

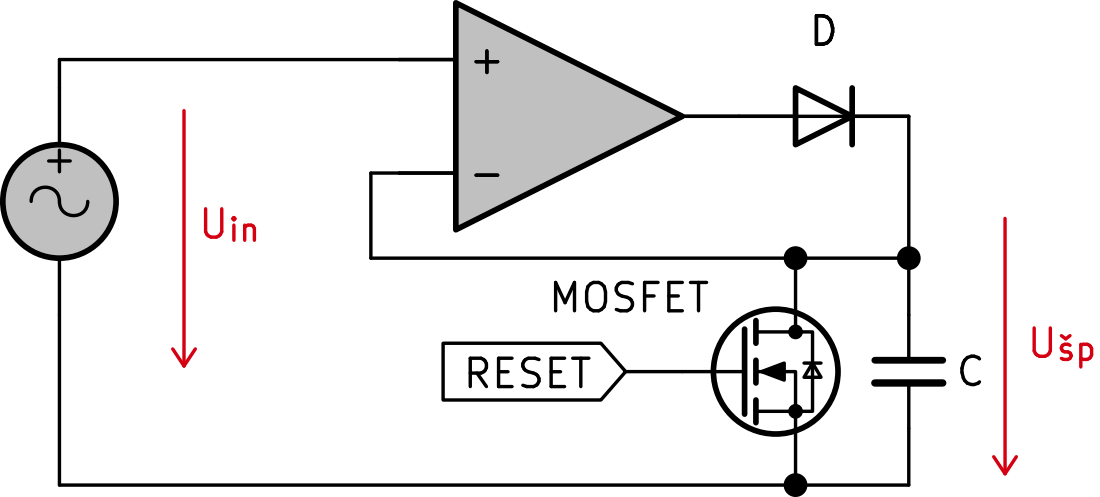
[picture p98: page 1]
