degesz/LATEX_Bakalarka/LATEX_Bakalarka/obrazky/text_37-9.pdf

Vzorky DAC
