degesz/LATEX_Bakalarka/LATEX_Bakalarka/obrazky/XOR_phase_chart.pdf

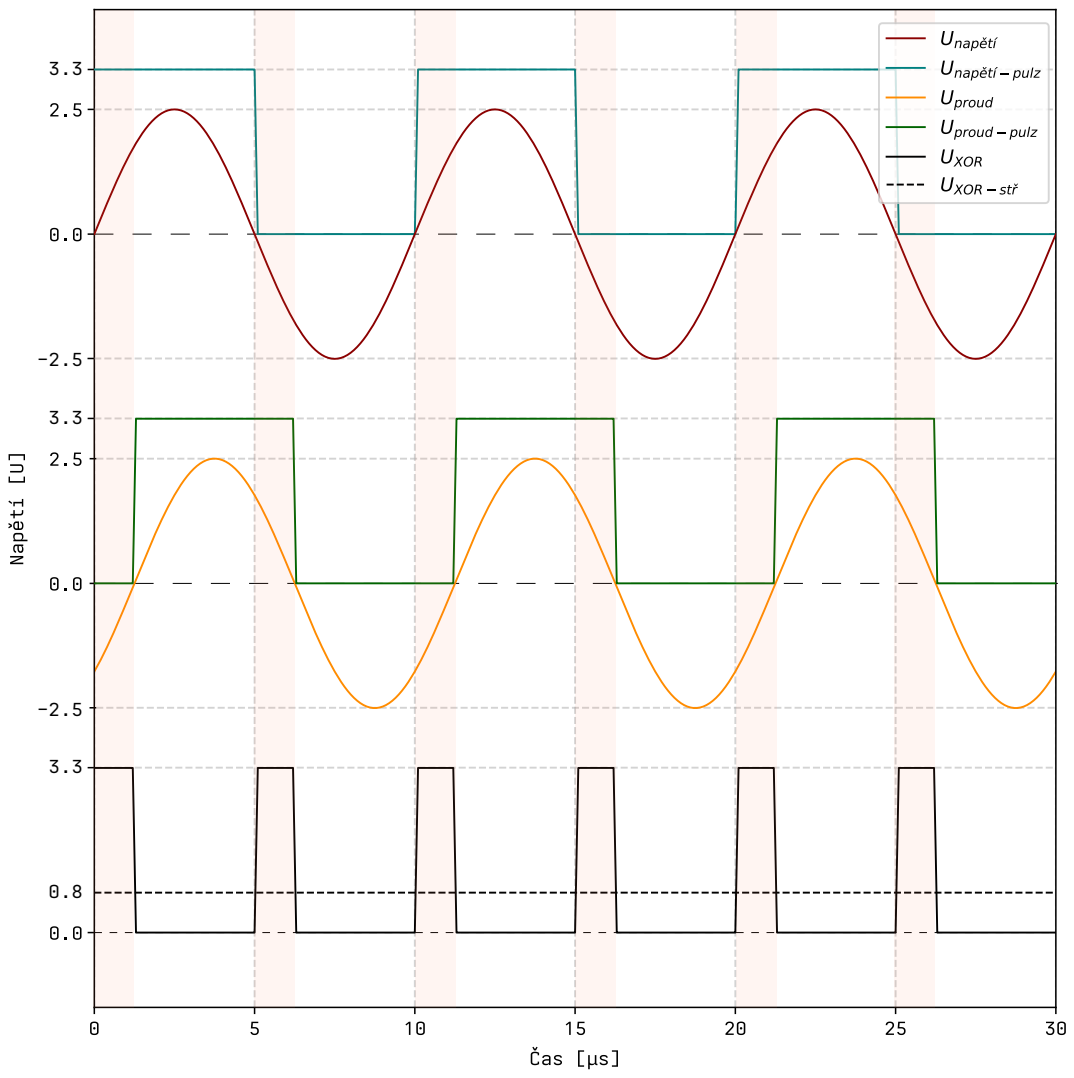
[picture p99: page 1]
