degesz/LATEX_Bakalarka/LATEX_Bakalarka/obrazky/XOR_phase_sch.pdf

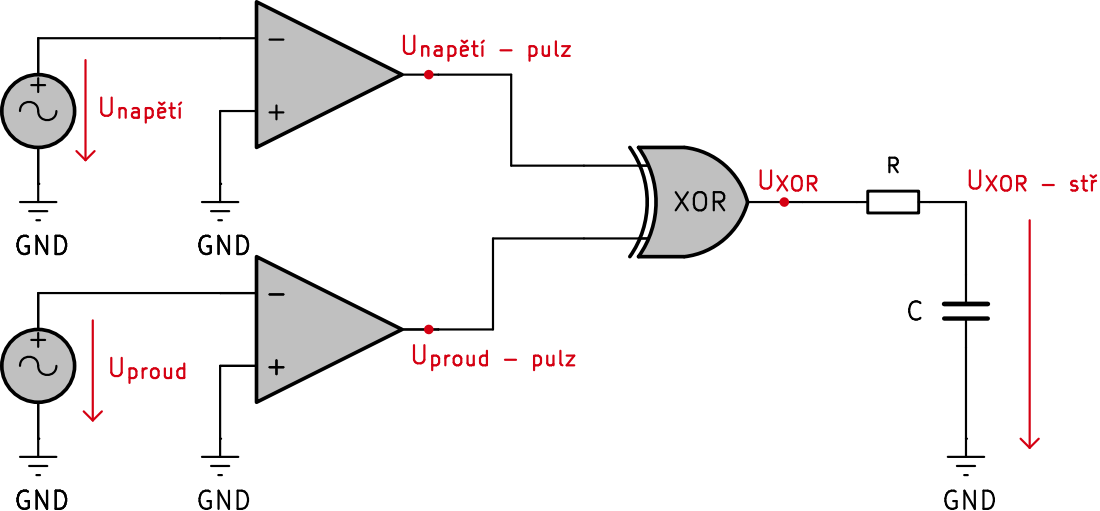
[picture p100: page 1]
