degesz/LATEX_Bakalarka/LATEX_Bakalarka/obrazky/zerocross_noise_chart.pdf

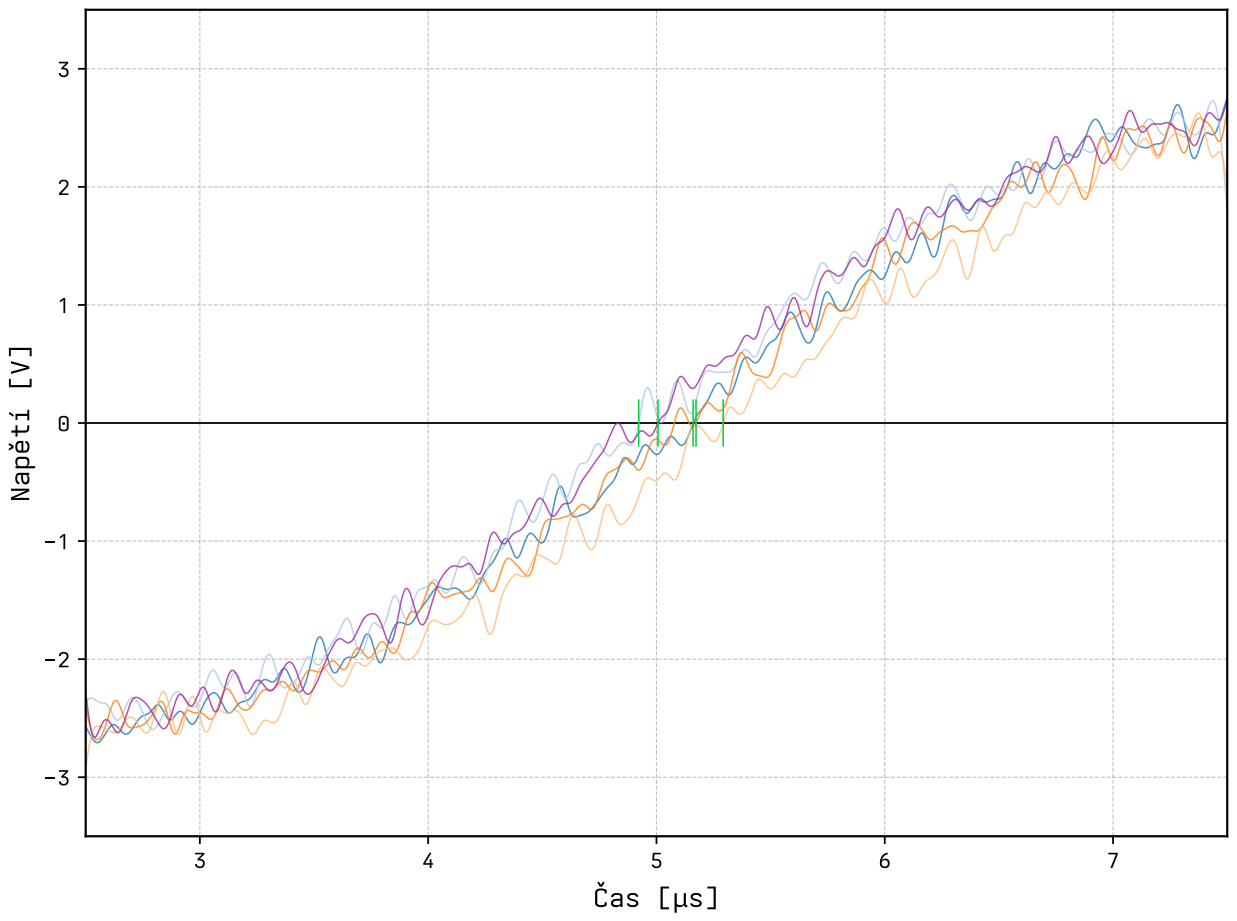
[picture p101: page 1]
