degesz/LATEX_Bakalarka/LATEX_Bakalarka/obrazky/i_v_conv.pdf

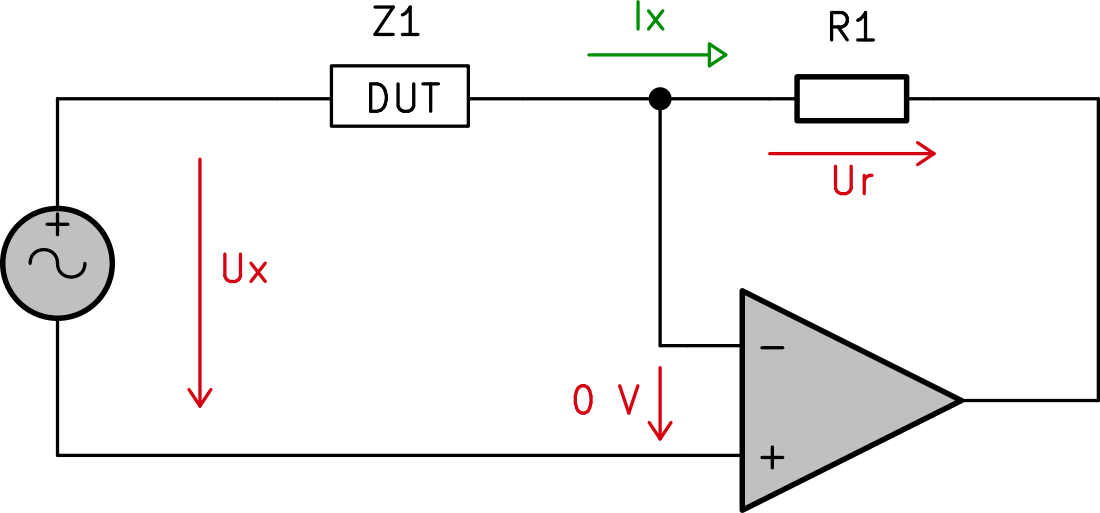
[picture p102: page 1]
