degesz/LATEX_Bakalarka/LATEX_Bakalarka/obrazky/schema+layout/cu_B.pdf

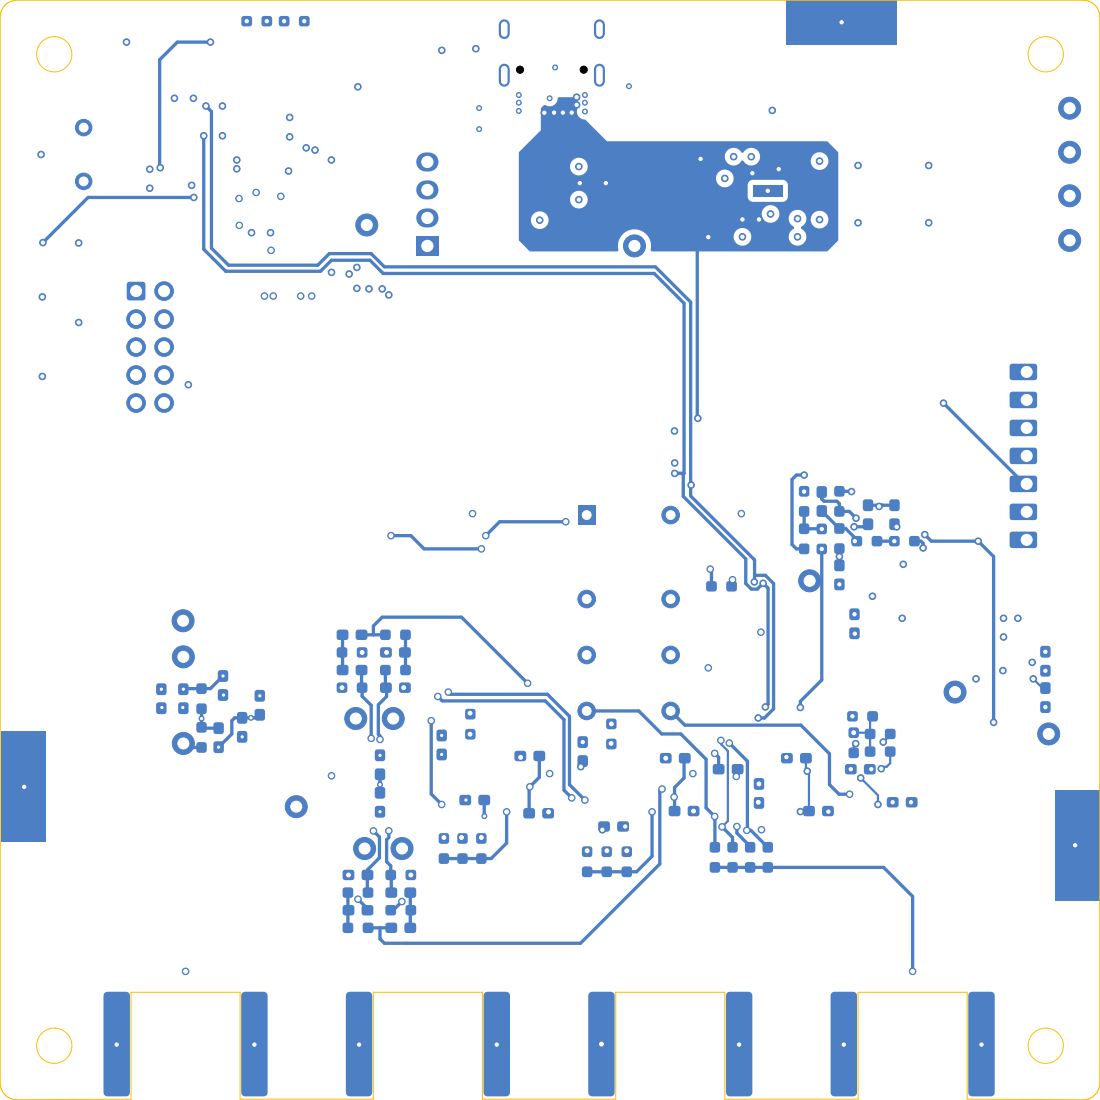
[picture p103: page 1]
