degesz/LATEX_Bakalarka/LATEX_Bakalarka/obrazky/schema+layout/cu_F.pdf

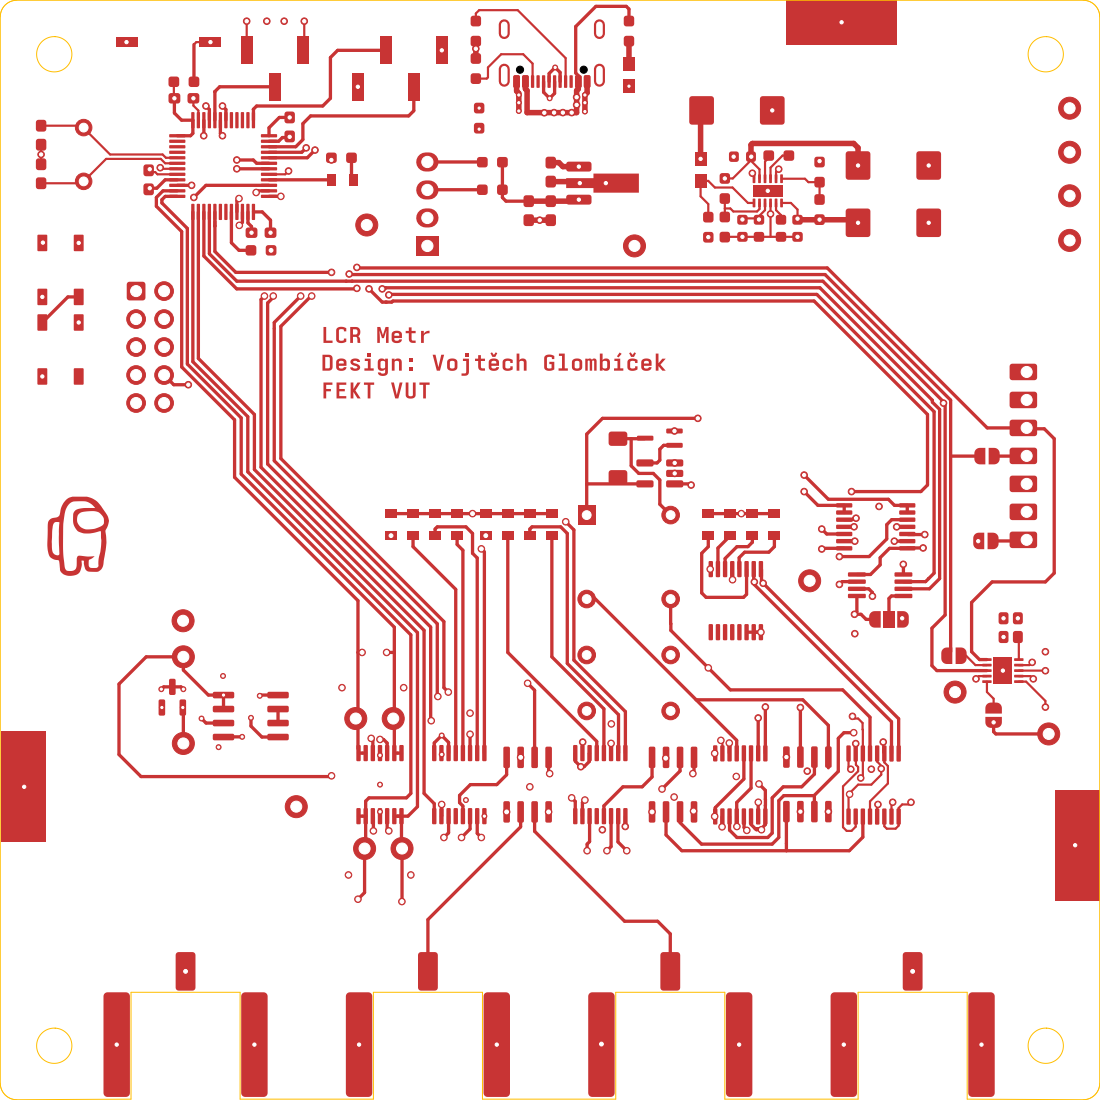
[picture p104: page 1]
