degesz/LATEX_Bakalarka/LATEX_Bakalarka/obrazky/schema+layout/cu_in1.pdf

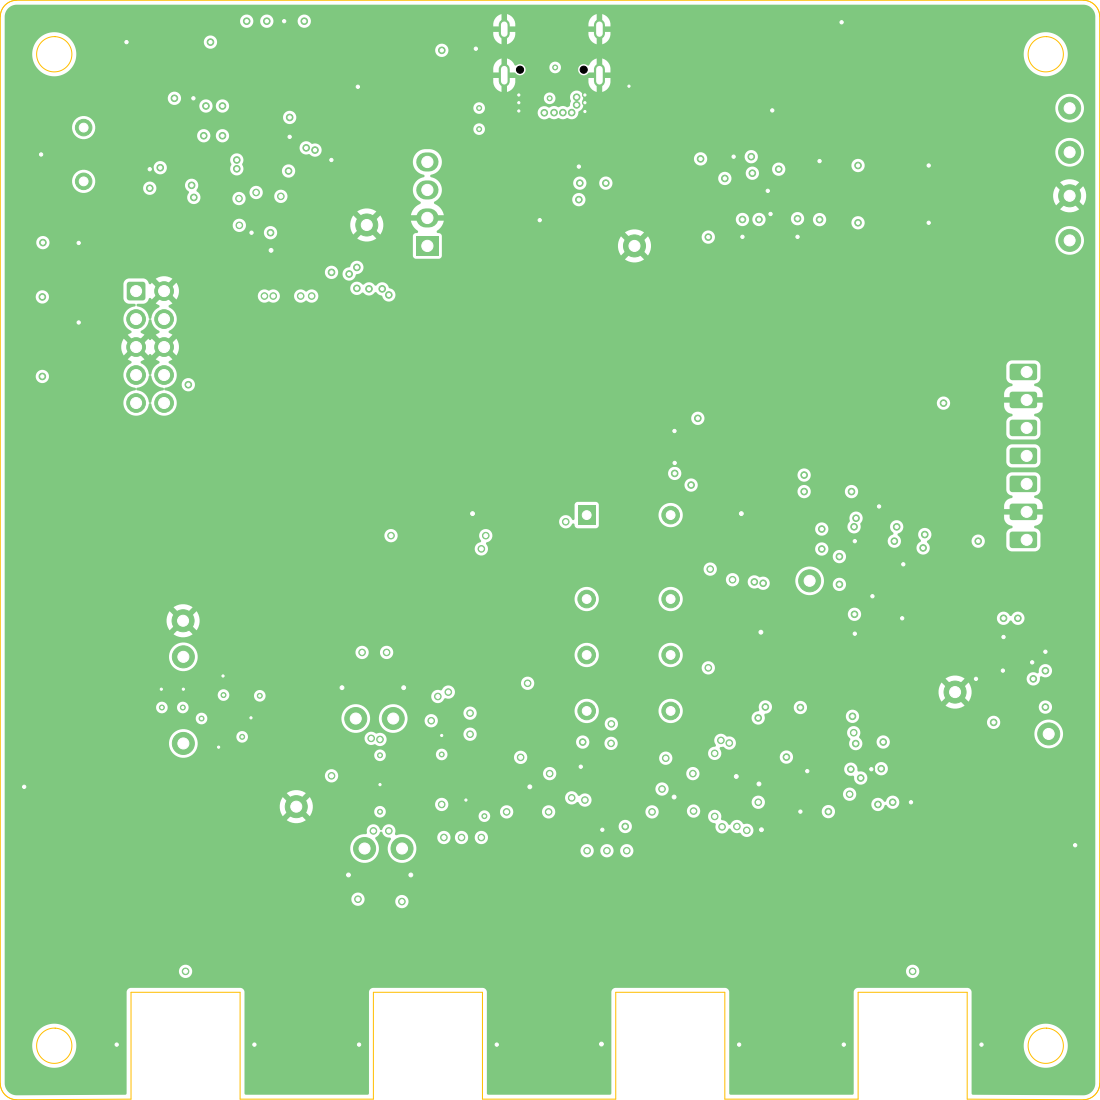
[picture p105: page 1]
