degesz/LATEX_Bakalarka/LATEX_Bakalarka/obrazky/schema+layout/cu_in2.pdf

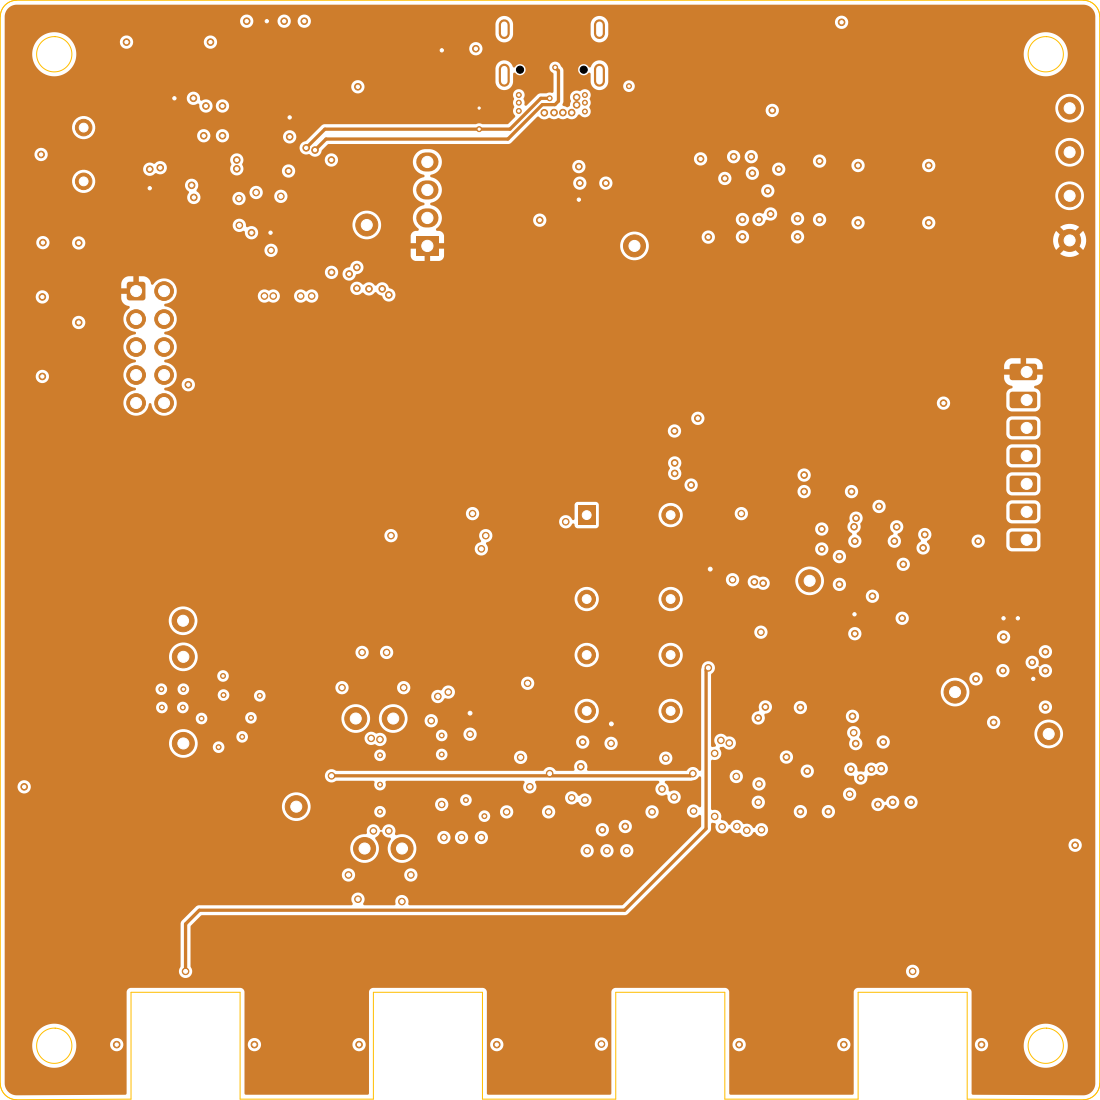
[picture p106: page 1]
