degesz/LATEX_Bakalarka/LATEX_Bakalarka/obrazky/schema+layout/cu_in3.pdf

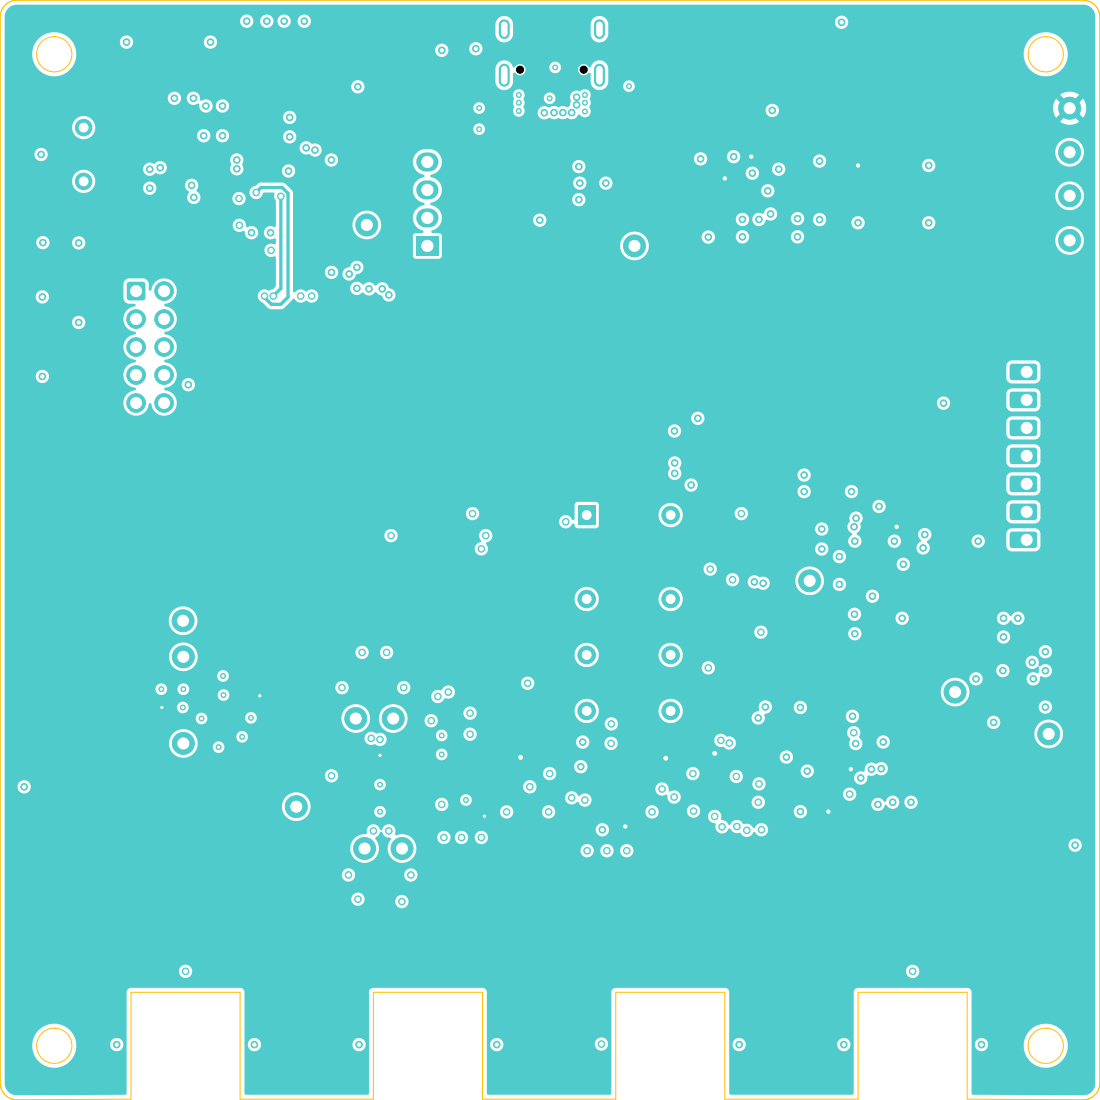
[picture p107: page 1]
