degesz/LATEX_Bakalarka/LATEX_Bakalarka/obrazky/schema+layout/cu_in4.pdf

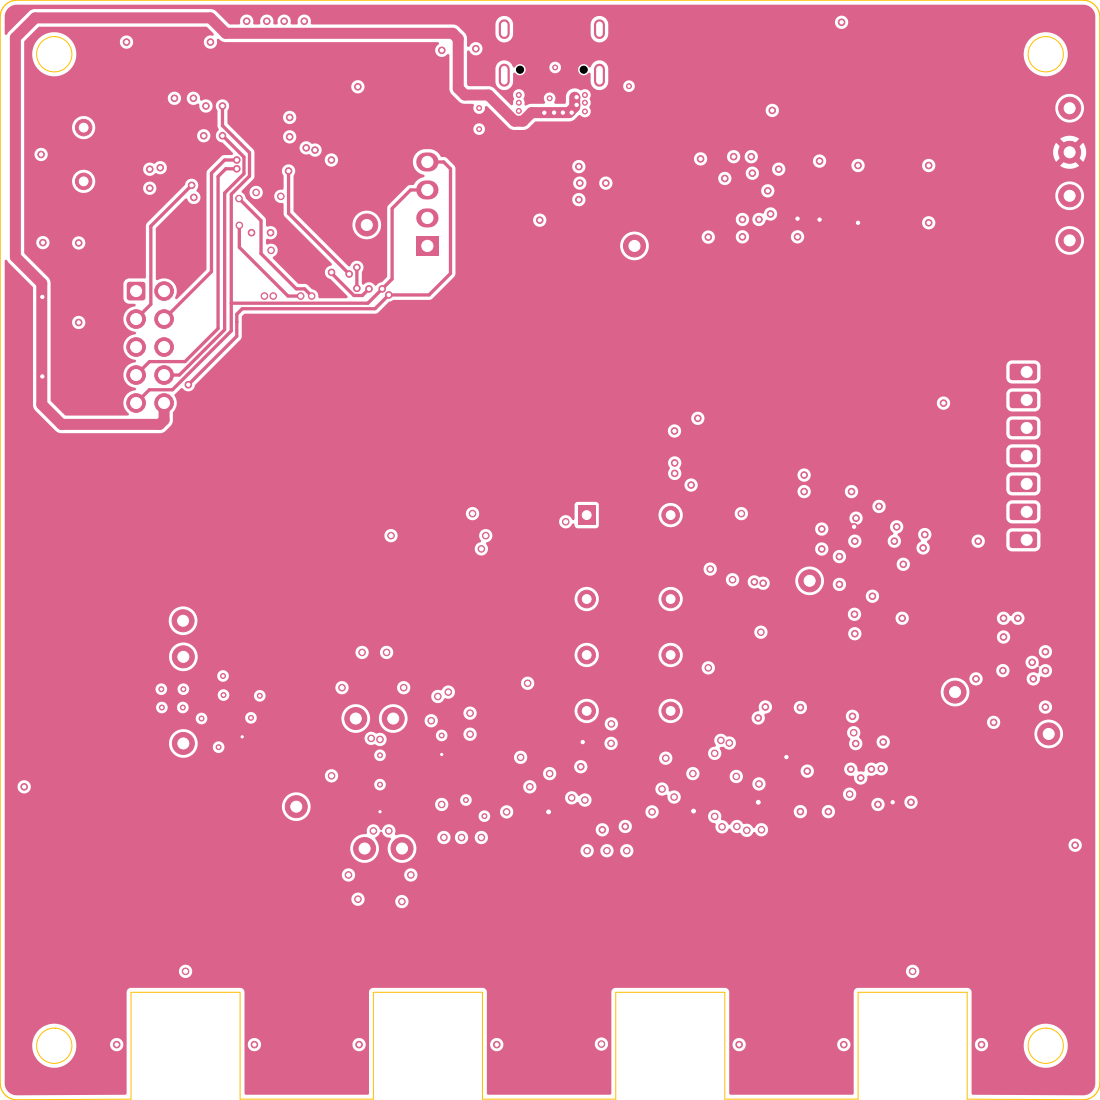
[picture p108: page 1]
