degesz/LATEX_Bakalarka/LATEX_Bakalarka/obrazky/komponent_viz/histogramy/____c_small_100khz_C.pdf

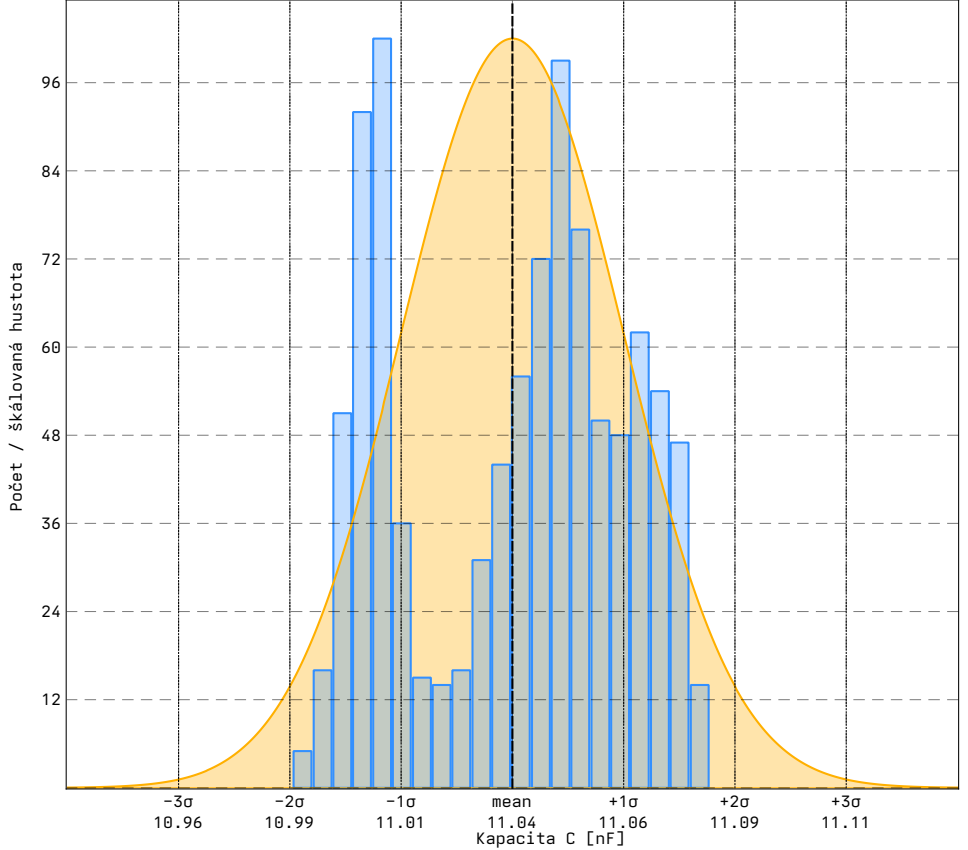
[picture p109: page 1]
mean 11.04; Kapacita C [nF]
