degesz/LATEX_Bakalarka/LATEX_Bakalarka/obrazky/komponent_viz/histogramy/c_big_1khz_C.pdf

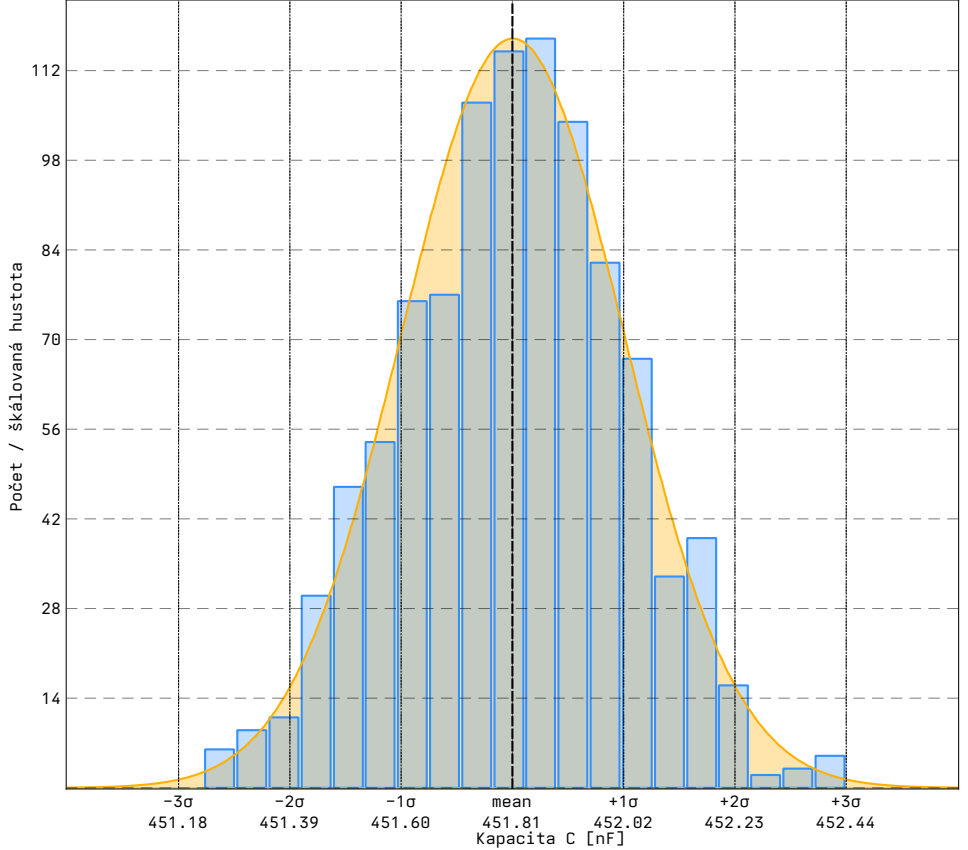
[picture p110: page 1]
mean 451.81; Kapacita C [nF]
