degesz/LATEX_Bakalarka/LATEX_Bakalarka/obrazky/komponent_viz/histogramy/c_big_1khz_R.pdf

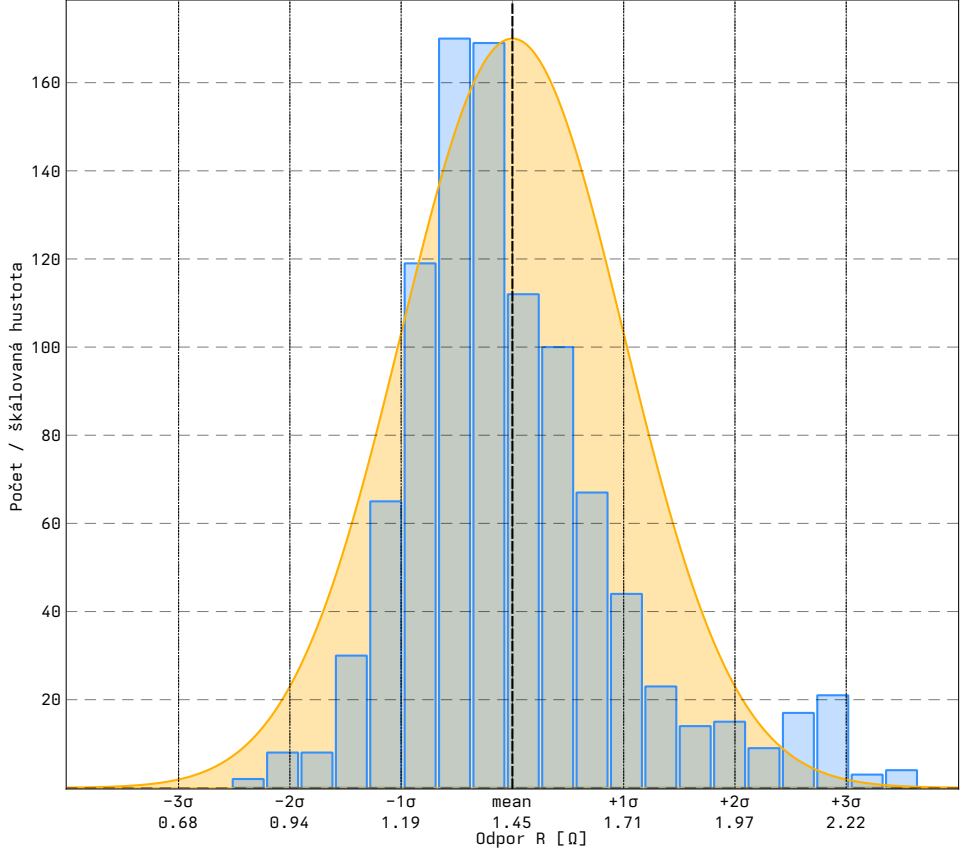
[picture p111: page 1]
mean 1.45; Odpor R [Ω]
