degesz/LATEX_Bakalarka/LATEX_Bakalarka/obrazky/komponent_viz/histogramy/c_small_100khz_R.pdf

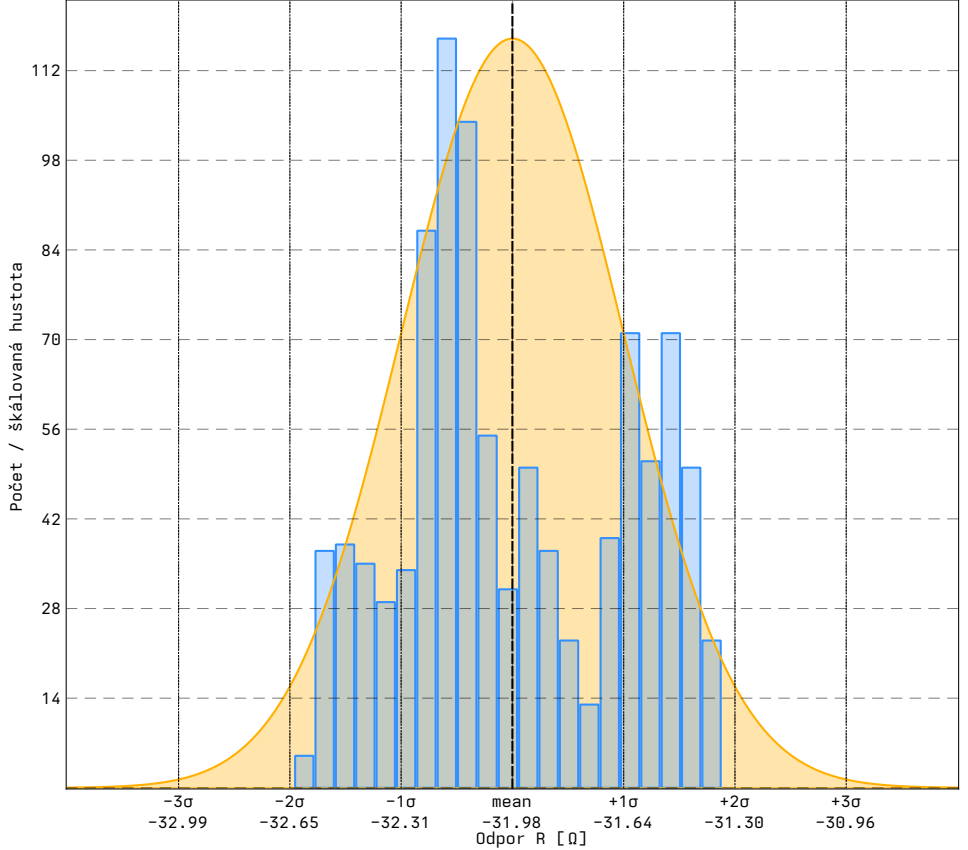
[picture p112: page 1]
mean -31.98; Odpor R [Ω]
