degesz/LATEX_Bakalarka/LATEX_Bakalarka/obrazky/komponent_viz/histogramy/R_10khz.pdf

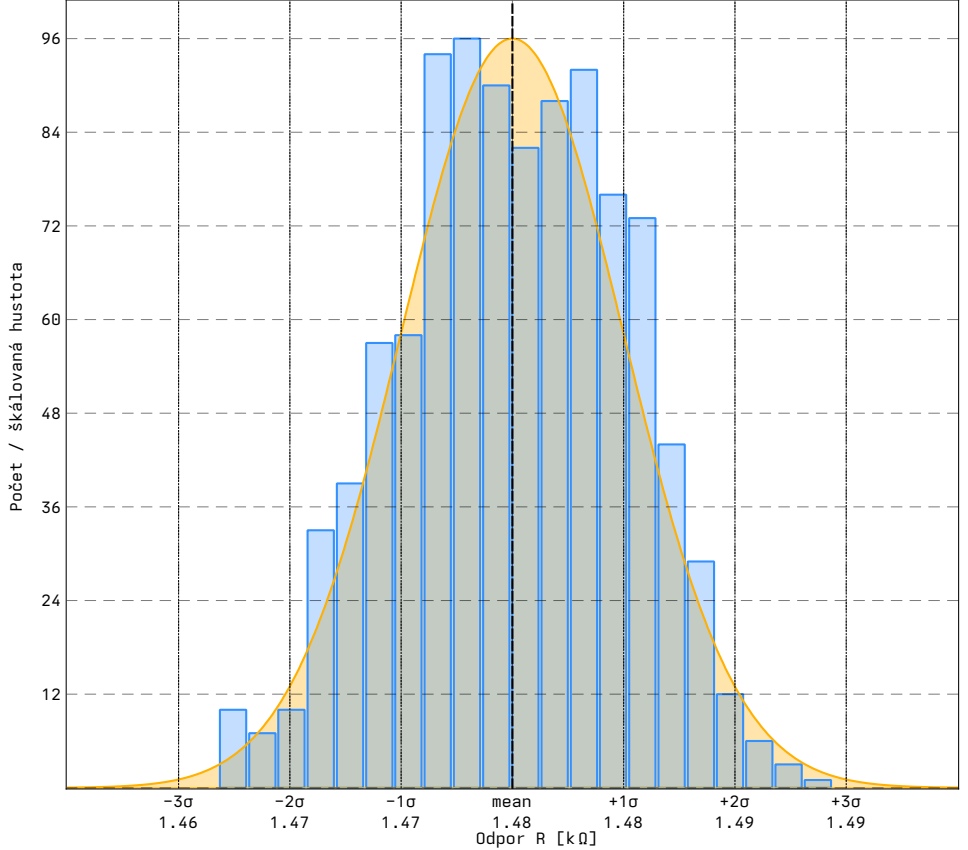
[picture p113: page 1]
mean 1.48; Odpor R [kΩ]
