degesz/LATEX_Bakalarka/LATEX_Bakalarka/obrazky/komponent_viz/histogramy/r_phase_diff_10khz.pdf

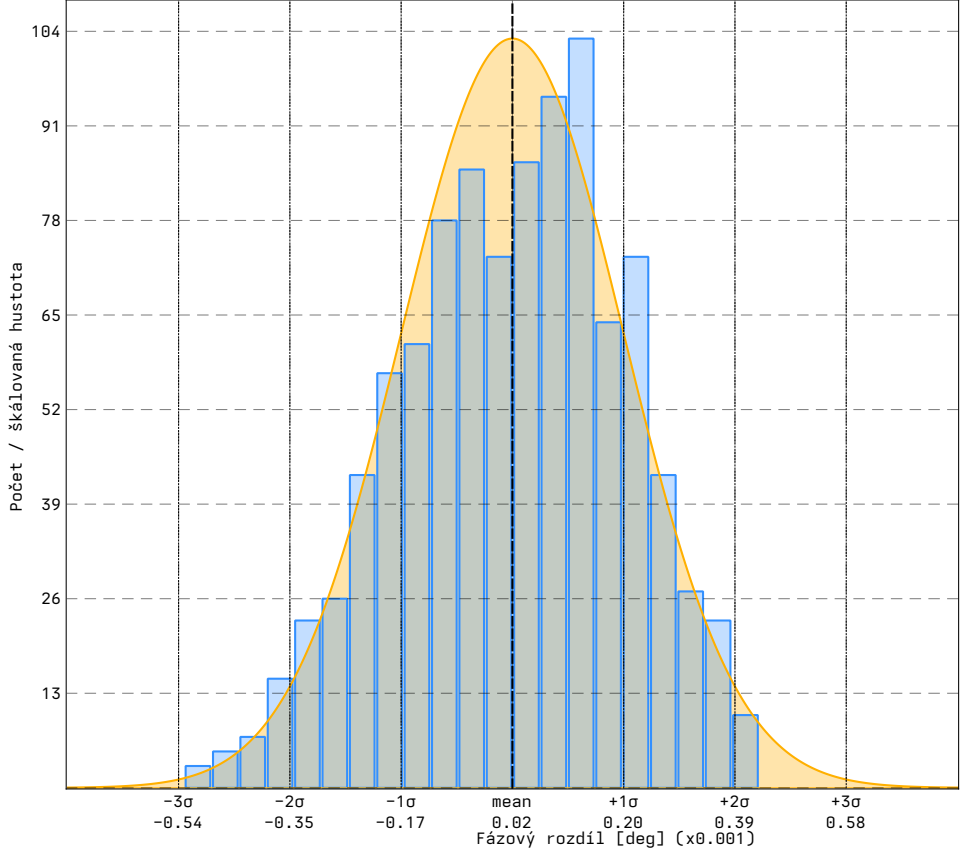
[picture p114: page 1]
mean 0.02; Fázový rozdíl [deg] (x0.001)
