degesz/LATEX_Bakalarka/LATEX_Bakalarka/obrazky/komponent_viz/histogramy/toroid_100khz_L.pdf

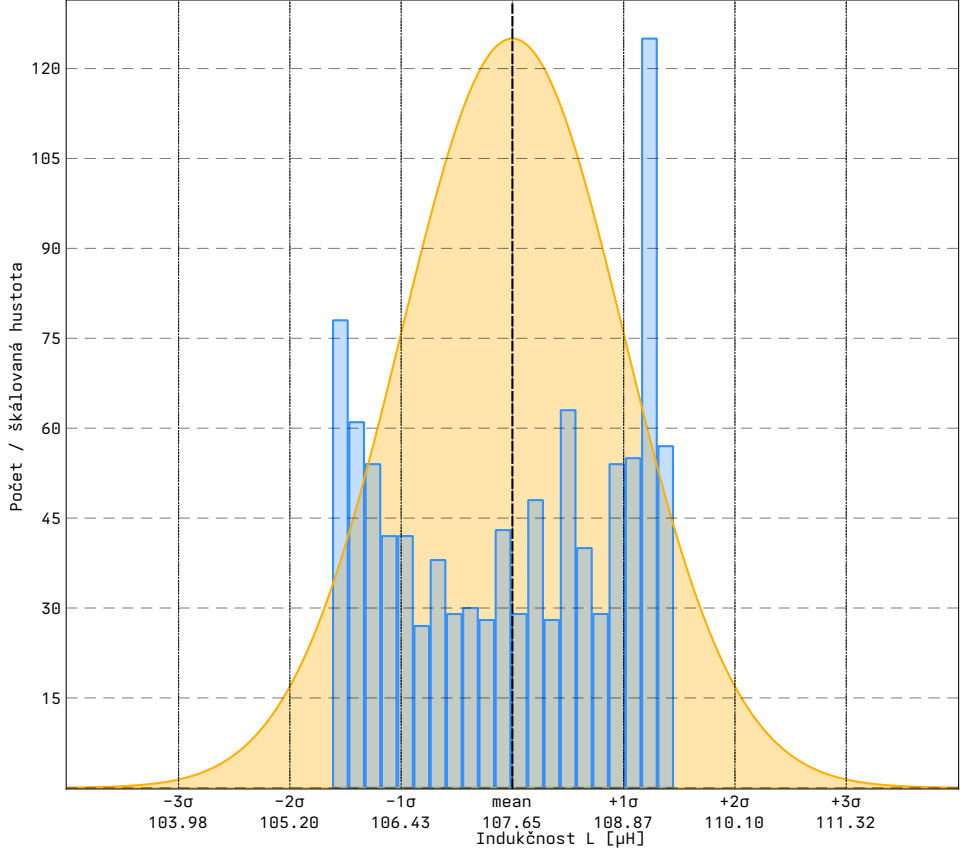
[picture p115: page 1]
mean 107.65; Indukčnost L [µH]
