degesz/LATEX_Bakalarka/LATEX_Bakalarka/obrazky/komponent_viz/histogramy/toroid_100khz_R.pdf

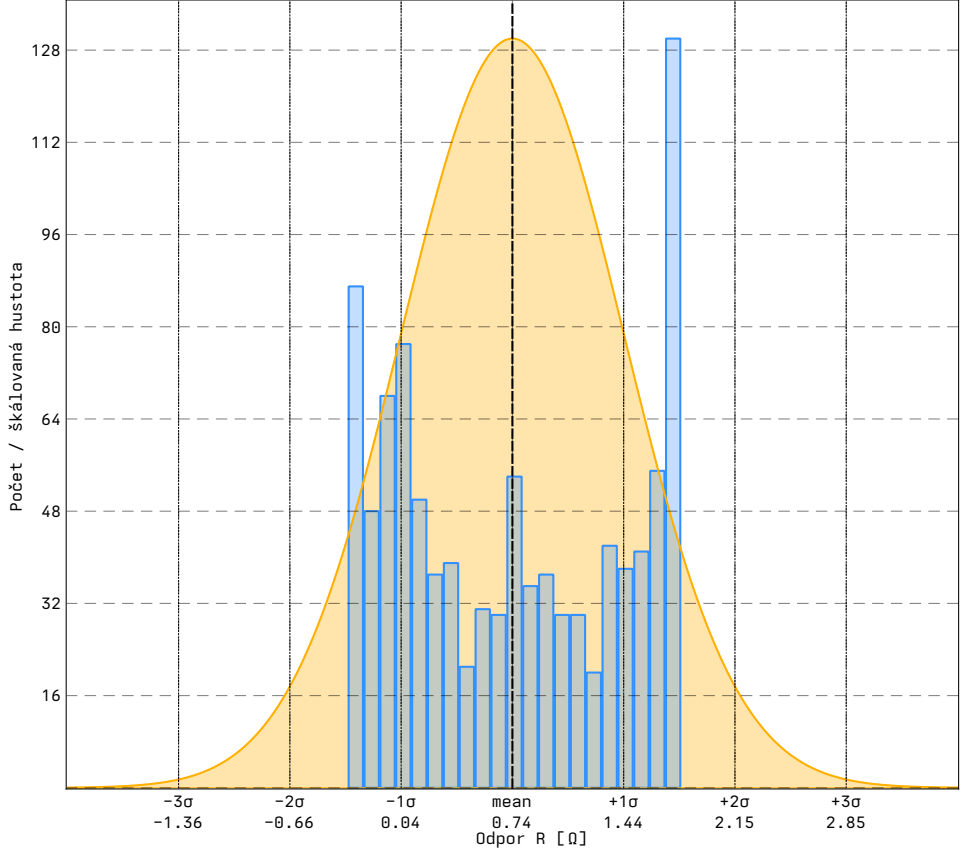
[picture p116: page 1]
mean 0.74; Odpor R [Ω]
