degesz/LATEX_Bakalarka/LATEX_Bakalarka/obrazky/komponent_viz/histogramy/toroid_10khz_L.pdf

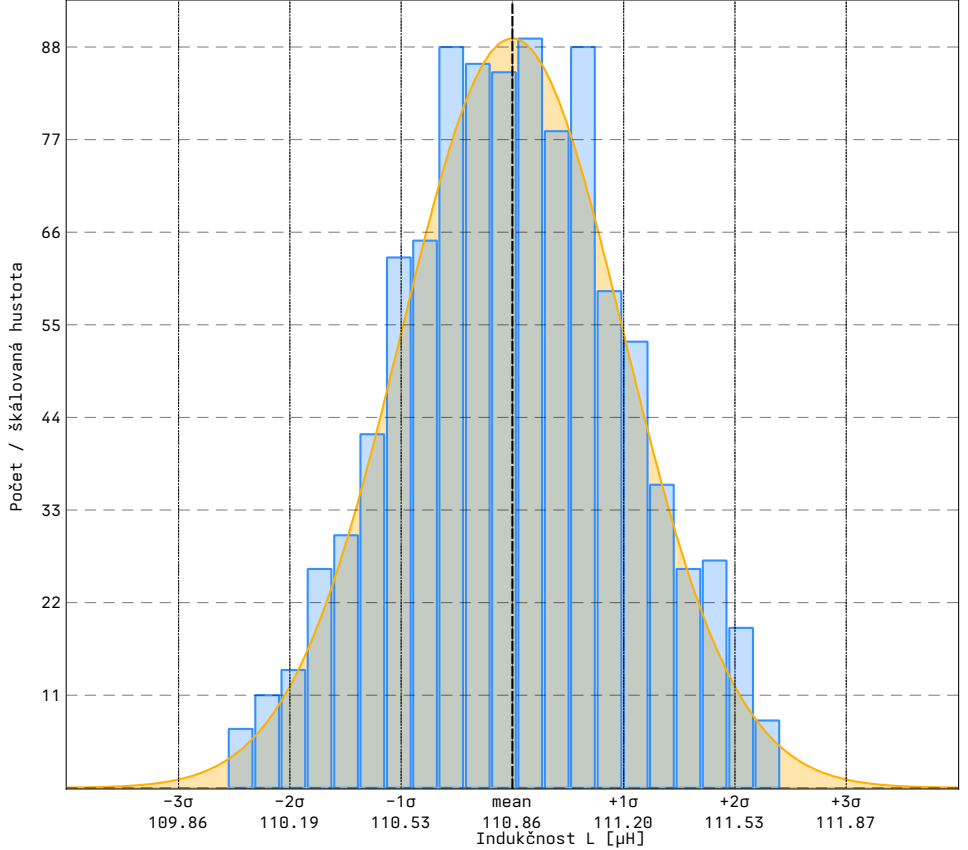
[picture p117: page 1]
mean 110.86; Indukčnost L [µH]
