degesz/LATEX_Bakalarka/priloha/first_prototypeLCR_Meter/LCR_Meter.kicad_pcb

## KiCad design priloha/first_prototypeLCR_Meter/LCR_Meter.kicad_pcb (2026-05-05)

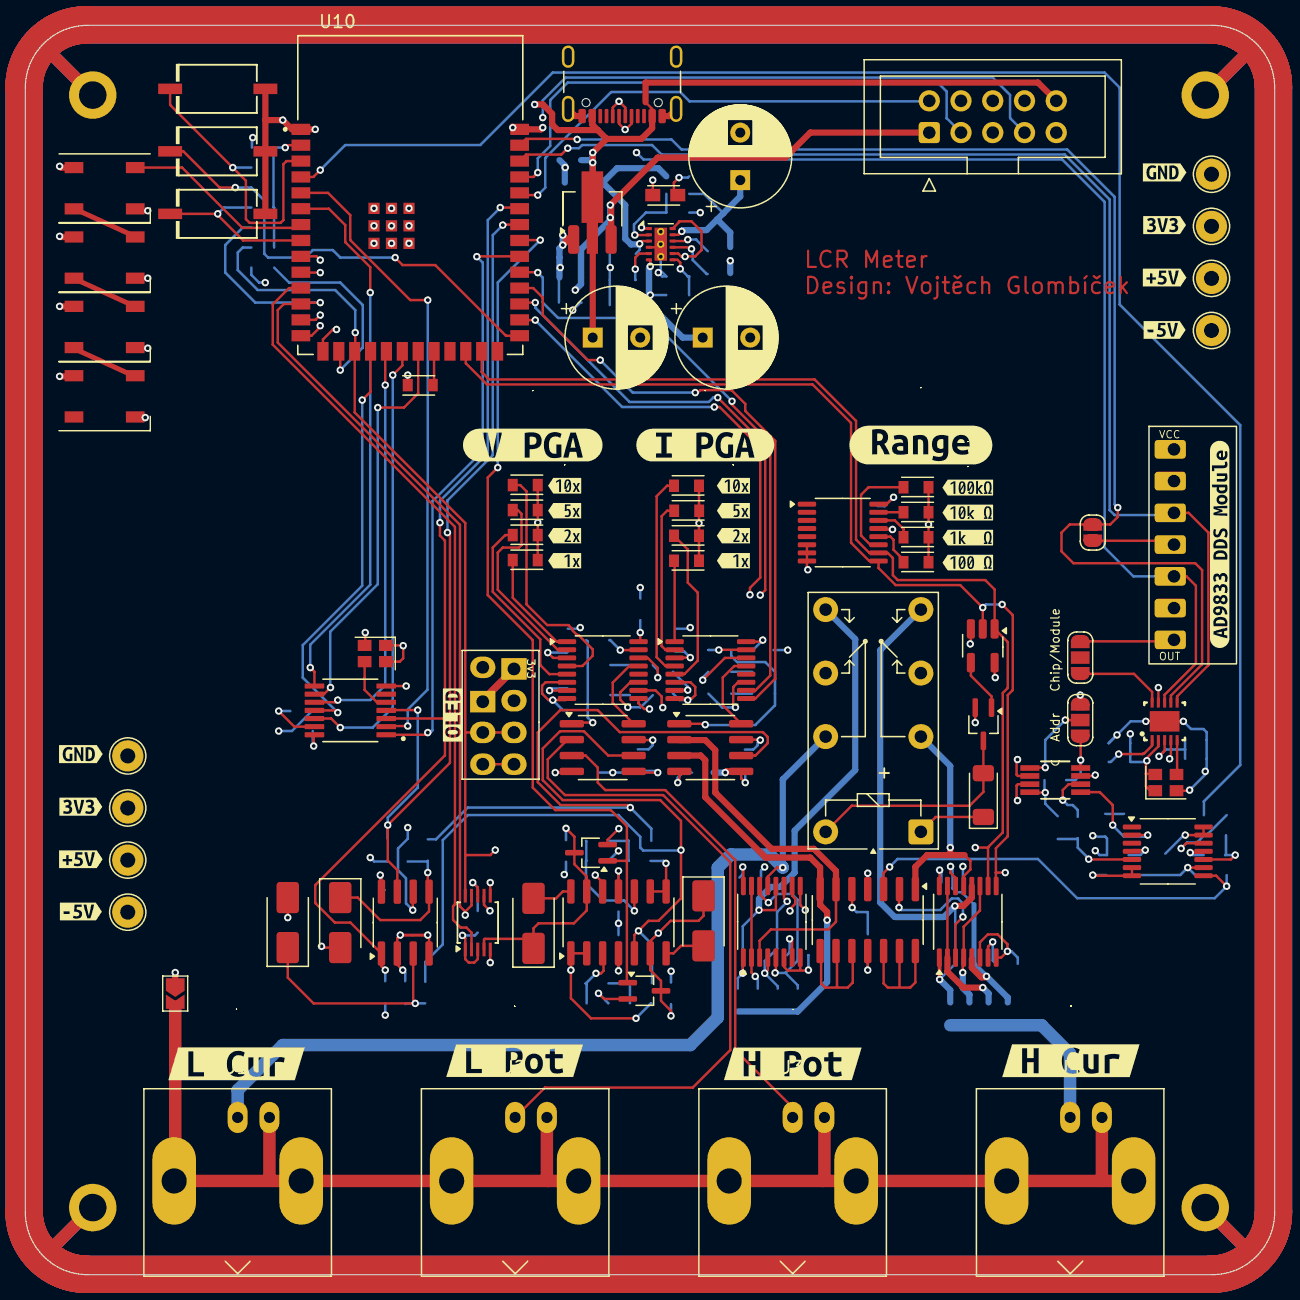
[picture p118: board LCR_Meter.kicad_pcb from above]

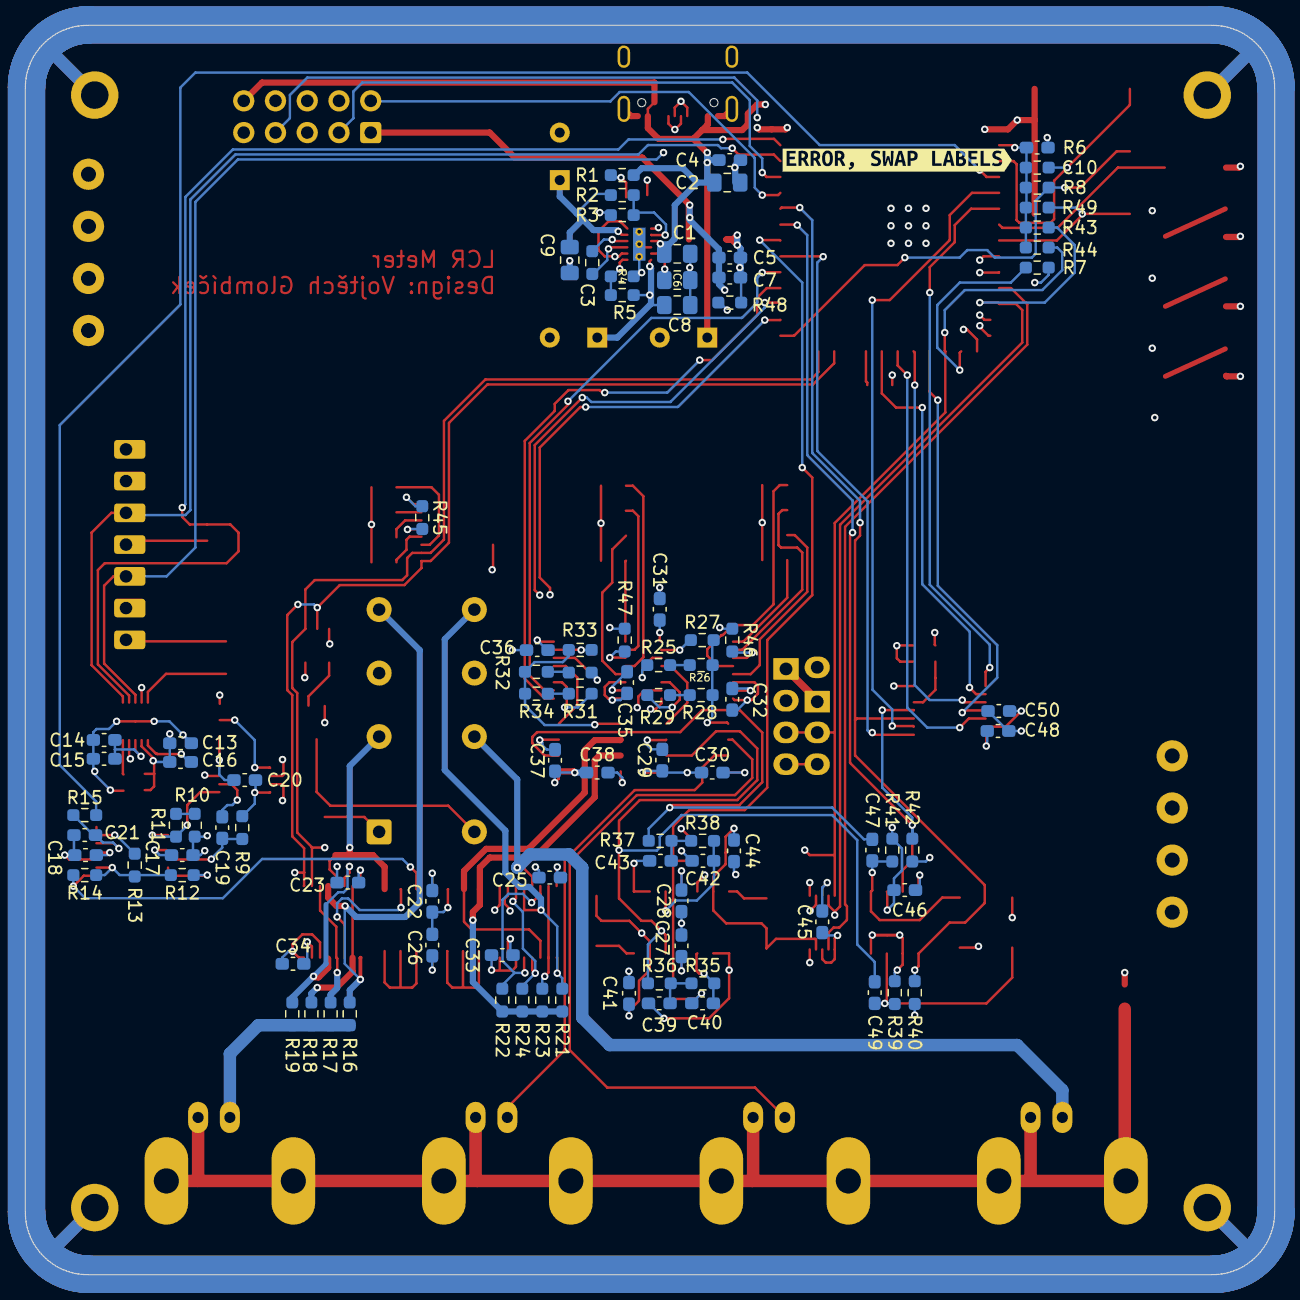
[picture p119: board LCR_Meter.kicad_pcb from below]

Board: 6 copper layers, 99.9 x 99.9 mm, 198 parts (96 on the bottom side), 132 nets.

Parts:
 : TestPoint_THTPad_D2.5mm_Drill1.2mm
 #2,  #16: G***; kibuzzard-678FA578
 #3,  #4,  #5,  #6,  #7,  #10,  #14: TestPoint_THTPad_D2.5mm_Drill1.2mm
 #8,  #15: G***; kibuzzard-678FA580
 #9,  #11: G***; kibuzzard-678FA556
 #12,  #13: G***; kibuzzard-678FA586
C1, C2, C6, C8, C9: 4.7u; C_0805_2012Metric_Pad1.18x1.45mm_HandSolder
C3: 1u; R_0603_1608Metric_Pad0.98x0.95mm_HandSolder
C4, C5, C14, C19, C47, C49: 100n; C_0603_1608Metric_Pad1.08x0.95mm_HandSolder
C7, C10, C13, C15, C17, C18, C20, C21, C22, C23, C25, C26, C27, C28, C29, C30, C31, C32, C33, C34, C35, C36, C37, C38, C41, C44, C45, C46, C48, C50: 1u; C_0603_1608Metric_Pad1.08x0.95mm_HandSolder
C11, C12, C51: 470u; CP_Radial_D8.0mm_P3.80mm
C16: 10n; C_0603_1608Metric_Pad1.08x0.95mm_HandSolder
C39, C40, C42, C43: 330n; C_0603_1608Metric_Pad1.08x0.95mm_HandSolder
D1: LED; LED_miniPLCC_2315_Handsoldering
D2: D_Schottky; D_MiniMELF
D3, D4, D5, D6: SS14; D_SMA
D7, D8, D9, D10, D11, D12, D13, D14, D15, D16, D17, D18, D20: LED; LED_miniPLCC_2315
D19, D21, D22, D23: WS2812B; LED_WS2812B_PLCC4_5.0x5.0mm_P3.2mm
J1, J2, J3, J4: Conn_Coaxial; BNC_Amphenol_B6252HB-NPP3G-50_Horizontal
J5: USB_C_Receptacle_USB2.0_16P; USB_C_Receptacle_GCT_USB4105-xx-A_16P_TopMnt_Horizontal
J6: IDC 2x5; IDC-Header_2x05_P2.54mm_Vertical
J7: Display OLED; FanPinHeader_1x04_P2.54mm_Vertical
JP1, JP2: SolderJumper_3_Open; SolderJumper-3_P1.3mm_Open_RoundedPad1.0x1.5mm
JP3: SolderJumper_2_Open; SolderJumper-2_P1.3mm_Open_RoundedPad1.0x1.5mm
JP4: SolderJumper_2_Open; SolderJumper-2_P1.3mm_Open_TrianglePad1.0x1.5mm
K1: Relay_DPDT; Relay_CIT-J104D
Q1, Q2, Q3: NX3008NBK; SOT-323_SC-70_Handsoldering
R1, R6, R7, R8, R19, R22, R40, R42, R45, R46, R47, R48, R49: 1k; R_0603_1608Metric_Pad0.98x0.95mm_HandSolder
R2, R5, R43, R44: 4k7; R_0603_1608Metric_Pad0.98x0.95mm_HandSolder
R3, R4: 1k5; R_0603_1608Metric_Pad0.98x0.95mm_HandSolder
R9, R15, R17, R24, R27, R33, R39, R41: 100k; R_0603_1608Metric_Pad0.98x0.95mm_HandSolder
R10, R12, R13, R14, R18, R23, R35, R36, R37, R38: 10k; R_0603_1608Metric_Pad0.98x0.95mm_HandSolder
R11: 33k; R_0603_1608Metric_Pad0.98x0.95mm_HandSolder
R16, R21: 100R; R_0603_1608Metric_Pad0.98x0.95mm_HandSolder
R25, R29, R30, R31: 0R; R_0603_1608Metric_Pad0.98x0.95mm_HandSolder
R26, R32: 200k; R_0603_1608Metric_Pad0.98x0.95mm_HandSolder
R28, R34: 22k; R_0603_1608Metric_Pad0.98x0.95mm_HandSolder
SW1, SW2, SW3: SW_SPST; SW-SMD_L6.1-W3.7-LS7.9
U1: AD9837; AD9837_AD9837
U2, U5: TLV9154; SOIC-14_3.9x8.7mm_P1.27mm
U3: ADS1115IDGS; TSSOP-10_3x3mm_P0.5mm
U4: LM393; SOIC-8_3.9x4.9mm_P1.27mm
U7: TDC7200PWR; TDC7200PWR_SOP65P640X120-14N
U8: LM27762; WSON-12-1EP_3x2mm_P0.5mm_EP1x2.65_ThermalVias
U9: HT75xx-1-SOT89; SOT-89-3_Handsoldering
U10: ESP32-S2-SOLO-N4; ESP32-S2-SOLO-N4_XCVR_ESP32-S2-SOLO-N4
U12: TL074; TSSOP-14_4.4x5mm_P0.65mm
U13: MCP4561-502E_MS; MCP4561-502E_MS_SOP65P490X110-8N
U14, U16, U18, U20, U23: CD74HC4052; TSSOP-16_4.4x5mm_P0.65mm
U17, U21: INA823; SOIC-8_3.9x4.9mm_P1.27mm
U19: 74LVC1G02; SOT-23-5_HandSoldering
U22: AD9833_Module
X1, X2: SG-210STF; Oscillator_SMD_SeikoEpson_SG210-4Pin_2.5x2.0mm
kibuzzard-67C21963: G***; kibuzzard-67C21963
kibuzzard-678FC3F7: G***; kibuzzard-678FC3F7
kibuzzard-678FC3FC: G***; kibuzzard-678FC3FC
kibuzzard-678FC38E: G***; kibuzzard-678FC38E
kibuzzard-678FC401: G***; kibuzzard-678FC401
kibuzzard-6790BC5C, kibuzzard-6790BC5C#2: G***; kibuzzard-6790BC5C
kibuzzard-6790BC8C, kibuzzard-6790BC8C#2: G***; kibuzzard-6790BC8C
kibuzzard-6790BC71, kibuzzard-6790BC71#2: G***; kibuzzard-6790BC71
kibuzzard-6790BC83, kibuzzard-6790BC83#2: G***; kibuzzard-6790BC83
kibuzzard-6790BCCF: G***; kibuzzard-6790BCCF
kibuzzard-6790BCE4: G***; kibuzzard-6790BCE4
kibuzzard-6790BCFE: G***; kibuzzard-6790BCFE
kibuzzard-6790BDCA: G***; kibuzzard-6790BDCA
kibuzzard-6790BDD8: G***; kibuzzard-6790BDD8
kibuzzard-6790BDEA: G***; kibuzzard-6790BDEA
kibuzzard-6790BDF0: G***; kibuzzard-6790BDF0
kibuzzard-67960D2E: G***; kibuzzard-67960D2E

Connections:
+3V3: .1, #6.1, C5.1, C7.1, C10.2, C13.2, C16.2, C20.2, C45.2, C48.2, J6.1, J7.1, JP1.3 (B), R6.1, R8.1, R40.1, R42.1, R43.1, R44.1, R45.1, R46.1, R47.1, R49.1, U1.P$2 (VDD), U3.8 (VDD), U7.14 (VDD), U9.3 (VOUT), U10.2 (3V3), U13.8 (VDD), U22.1 (VCC), U23.16 (VDD), X1.1 (~ST), X1.4 (Vcc), X2.1 (~ST), X2.4 (Vcc)
+5V: #3.1, #4.1, C9.1, C17.2, C22.2, C23.2, C25.2, C27.2, C29.2, C31.2, C36.2, C37.2, C46.2, C51.1, D2.1 (K), K1.A1, R2.2, U2.4 (V+), U4.8 (V+), U5.4 (V+), U8.11 (OUT+), U12.4 (V+), U14.16 (VDD), U16.16 (VDD), U17.7 (V+), U18.16 (VDD), U19.5 (VCC), U20.16 (VDD), U21.7 (V+)
+5V_USB: C1.1, C2.1, C4.1, C11.1, D19.1 (VDD), D21.1 (VDD), D22.1 (VDD), D23.1 (VDD), J5.A4 (VBUS), J5.A9 (VBUS), J5.B4 (VBUS), J5.B9 (VBUS), J6.10, R1.2, U8.3 (VIN), U8.8 (EN-), U8.12 (EN+), U9.2 (VIN)
-5V: #5.1, #10.1, C8.1, C12.1, C18.2, C26.2, C28.2, C30.2, C32.2, C33.2, C34.2, C35.2, C38.2, R5.2, U2.11 (V-), U5.11 (V-), U8.6 (OUT-), U12.11 (V-), U14.7 (VEE), U16.7 (VEE), U17.4 (V-), U18.7 (VEE), U20.7 (VEE), U21.4 (V-)
/Analog frontend/Sig_IN: R14.2, U2.3 (+), U12.8
/Drive signal source/F_Sync: U1.P$8 (FSYNC), U10.15 (IO3), U22.5 (FSYNC)
/Drive signal source/Offset_PWM: R15.1, U10.4 (IO4)
/Drive signal source/S_Clock: JP3.2 (B), U1.P$7 (SCLK), U10.39 (IO1)
/Drive signal source/S_Data: U1.P$6 (SDATA), U10.38 (IO2), U22.3 (SDATA)
/LEDs/LED_1: D20.2 (A), U10.22 (IO14)
/LEDs/RGB_Data: D19.4 (DIN), U10.7 (IO7)
/Power supply + USB/USB_D+: J5.A6 (D+), J5.B6 (D+), U10.14 (IO20)
/Power supply + USB/USB_D-: J5.A7 (D-), J5.B7 (D-), U10.13 (IO19)
ADC_Alert: U3.2 (ALERT/RDY), U10.11 (IO18)
BNC_Shield: J1.2 (Ext), J2.2 (Ext), J3.2 (Ext), J4.2 (Ext), JP4.2 (B)
GND: #7.1, #14.1, C1.2, C2.2, C4.2, C5.2, C6.2, C7.2, C8.2, C9.2, C10.1, C11.2, C12.2, C13.1, C14.1, C15.1, C17.1, C18.1, C20.1, C21.1, C22.1, C23.1, C25.1, C26.1, C27.1, C28.1, C29.1, C30.1, C31.1, C32.1, C33.1, C34.1, C35.1, C36.1, C37.1, C38.1, C40.2, C41.1, C42.2, C44.1, C45.1, C46.1, C48.1, C50.2, C51.2, D1.1 (K), D5.2 (A), D6.2 (A), D7.1 (K), D8.1 (K), D9.1 (K), D10.1 (K), D11.1 (K), D12.1 (K), D13.1 (K), D14.1 (K), D15.1 (K), D16.1 (K), D17.1 (K), D18.1 (K), D19.3 (VSS), D21.3 (VSS), D22.3 (VSS), D23.3 (VSS), J5.A1 (GND), J5.A12 (GND), J5.B1 (GND), J5.B12 (GND), J5.S1 (SHIELD), J6.5, J6.6, J7.2, JP1.1 (A), JP4.1 (A), Q1.2 (S), Q2.2 (S), Q3.2 (S), R3.2, R4.2, R7.1, R9.2, R10.2, R39.2, R41.2, R48.1, SW1.1 (A), SW2.1 (A), SW3.1 (A), U1.P$0 (DGND), U1.P$4 (DGND), U1.P$9 (AGND), U2.5 (+), U3.1 (ADDR), U3.3 (GND), U4.2 (-), U4.4 (V-), U4.6 (-), U7.7 (GND), U8.1 (PGOOD), U8.4 (GND), U8.13 (PAD), U9.1 (GND), U10.1 (GND), U10.40 (GND), U12.10 (+), U13.4 (VSS), U13.7 (P0B), U14.6 (INH), U14.8 (VSS), U16.6 (INH), U16.8 (VSS), U17.5 (Ref), U18.6 (INH), U18.8 (VSS), U19.3 (GND), U20.6 (INH), U20.8 (VSS), U21.5 (Ref), U22.2 (DGND), U22.6 (AGND), U23.6 (INH), U23.7 (VEE), U23.8 (VSS), X1.2 (GND), X2.2 (GND)
I2C_SCL: J6.9, J7.3, R44.2, U3.10 (SCL), U10.17 (IO9), U13.2 (SCL)
I2C_SDA: J6.8, J7.4, R43.2, U3.9 (SDA), U10.12 (IO8), U13.3 (SDA)
I_Mean: C43.1, U3.5 (AIN1), U5.8, U5.9 (-)
I_PGA_A: U10.31 (IO38), U20.10 (A)
I_PGA_B: U10.30 (IO37), U20.9 (B)
I_Peak: C44.2, D4.1 (K), Q3.3 (D), U3.4 (AIN0), U5.13 (-)
I_Range_A: U10.25 (IO34), U14.10 (A), U16.10 (A), U19.1, U23.10 (A)
I_Range_B: U10.24 (IO33), U14.9 (B), U16.9 (B), U19.2, U23.9 (B)
I_Sens: R21.2, R22.2, R23.2, R24.2, U2.7, U21.3 (+)
I_Square: R42.2, U4.7, U7.4 (STOP), U10.34 (IO41)
unnamed: C39.2, R35.1, R36.2
unnamed: C43.2, R37.2, R38.1
unnamed: D1.2 (A), R1.1
unnamed: D2.2 (A), K1.A2, Q1.3 (D)
unnamed: D3.2 (A), U5.7
unnamed: D4.2 (A), U5.14
unnamed: C49.1, D5.1 (K), R39.1, U4.3 (+)
unnamed: C47.1, D6.1 (K), R41.1, U4.5 (+)
unnamed: D7.2 (A), U23.12 (X0)
unnamed: D8.2 (A), U23.14 (X1)
unnamed: D9.2 (A), U23.15 (X2)
unnamed: D10.2 (A), U23.11 (X3)
unnamed: D11.2 (A), U20.1 (Y0)
unnamed: D12.2 (A), U20.5 (Y1)
unnamed: D13.2 (A), U20.2 (Y2)
unnamed: D14.2 (A), U20.4 (Y3)
unnamed: D15.2 (A), U18.1 (Y0)
unnamed: D16.2 (A), U18.5 (Y1)
unnamed: D17.2 (A), U18.2 (Y2)
unnamed: D18.2 (A), U18.4 (Y3)
unnamed: D19.2 (DOUT), D21.4 (DIN)
unnamed: D20.1 (K), R48.2
unnamed: D21.2 (DOUT), D22.4 (DIN)
unnamed: D22.2 (DOUT), D23.4 (DIN)
unnamed: J2.1 (In), U17.2 (-)
unnamed: J3.1 (In), U17.3 (+)
unnamed: J4.1 (In), R16.2, R17.2, R18.2, R19.2
unnamed: J6.2, U10.36 (RXD0)
unnamed: J6.3, U10.37 (TXD0)
unnamed: J6.4, U10.9 (IO16)
unnamed: J6.7, U10.10 (IO17)
unnamed: JP1.2 (C), U13.1 (HVC/A0)
unnamed: JP2.1 (A), U22.7 (OUT)
unnamed: JP2.3 (B), U1.P$10 (VOUT)
unnamed: JP3.1 (A), U22.4 (SCLK)
unnamed: Q1.1 (G), U19.4
unnamed: R10.1, R11.2
unnamed: R25.2, R26.1
unnamed: R28.1, R29.2
unnamed: R30.2, R32.1
unnamed: R31.2, R34.1
unnamed: R6.2, SW1.2 (B), U10.3 (EN)
unnamed: R8.2, SW2.2 (B), U10.27 (IO0)
unnamed: R49.2, SW3.2 (B), U10.8 (IO15)
unnamed: C14.2, C15.2, U1.P$3 (CAP/2.5V)
unnamed: C16.1, U1.P$1 (COMP)
unnamed: U1.P$5 (MCLK), X1.3 (OUT)
unnamed: U2.8, U2.9 (-), U2.10 (+)
unnamed: U2.12 (+), U2.13 (-), U2.14
unnamed: C40.1, R35.2, U5.3 (+)
unnamed: C49.2, R36.1, U5.5 (+), U17.6
unnamed: C42.1, R38.2, U5.10 (+)
unnamed: C47.2, R37.1, U5.12 (+), U21.6
unnamed: U7.5 (CLOCK), X2.3 (OUT)
unnamed: C50.1, U7.13 (VREG)
unnamed: C3.1, U8.10 (C+)
unnamed: C3.2, U8.9 (C-)
unnamed: C6.1, U8.5 (CP)
unnamed: R2.1, R3.1, U8.2 (FB+)
unnamed: R4.1, R5.1, U8.7 (FB-)
unnamed: R7.2, U10.16 (IO46)
unnamed: R11.1, U12.2 (-), U13.5 (P0A)
unnamed: C19.1, R9.1, U12.5 (+)
unnamed: R12.1, U12.6 (-), U12.7
unnamed: R12.2, R13.2, R14.1, U12.9 (-)
unnamed: C21.2, R15.2, U12.12 (+)
unnamed: R13.1, U12.13 (-), U12.14
unnamed: C19.2, U13.6 (P0W)
unnamed: R19.1, U14.5 (Y1), U14.14 (X1)
unnamed: R18.1, U14.2 (Y2), U14.15 (X2)
unnamed: R17.1, U14.4 (Y3), U14.11 (X3)
unnamed: U2.2 (-), U14.3 (Y)
unnamed: R22.1, U16.5 (Y1), U16.14 (X1)
unnamed: R23.1, U16.2 (Y2), U16.15 (X2)
unnamed: R24.1, U16.4 (Y3), U16.11 (X3)
unnamed: U2.6 (-), U16.3 (Y), U21.2 (-)
unnamed: R25.1, U18.14 (X1)
unnamed: R27.1, U18.15 (X2)
unnamed: R29.1, U18.11 (X3)
unnamed: R46.2, U18.3 (Y)
unnamed: R30.1, U20.14 (X1)
unnamed: R33.1, U20.15 (X2)
unnamed: R31.1, U20.11 (X3)
unnamed: R47.2, U20.3 (Y)
unnamed: R45.2, U23.13 (X)
Peak_Hold_RST: Q2.1 (G), Q3.1 (G), U10.33 (IO40)
Rg_1_A: U17.8 (Rg), U18.13 (X)
Rg_1_B: R26.2, R27.2, R28.2, U17.1 (Rg)
Rg_2_A: U20.13 (X), U21.8 (Rg)
Rg_2_B: R32.2, R33.2, R34.2, U21.1 (Rg)
SW_BYPASS_1_A: K1.11, U2.1, U14.13 (X)
SW_BYPASS_1_B: K1.14, R16.1, U14.1 (Y0), U14.12 (X0)
SW_BYPASS_2_A: J1.1 (In), K1.21, U16.13 (X)
SW_BYPASS_2_B: K1.24, R21.1, U16.1 (Y0), U16.12 (X0)
TDC_!CS: U7.11 (~CS), U10.18 (IO10)
TDC_Enable: U7.1 (ENABLE), U10.32 (IO39)
TDC_Int: U7.2 (TRIGG), U10.5 (IO5)
TDC_MISO: U7.9 (DOUT), U10.21 (IO13)
TDC_MOSI: U7.10 (DIN), U10.19 (IO11)
TDC_SCLK: U7.12 (SCLK), U10.20 (IO12)
TDC_Trig: U7.8 (~INT), U10.6 (IO6)
V_Mean: C39.1, U3.7 (AIN3), U5.1, U5.2 (-)
V_PGA_A: U10.29 (IO36), U18.10 (A)
V_PGA_B: U10.28 (IO35), U18.9 (B)
V_Peak: C41.2, D3.1 (K), Q2.3 (D), U3.6 (AIN2), U5.6 (-)
V_Square: R40.2, U4.1, U7.3 (START), U10.35 (IO42)
