degesz/LATEX_Bakalarka/priloha/2nd_prototype_LCRmeter/V2_LCR_Meter.kicad_pcb

## KiCad design priloha/2nd_prototype_LCRmeter/V2_LCR_Meter.kicad_pcb (2026-05-05)

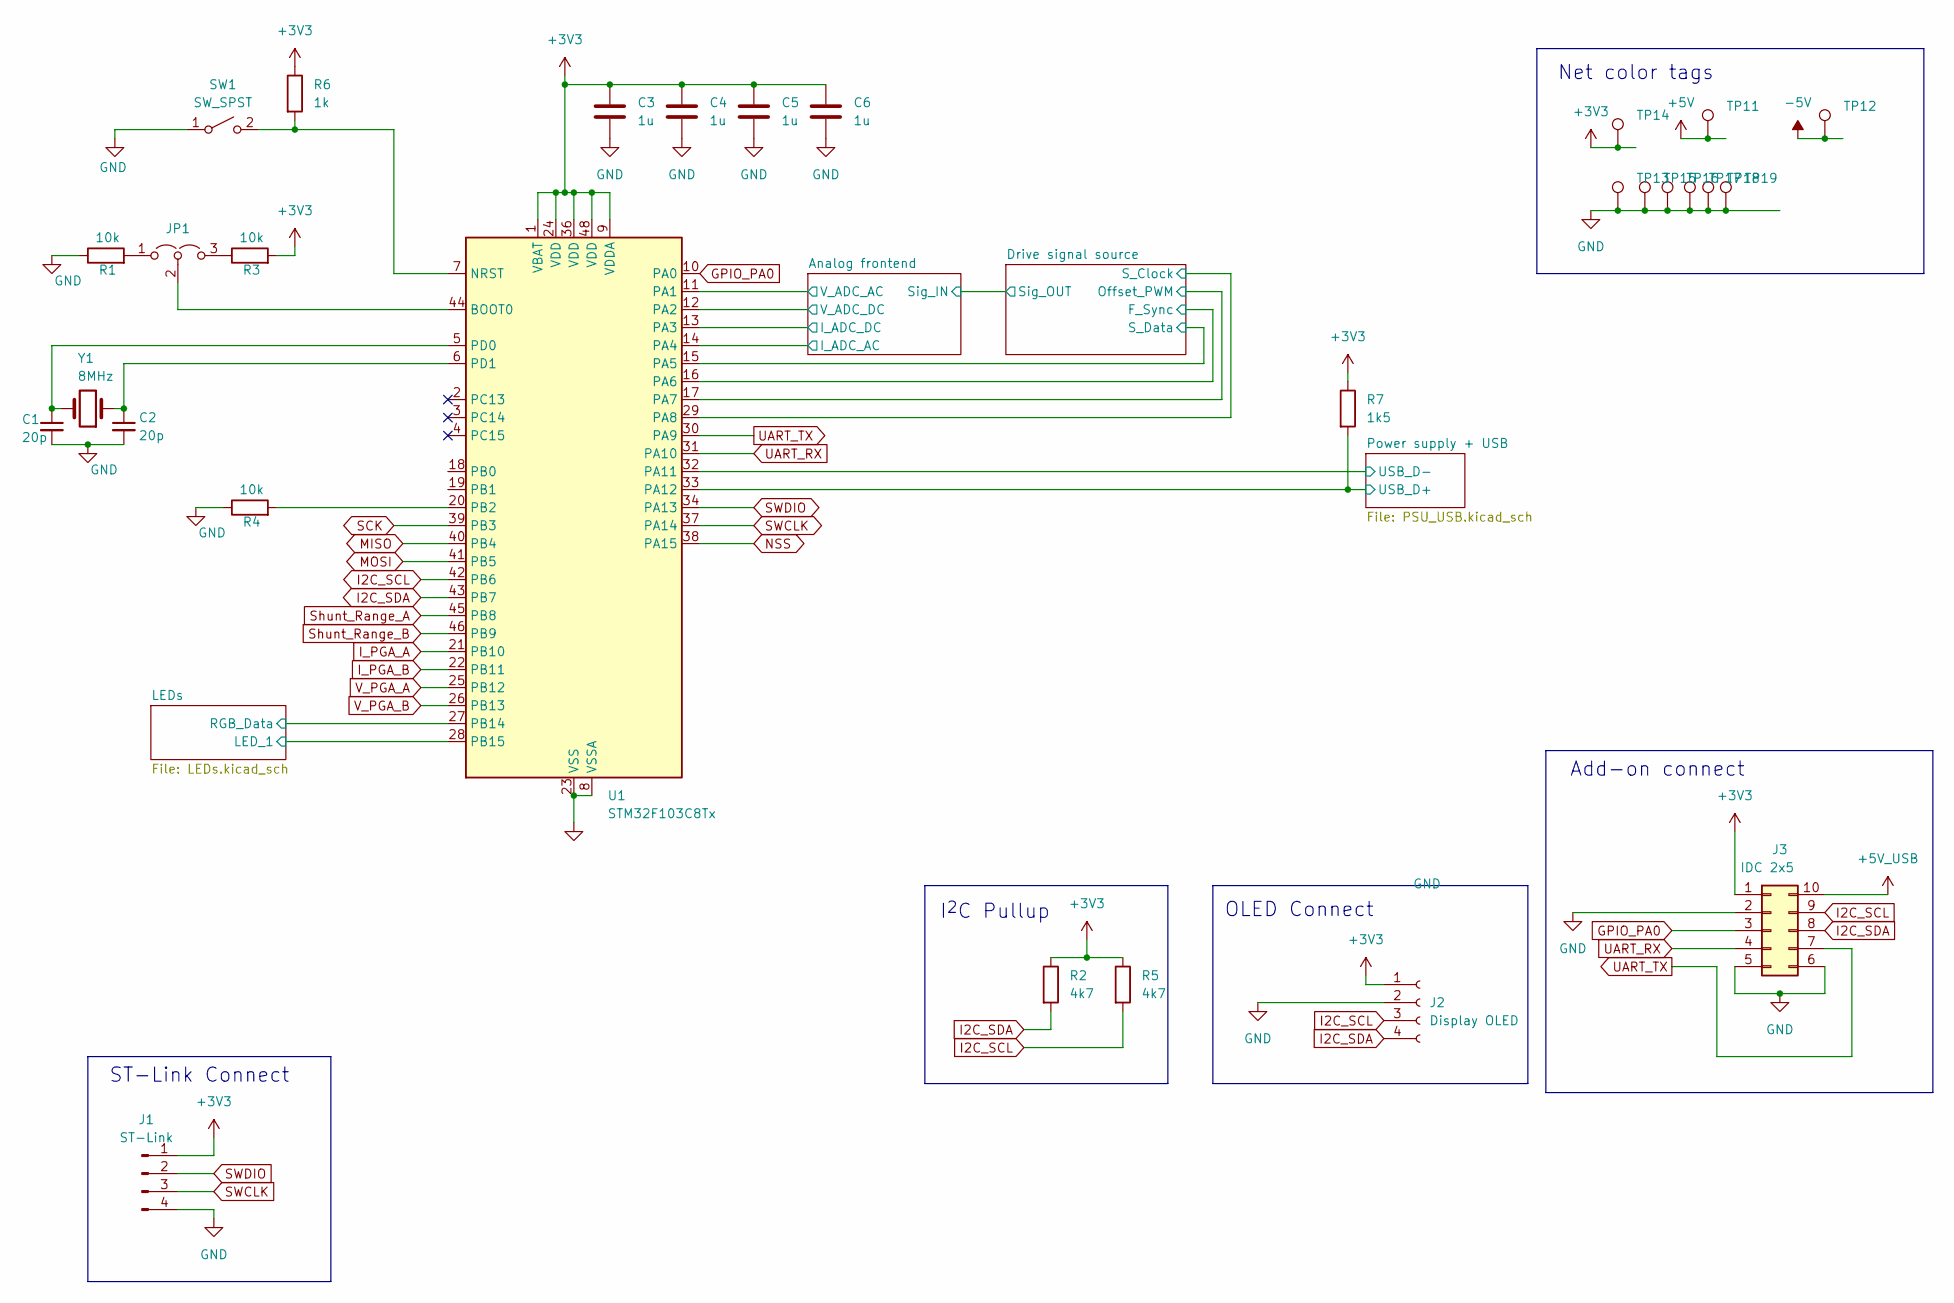
[picture p120: schematic V2_LCR_Meter.kicad_sch, LCR Meter - Microcontroller]

Parts:
C1, C2: 20p; C_0603_1608Metric_Pad1.08x0.95mm_HandSolder
C3, C4, C5, C6: 1u; C_0603_1608Metric_Pad1.08x0.95mm_HandSolder
J1: ST-Link; PinHeader_1x04_P2.54mm_Vertical_SMD_Pin1Left
J2: Display OLED; FanPinHeader_1x04_P2.54mm_Vertical
J3: IDC 2x5; IDC-Header_2x05_P2.54mm_Vertical
JP1: Jumper_3_Open; PinHeader_1x03_P2.54mm_Vertical_SMD_Pin1Left
R1, R3, R4: 10k; R_0603_1608Metric_Pad0.98x0.95mm_HandSolder
R2, R5: 4k7; R_0603_1608Metric_Pad0.98x0.95mm_HandSolder
R6: 1k; R_0603_1608Metric_Pad0.98x0.95mm_HandSolder
R7: 1k5; R_0603_1608Metric_Pad0.98x0.95mm_HandSolder
SW1: SW_SPST; SW-SMD_L6.1-W3.7-LS7.9
TP11, TP12, TP13, TP14, TP15, TP16, TP17, TP18, TP19: TestPoint; Pin_D1.0mm_L10.0mm
U1: STM32F103C8Tx; LQFP-48_7x7mm_P0.5mm
Y1: 8MHz; Crystal_HC49-U_Vertical

Connections:
+3V3: C3.2, C4.2, C5.2, C6.2, J1.1, J2.1, J3.1, R2.1, R3.2, R5.1, R6.1, R7.1, TP14.1, U1.1 (VBAT), U1.9 (VDDA), U1.24 (VDD), U1.36 (VDD), U1.48 (VDD); also elsewhere on the board
+5V: TP11.1; also elsewhere on the board
+5V_USB: J3.10; also elsewhere on the board
-5V: TP12.1; also elsewhere on the board
/Analog frontend/I_HighPass: U1.14 (PA4); also elsewhere on the board
/Analog frontend/I_LowPass: U1.13 (PA3); also elsewhere on the board
/Analog frontend/V_HighPass: U1.11 (PA1); also elsewhere on the board
/Analog frontend/V_LowPass: U1.12 (PA2); also elsewhere on the board
/Drive signal source/F_Sync: U1.16 (PA6); also elsewhere on the board
/Drive signal source/Offset_PWM: U1.17 (PA7); also elsewhere on the board
/Drive signal source/S_Clock: U1.29 (PA8); also elsewhere on the board
/Drive signal source/S_Data: U1.15 (PA5); also elsewhere on the board
/LEDs/LED_1: U1.28 (PB15); also elsewhere on the board
/LEDs/RGB_Data: U1.27 (PB14); also elsewhere on the board
/Power supply + USB/USB_D+: R7.2, U1.33 (PA12); also elsewhere on the board
/Power supply + USB/USB_D-: U1.32 (PA11); also elsewhere on the board
GND: C1.2, C2.2, C3.1, C4.1, C5.1, C6.1, J1.4, J2.2, J3.2, J3.5, J3.6, R1.1, R4.1, SW1.1 (A), TP13.1, TP15.1, TP16.1, TP17.1, TP18.1, TP19.1, U1.8 (VSSA), U1.23 (VSS), U1.35 (VSS), U1.47 (VSS); also elsewhere on the board
GPIO_PA0: J3.3, U1.10 (PA0)
I2C_SCL: J2.3, J3.9, R5.2, U1.42 (PB6); also elsewhere on the board
I2C_SDA: J2.4, J3.8, R2.2, U1.43 (PB7); also elsewhere on the board
I_PGA_A: U1.21 (PB10); also elsewhere on the board
I_PGA_B: U1.22 (PB11); also elsewhere on the board
MISO: U1.40 (PB4)
MOSI: U1.41 (PB5)
NSS: U1.38 (PA15)
unnamed: JP1.1 (A), R1.2
unnamed: JP1.3 (B), R3.1
unnamed: JP1.2 (C), U1.44 (BOOT0)
unnamed: R6.2, SW1.2 (B), U1.7 (NRST)
unnamed: R4.2, U1.20 (PB2)
unnamed: C1.1, U1.5 (PD0), Y1.2
unnamed: C2.1, U1.6 (PD1), Y1.1
SCK: U1.39 (PB3)
SWCLK: J1.3, U1.37 (PA14)
SWDIO: J1.2, U1.34 (PA13)
Shunt_Range_A: U1.45 (PB8); also elsewhere on the board
Shunt_Range_B: U1.46 (PB9); also elsewhere on the board
UART_RX: J3.4, U1.31 (PA10)
UART_TX: J3.7, U1.30 (PA9)
V_PGA_A: U1.25 (PB12); also elsewhere on the board
V_PGA_B: U1.26 (PB13); also elsewhere on the board

Notes on the sheet:
ST-Link Connect
Net color tags
OLED Connect
I^{2}C Pullup
Add-on connect

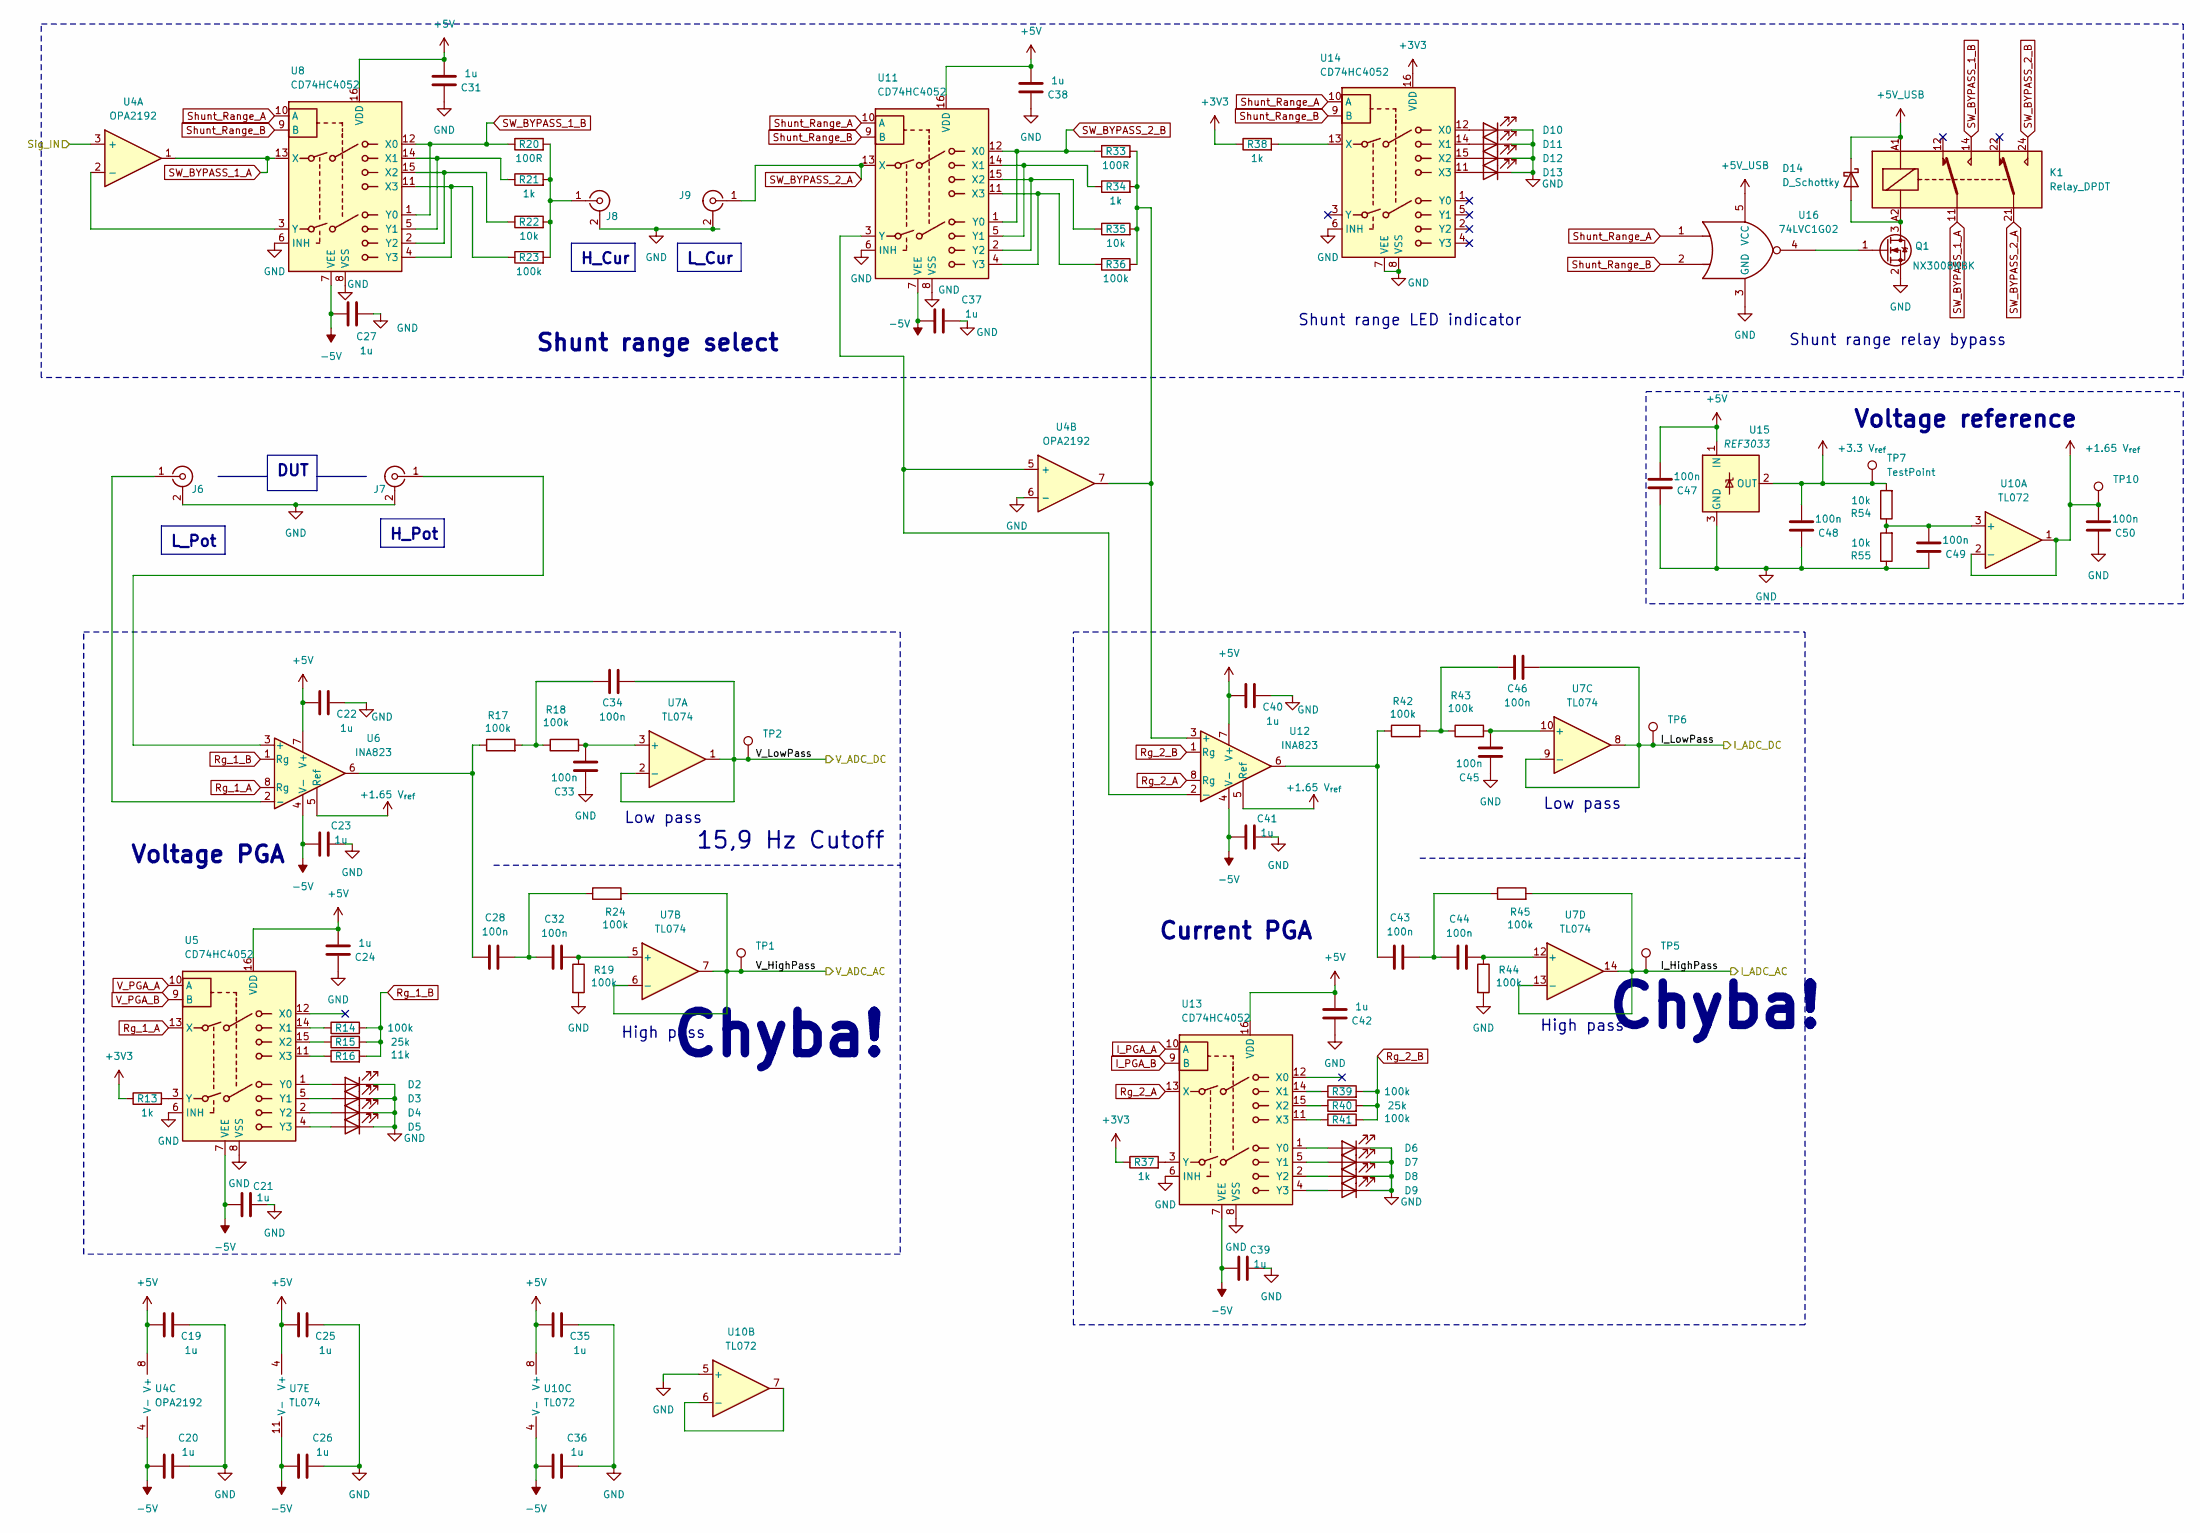
[picture p121: schematic frontend.kicad_sch, LCR Meter - Analog frontend]

Parts:
C19, C20, C21, C22, C23, C24, C25, C26, C27, C31, C35, C36, C37, C38, C39, C40, C41, C42: 1u; C_0603_1608Metric_Pad1.08x0.95mm_HandSolder
C28, C32, C33, C34, C43, C44, C45, C46, C47, C48, C49, C50: 100n; C_0603_1608Metric_Pad1.08x0.95mm_HandSolder
D2, D3, D4, D5, D6, D7, D8, D9, D10, D11, D12, D13: LED; LED_miniPLCC_2315
D14: D_Schottky; D_MiniMELF
J6, J7, J8, J9: Conn_Coaxial; BNC_Gold
K1: Relay_DPDT; Relay_DPDT_Finder_30.22
Q1: NX3008NBK; SOT-323_SC-70_Handsoldering
R13, R21, R34, R37, R38: 1k; R_0603_1608Metric_Pad0.98x0.95mm_HandSolder
R14, R17, R18, R19, R23, R24, R36, R39, R41, R42, R43, R44, R45: 100k; R_0603_1608Metric_Pad0.98x0.95mm_HandSolder
R15, R40: 25k; R_0603_1608Metric_Pad0.98x0.95mm_HandSolder
R16: 11k; R_0603_1608Metric_Pad0.98x0.95mm_HandSolder
R20, R33: 100R; R_0603_1608Metric_Pad0.98x0.95mm_HandSolder
R22, R35, R54, R55: 10k; R_0603_1608Metric_Pad0.98x0.95mm_HandSolder
TP1, TP2, TP5, TP6, TP7, TP10: TestPoint; Pin_D1.0mm_L10.0mm
U4: OPA2192; SOIC-8_3.9x4.9mm_P1.27mm
U5, U8, U11, U13, U14: CD74HC4052; TSSOP-16_4.4x5mm_P0.65mm
U6, U12: INA823; SOIC-8_3.9x4.9mm_P1.27mm
U7: TL074; TSSOP-14_4.4x5mm_P0.65mm
U10: TL072; SOIC-8_3.9x4.9mm_P1.27mm
U15: REF3033; SOT-23
U16: 74LVC1G02; SOT-23-5_HandSoldering

Connections:
+1.65 V_{ref}: C50.2, TP10.1, U6.5 (Ref), U10.1, U10.2 (-), U12.5 (Ref)
+3.3 V_{ref}: C48.2, R54.2, TP7.1, U15.2 (OUT)
+3V3: R13.1, R37.1, R38.1, U14.16 (VDD); also elsewhere on the board
+5V: C19.2, C22.2, C24.2, C25.2, C31.2, C35.2, C38.2, C40.2, C42.2, C47.2, U4.8 (V+), U5.16 (VDD), U6.7 (V+), U7.4 (V+), U8.16 (VDD), U10.8 (V+), U11.16 (VDD), U12.7 (V+), U13.16 (VDD), U15.1 (IN); also elsewhere on the board
+5V_USB: D14.1 (K), K1.A1, U16.5 (VCC); also elsewhere on the board
-5V: C20.2, C21.2, C23.2, C26.2, C27.2, C36.2, C37.2, C39.2, C41.2, U4.4 (V-), U5.7 (VEE), U6.4 (V-), U7.11 (V-), U8.7 (VEE), U10.4 (V-), U11.7 (VEE), U12.4 (V-), U13.7 (VEE); also elsewhere on the board
/Analog frontend/I_HighPass: R45.2, TP5.1, U7.13 (-), U7.14; also elsewhere on the board
/Analog frontend/I_LowPass: C46.1, TP6.1, U7.8, U7.9 (-); also elsewhere on the board
/Analog frontend/Sig_IN: U4.3 (+); also elsewhere on the board
/Analog frontend/V_HighPass: R24.2, TP1.1, U7.6 (-), U7.7; also elsewhere on the board
/Analog frontend/V_LowPass: C34.1, TP2.1, U7.1, U7.2 (-); also elsewhere on the board
GND: C19.1, C20.1, C21.1, C22.1, C23.1, C24.1, C25.1, C26.1, C27.1, C31.1, C33.2, C35.1, C36.1, C37.1, C38.1, C39.1, C40.1, C41.1, C42.1, C45.2, C47.1, C48.1, C49.1, C50.1, D2.1 (K), D3.1 (K), D4.1 (K), D5.1 (K), D6.1 (K), D7.1 (K), D8.1 (K), D9.1 (K), D10.1 (K), D11.1 (K), D12.1 (K), D13.1 (K), J6.2 (Ext), J7.2 (Ext), J8.2 (Ext), J9.2 (Ext), Q1.2 (S), R19.2, R44.2, R55.1, U4.6 (-), U5.6 (INH), U5.8 (VSS), U8.6 (INH), U8.8 (VSS), U10.5 (+), U11.6 (INH), U11.8 (VSS), U13.6 (INH), U13.8 (VSS), U14.6 (INH), U14.7 (VEE), U14.8 (VSS), U15.3 (GND), U16.3 (GND); also elsewhere on the board
I_PGA_A: U13.10 (A); also elsewhere on the board
I_PGA_B: U13.9 (B); also elsewhere on the board
unnamed: C28.1, C32.2, R24.1
unnamed: C28.2, R17.1, U6.6
unnamed: C34.2, R17.2, R18.1
unnamed: C43.1, C44.2, R45.1
unnamed: C43.2, R42.1, U12.6
unnamed: C46.2, R42.2, R43.1
unnamed: D2.2 (A), U5.1 (Y0)
unnamed: D3.2 (A), U5.5 (Y1)
unnamed: D4.2 (A), U5.2 (Y2)
unnamed: D5.2 (A), U5.4 (Y3)
unnamed: D6.2 (A), U13.1 (Y0)
unnamed: D7.2 (A), U13.5 (Y1)
unnamed: D8.2 (A), U13.2 (Y2)
unnamed: D9.2 (A), U13.4 (Y3)
unnamed: D10.2 (A), U14.12 (X0)
unnamed: D11.2 (A), U14.14 (X1)
unnamed: D12.2 (A), U14.15 (X2)
unnamed: D13.2 (A), U14.11 (X3)
unnamed: D14.2 (A), K1.A2, Q1.3 (D)
unnamed: J6.1 (In), U6.2 (-)
unnamed: J7.1 (In), U6.3 (+)
unnamed: J8.1 (In), R20.2, R21.2, R22.2, R23.2
unnamed: Q1.1 (G), U16.4
unnamed: U4.2 (-), U8.3 (Y)
unnamed: R14.1, U5.14 (X1)
unnamed: R15.1, U5.15 (X2)
unnamed: R16.1, U5.11 (X3)
unnamed: R13.2, U5.3 (Y)
unnamed: C33.1, R18.2, U7.3 (+)
unnamed: C32.1, R19.1, U7.5 (+)
unnamed: C45.1, R43.2, U7.10 (+)
unnamed: C44.1, R44.1, U7.12 (+)
unnamed: R21.1, U8.5 (Y1), U8.14 (X1)
unnamed: R22.1, U8.2 (Y2), U8.15 (X2)
unnamed: R23.1, U8.4 (Y3), U8.11 (X3)
unnamed: C49.2, R54.1, R55.2, U10.3 (+)
unnamed: U10.6 (-), U10.7
unnamed: R34.1, U11.5 (Y1), U11.14 (X1)
unnamed: R35.1, U11.2 (Y2), U11.15 (X2)
unnamed: R36.1, U11.4 (Y3), U11.11 (X3)
unnamed: U4.5 (+), U11.3 (Y), U12.2 (-)
unnamed: R33.2, R34.2, R35.2, R36.2, U4.7, U12.3 (+)
unnamed: R39.1, U13.14 (X1)
unnamed: R40.1, U13.15 (X2)
unnamed: R41.1, U13.11 (X3)
unnamed: R37.2, U13.3 (Y)
unnamed: R38.2, U14.13 (X)
Rg_1_A: U5.13 (X), U6.8 (Rg)
Rg_1_B: R14.2, R15.2, R16.2, U6.1 (Rg)
Rg_2_A: U12.8 (Rg), U13.13 (X)
Rg_2_B: R39.2, R40.2, R41.2, U12.1 (Rg)
SW_BYPASS_1_A: K1.11, U4.1, U8.13 (X)
SW_BYPASS_1_B: K1.14, R20.1, U8.1 (Y0), U8.12 (X0)
SW_BYPASS_2_A: J9.1 (In), K1.21, U11.13 (X)
SW_BYPASS_2_B: K1.24, R33.1, U11.1 (Y0), U11.12 (X0)
Shunt_Range_A: U8.10 (A), U11.10 (A), U14.10 (A), U16.1; also elsewhere on the board
Shunt_Range_B: U8.9 (B), U11.9 (B), U14.9 (B), U16.2; also elsewhere on the board
V_PGA_A: U5.10 (A); also elsewhere on the board
V_PGA_B: U5.9 (B); also elsewhere on the board

Notes on the sheet:
Low pass
High pass
Current PGA
Shunt range select
Shunt range relay bypass
Chyba!
Voltage reference
Voltage PGA
15,9 Hz Cutoff
Shunt range LED indicator
H_Pot
H_Cur
L_Pot
DUT
L_Cur
