degesz/LATEX_Bakalarka/priloha/2nd_prototype_LCRmeter/V2_LCR_Meter.kicad_pcb

## KiCad design priloha/2nd_prototype_LCRmeter/V2_LCR_Meter.kicad_pcb (continued)

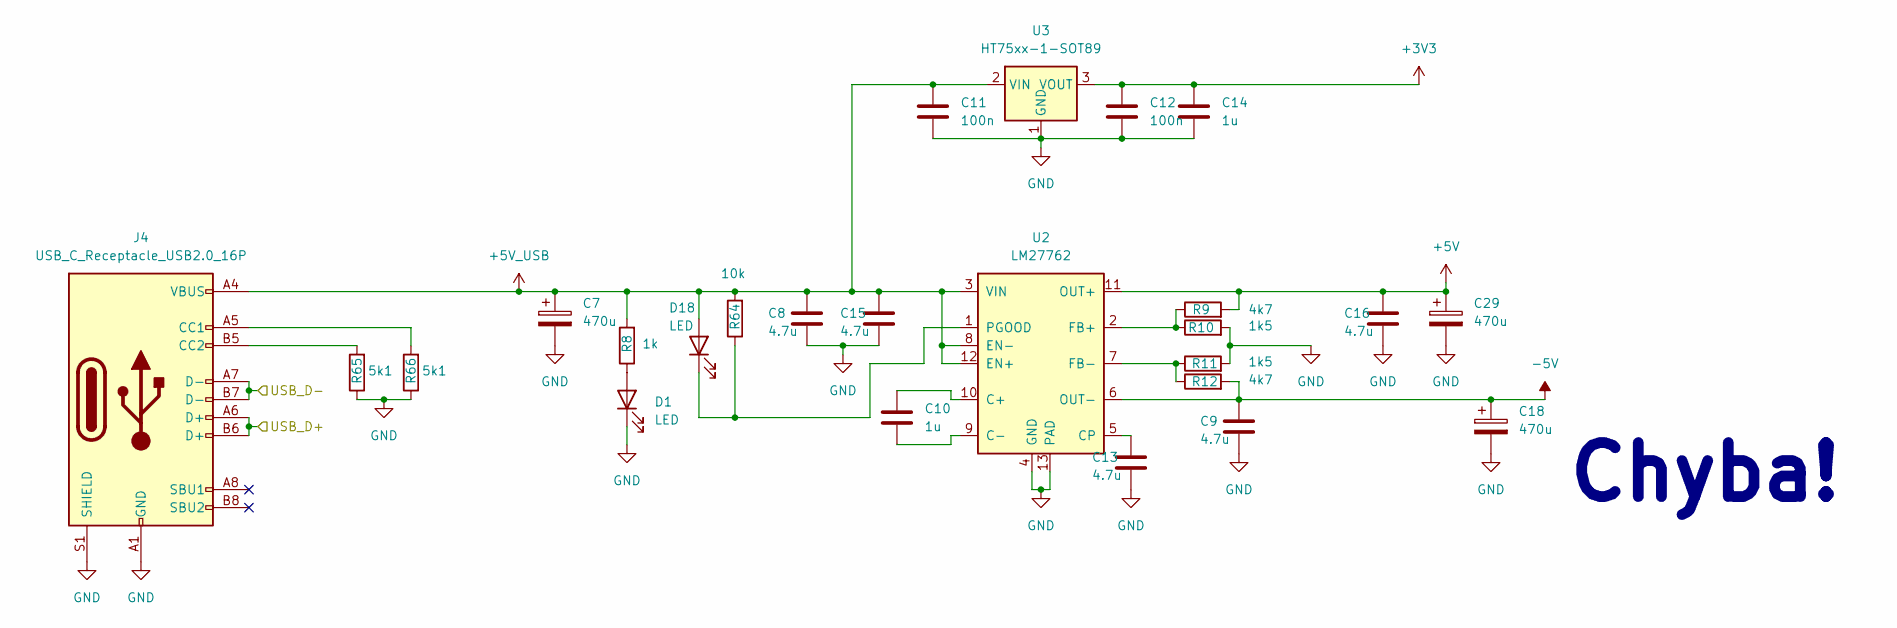
[picture p122: schematic PSU_USB.kicad_sch, LCR Meter - Power supply]

Parts:
C7, C18, C29: 470u; CP_EIA-7343-30_AVX-N_HandSolder
C8, C9, C13, C15, C16: 4.7u; C_0603_1608Metric
C10: 1u; R_0603_1608Metric_Pad0.98x0.95mm_HandSolder
C11, C12: 100n; C_0603_1608Metric_Pad1.08x0.95mm_HandSolder
C14: 1u; C_0603_1608Metric_Pad1.08x0.95mm_HandSolder
D1, D18: LED; LED_miniPLCC_2315_Handsoldering
J4: USB_C_Receptacle_USB2.0_16P; USB_C_Receptacle_GCT_USB4105-xx-A_16P_TopMnt_Horizontal
R8: 1k; R_0603_1608Metric_Pad0.98x0.95mm_HandSolder
R9, R12: 4k7; R_0603_1608Metric_Pad0.98x0.95mm_HandSolder
R10, R11: 1k5; R_0603_1608Metric_Pad0.98x0.95mm_HandSolder
R64: 10k; R_0603_1608Metric_Pad0.98x0.95mm_HandSolder
R65, R66: 5k1; R_0603_1608Metric_Pad0.98x0.95mm_HandSolder
U2: LM27762; WSON-12-1EP_3x2mm_P0.5mm_EP1x2.65_ThermalVias
U3: HT75xx-1-SOT89; SOT-89-3_Handsoldering

Connections:
+3V3: C12.1, C14.1, U3.3 (VOUT); also elsewhere on the board
+5V: C16.1, C29.1, R9.2, U2.11 (OUT+); also elsewhere on the board
+5V_USB: C7.1, C8.1, C11.1, C15.1, D18.2 (A), J4.A4 (VBUS), J4.A9 (VBUS), J4.B4 (VBUS), J4.B9 (VBUS), R8.2, R64.2, U2.3 (VIN), U2.8 (EN-), U2.12 (EN+), U3.2 (VIN); also elsewhere on the board
-5V: C9.1, C18.1, R12.2, U2.6 (OUT-); also elsewhere on the board
/Power supply + USB/USB_D+: J4.A6 (D+), J4.B6 (D+); also elsewhere on the board
/Power supply + USB/USB_D-: J4.A7 (D-), J4.B7 (D-); also elsewhere on the board
GND: C7.2, C8.2, C9.2, C11.2, C12.2, C13.2, C14.2, C15.2, C16.2, C18.2, C29.2, D1.1 (K), J4.A1 (GND), J4.A12 (GND), J4.B1 (GND), J4.B12 (GND), J4.S1 (SHIELD), R10.2, R11.2, R65.1, R66.1, U2.4 (GND), U2.13 (PAD), U3.1 (GND); also elsewhere on the board
unnamed: D1.2 (A), R8.1
unnamed: D18.1 (K), R64.1, U2.1 (PGOOD)
unnamed: J4.A5 (CC1), R66.2
unnamed: J4.B5 (CC2), R65.2
unnamed: C10.1, U2.10 (C+)
unnamed: C10.2, U2.9 (C-)
unnamed: C13.1, U2.5 (CP)
unnamed: R9.1, R10.1, U2.2 (FB+)
unnamed: R11.1, R12.1, U2.7 (FB-)

Notes on the sheet:
Chyba!

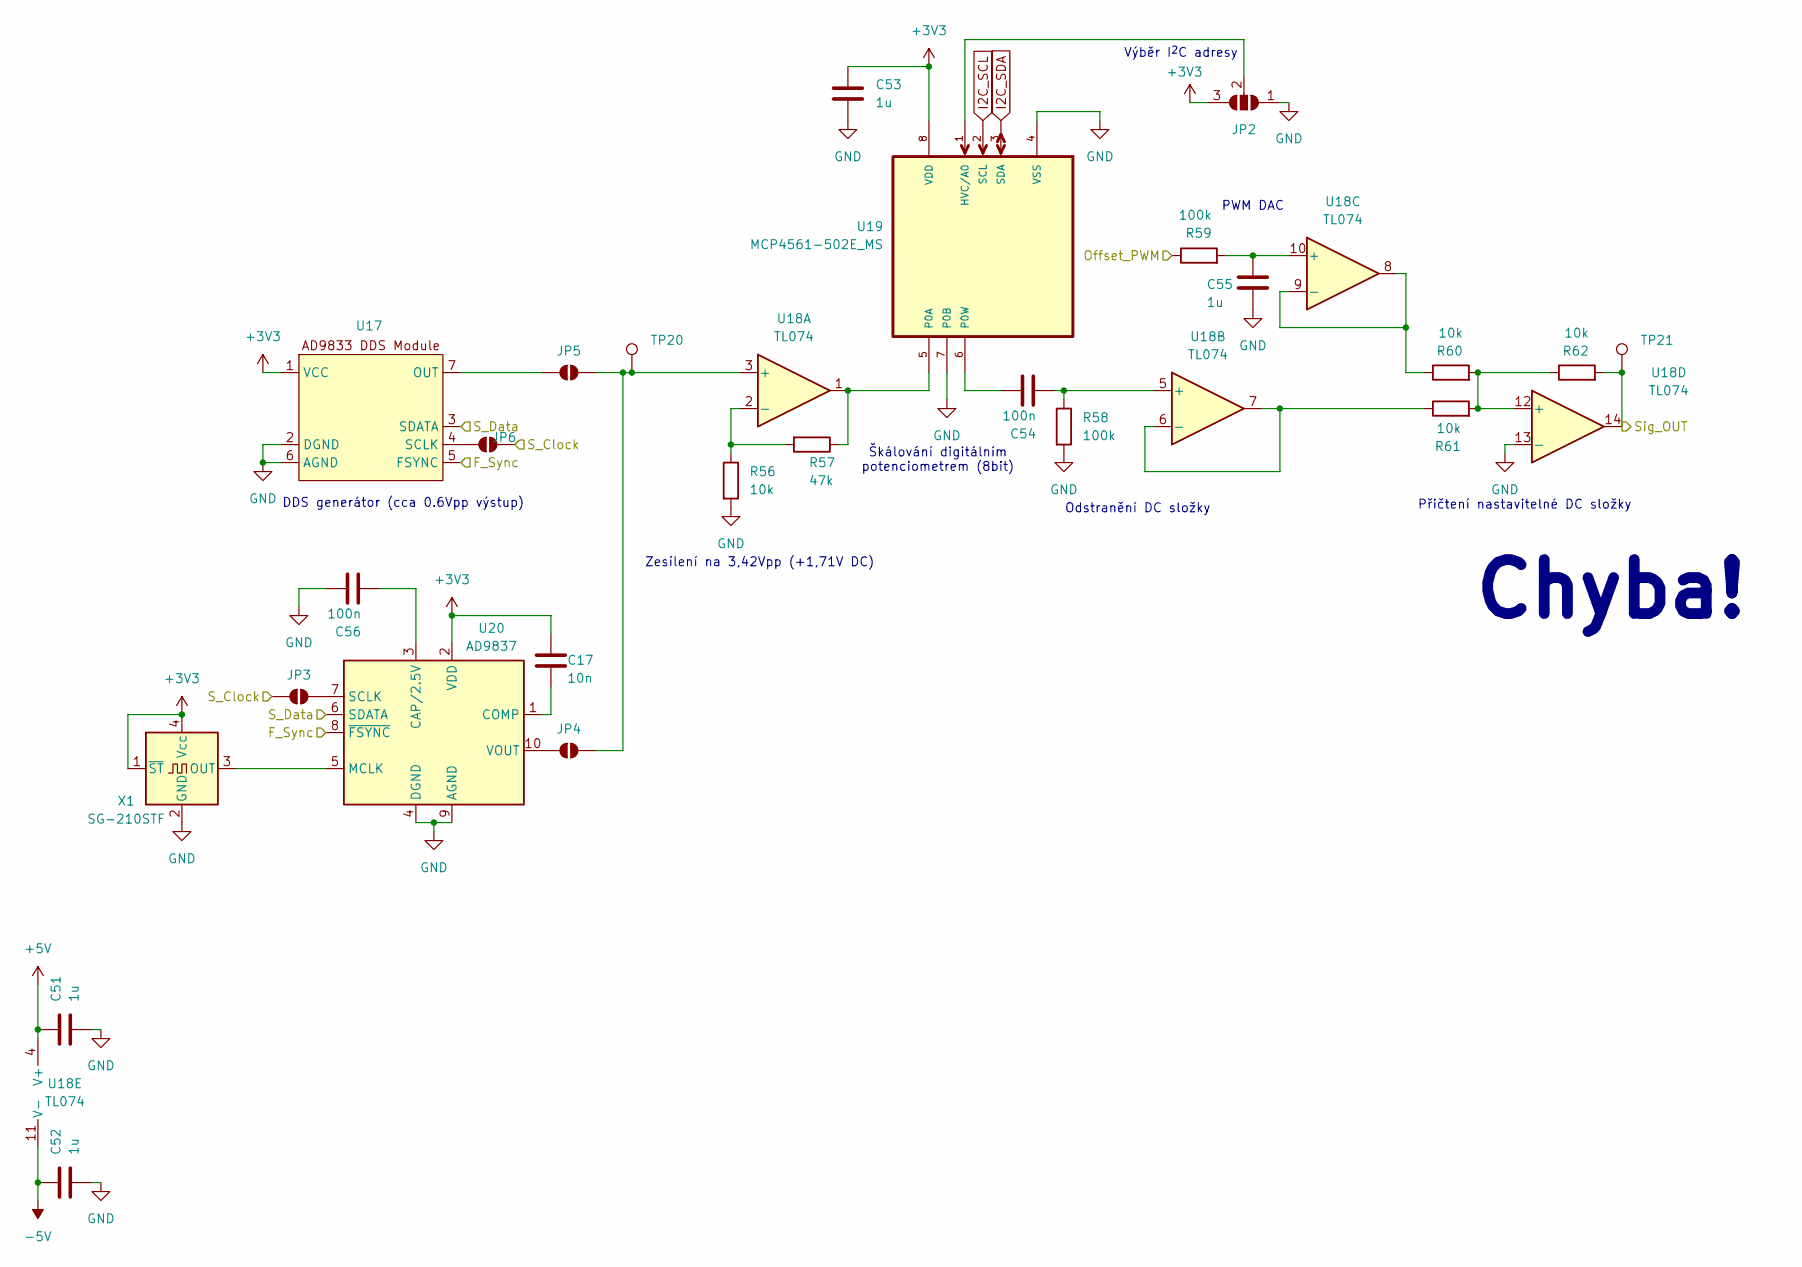
[picture p123: schematic sig_source.kicad_sch, LCR Meter - Signal source]

Parts:
C17: 10n; C_0603_1608Metric_Pad1.08x0.95mm_HandSolder
C51, C52, C53, C55: 1u; C_0603_1608Metric_Pad1.08x0.95mm_HandSolder
C54, C56: 100n; C_0603_1608Metric_Pad1.08x0.95mm_HandSolder
JP2: SolderJumper_3_Open; SolderJumper-3_P1.3mm_Open_RoundedPad1.0x1.5mm
JP3, JP4, JP5, JP6: SolderJumper_2_Open; SolderJumper-2_P1.3mm_Open_RoundedPad1.0x1.5mm
R56, R60, R61, R62: 10k; R_0603_1608Metric_Pad0.98x0.95mm_HandSolder
R57: 47k; R_0603_1608Metric_Pad0.98x0.95mm_HandSolder
R58, R59: 100k; R_0603_1608Metric_Pad0.98x0.95mm_HandSolder
TP20, TP21: TestPoint; Pin_D1.0mm_L10.0mm
U17: AD9833_Module
U18: TL074; TSSOP-14_4.4x5mm_P0.65mm
U19: MCP4561-502E_MS; MSOP-8_3x3mm_P0.65mm; MPN MCP4561-502E/MS
U20: AD9837; LFCSP-WD-10-1EP_3x3mm_P0.5mm_EP1.64x2.38mm
X1: SG-210STF; Oscillator_SMD_SeikoEpson_SG210-4Pin_2.5x2.0mm

Connections:
+3V3: C17.1, C53.2, JP2.3 (B), U17.1 (VCC), U19.8 (VDD), U20.2 (VDD), X1.1 (~ST), X1.4 (Vcc); also elsewhere on the board
+5V: C51.2, U18.4 (V+); also elsewhere on the board
-5V: C52.2, U18.11 (V-); also elsewhere on the board
/Analog frontend/Sig_IN: R62.2, TP21.1, U18.14; also elsewhere on the board
/Drive signal source/F_Sync: U17.5 (FSYNC), U20.8 (~FSYNC); also elsewhere on the board
/Drive signal source/Offset_PWM: R59.1; also elsewhere on the board
/Drive signal source/S_Clock: JP3.1 (A), JP6.2 (B); also elsewhere on the board
/Drive signal source/S_Data: U17.3 (SDATA), U20.6 (SDATA); also elsewhere on the board
GND: C51.1, C52.1, C53.1, C55.1, C56.2, JP2.1 (A), R56.2, R58.2, U17.2 (DGND), U17.6 (AGND), U18.13 (-), U19.4 (VSS), U19.7 (P0B), U20.4 (DGND), U20.9 (AGND), X1.2 (GND); also elsewhere on the board
I2C_SCL: U19.2 (SCL); also elsewhere on the board
I2C_SDA: U19.3 (SDA); also elsewhere on the board
unnamed: JP2.2 (C), U19.1 (HVC/A0)
unnamed: JP3.2 (B), U20.7 (SCLK)
unnamed: JP4.1 (A), U20.10 (VOUT)
unnamed: JP4.2 (B), JP5.2 (B), TP20.1, U18.3 (+)
unnamed: JP5.1 (A), U17.7 (OUT)
unnamed: JP6.1 (A), U17.4 (SCLK)
unnamed: R56.1, R57.2, U18.2 (-)
unnamed: C54.1, R58.1, U18.5 (+)
unnamed: R61.1, U18.6 (-), U18.7
unnamed: C55.2, R59.2, U18.10 (+)
unnamed: R60.1, U18.8, U18.9 (-)
unnamed: R60.2, R61.2, R62.1, U18.12 (+)
unnamed: R57.1, U18.1, U19.5 (P0A)
unnamed: C54.2, U19.6 (P0W)
unnamed: C56.1, U20.3 (CAP/2.5V)
unnamed: C17.2, U20.1 (COMP)
unnamed: U20.5 (MCLK), X1.3 (OUT)

Notes on the sheet:
Výběr I^{2}C adresy
Škálování digitálním potenciometrem (8bit)
Přičtení nastavitelné DC složky
Odstranění DC složky
Zesílení na 3,42Vpp (+1,71V DC)
DDS generátor (cca 0.6Vpp výstup)
Chyba!
PWM DAC

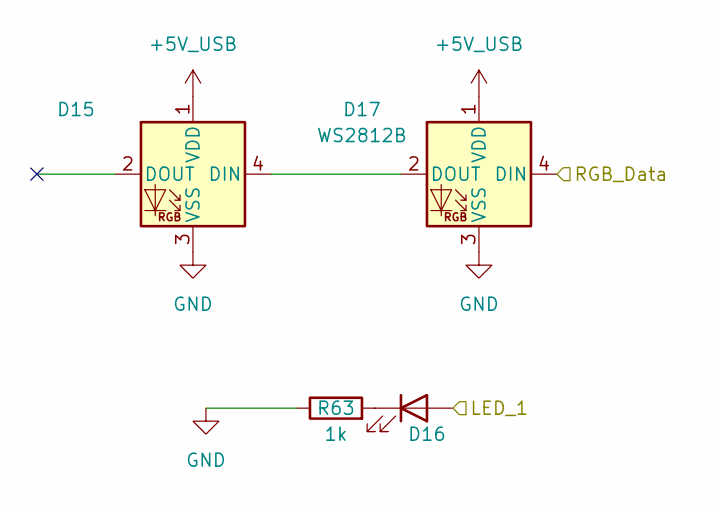
[picture p124: schematic LEDs.kicad_sch, LCR Meter - LEDs]

Parts:
D15, D17: WS2812B; LED_WS2812B_PLCC4_5.0x5.0mm_P3.2mm
D16: LED; LED_miniPLCC_2315
R63: 1k; R_0603_1608Metric_Pad0.98x0.95mm_HandSolder

Connections:
+5V_USB: D15.1 (VDD), D17.1 (VDD); also elsewhere on the board
/LEDs/LED_1: D16.2 (A); also elsewhere on the board
/LEDs/RGB_Data: D17.4 (DIN); also elsewhere on the board
GND: D15.3 (VSS), D17.3 (VSS), R63.1; also elsewhere on the board
unnamed: D15.4 (DIN), D17.2 (DOUT)
unnamed: D16.1 (K), R63.2

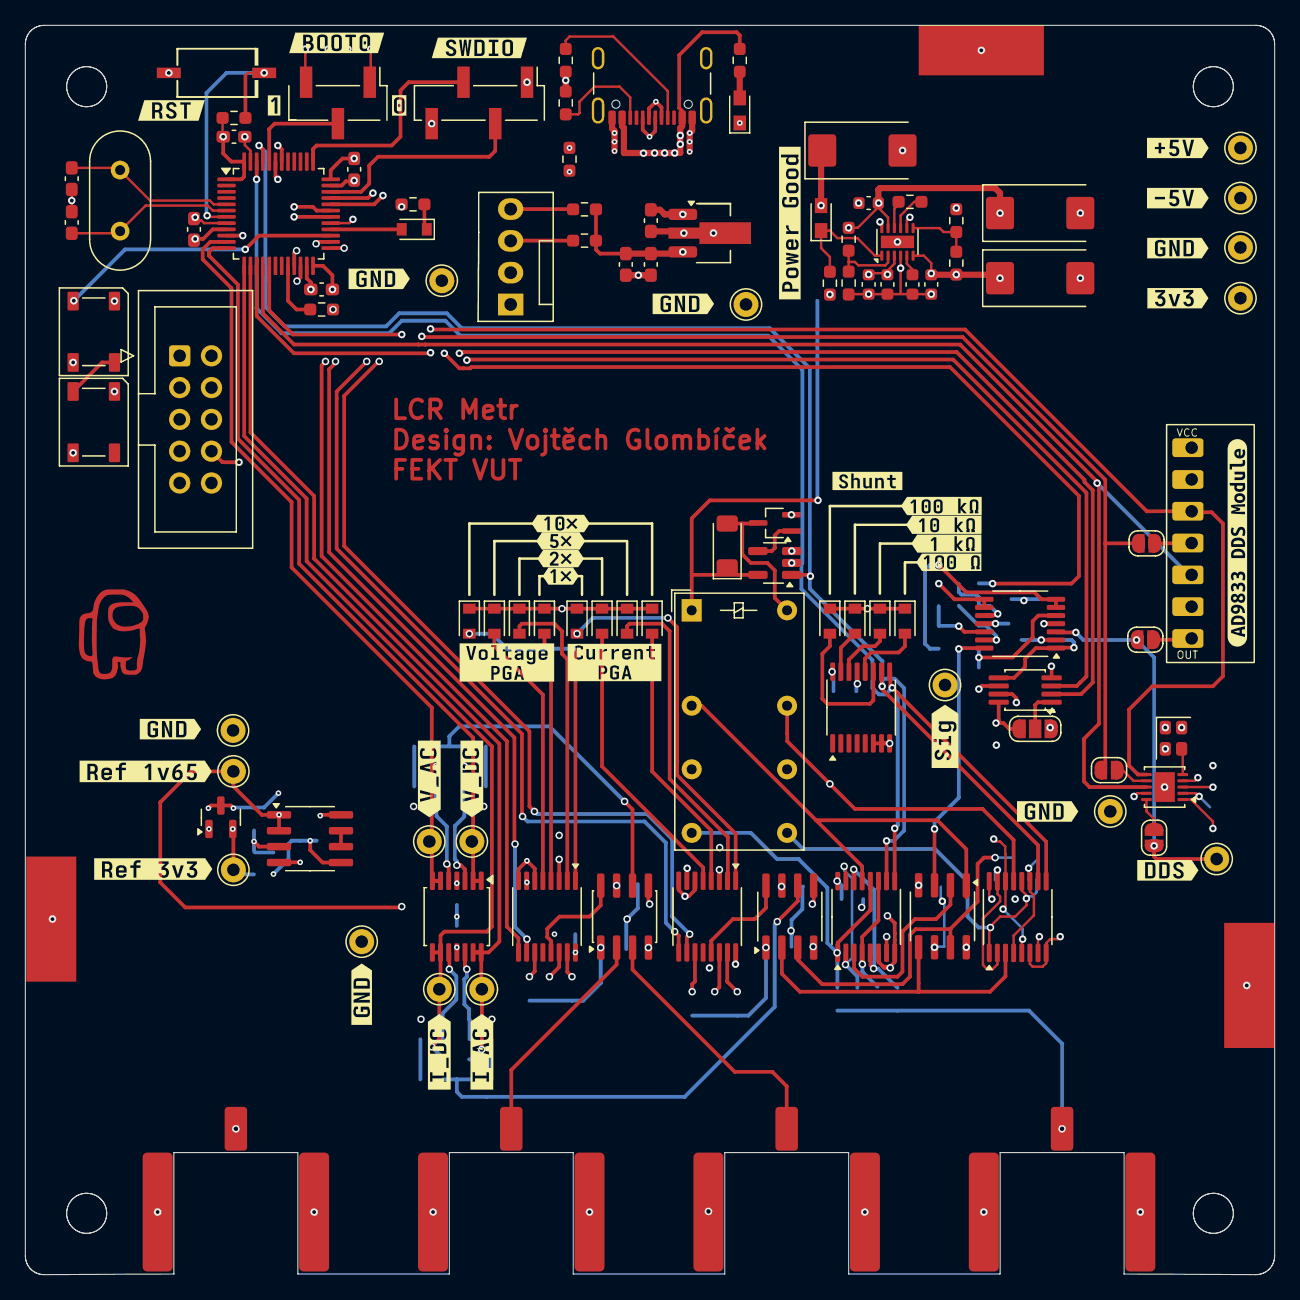
[picture p125: board V2_LCR_Meter.kicad_pcb from above]

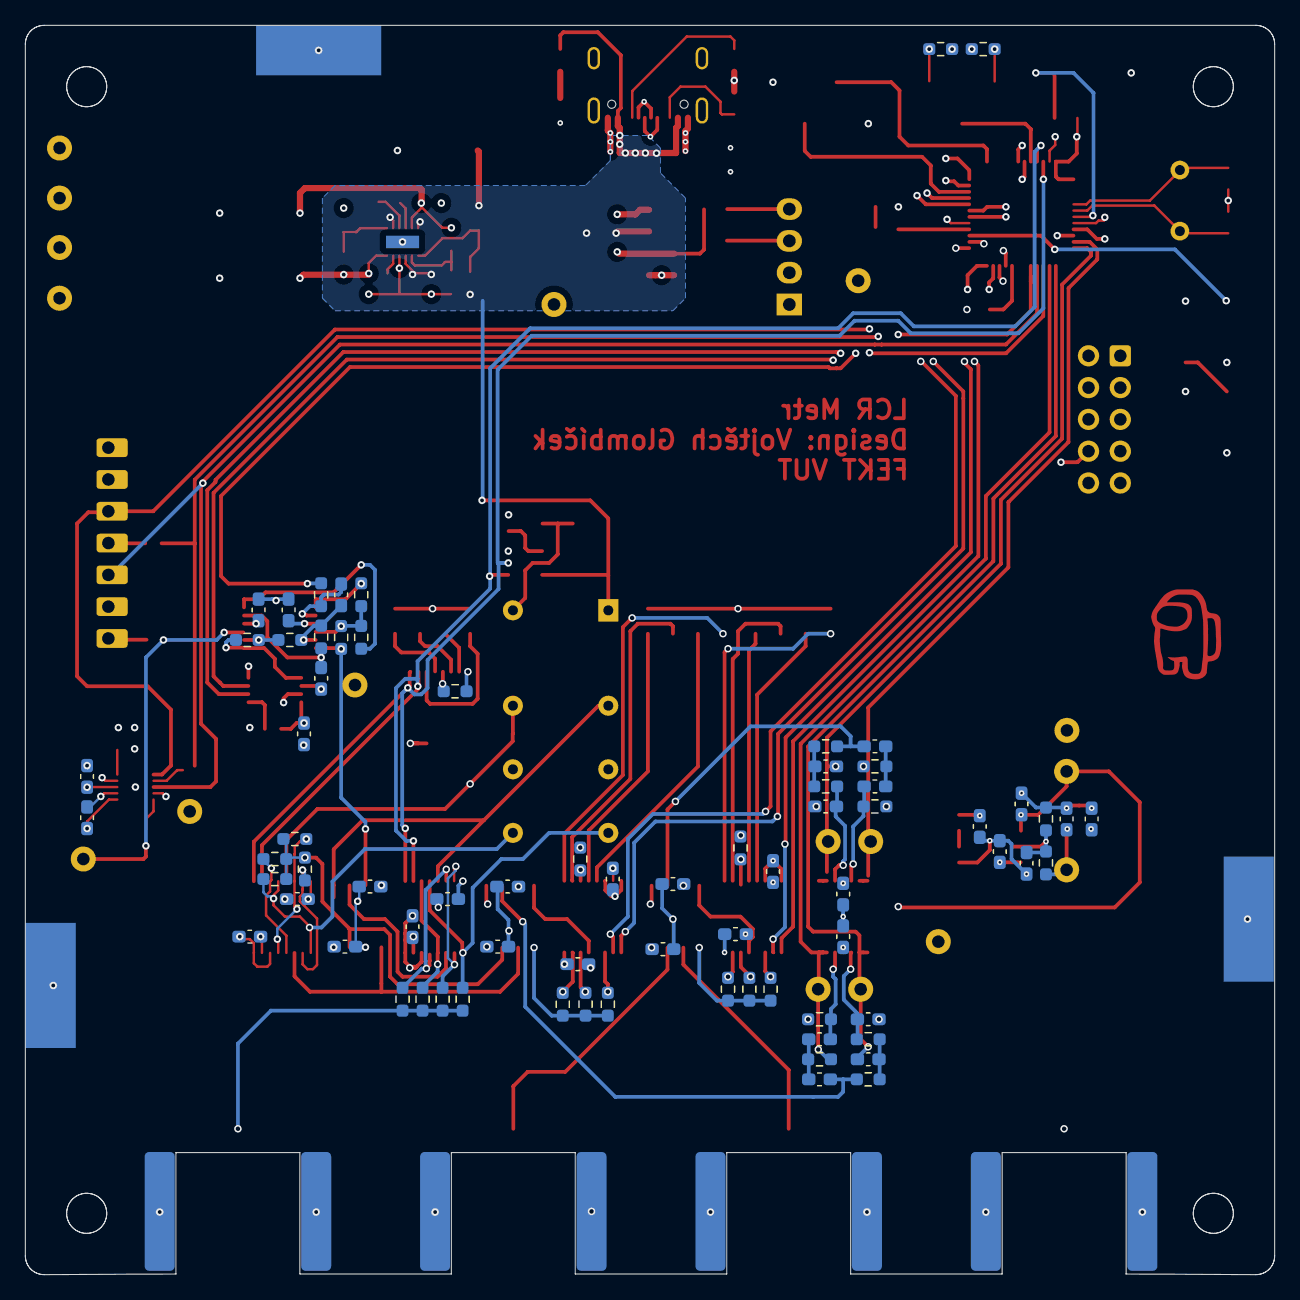
[picture p126: board V2_LCR_Meter.kicad_pcb from below]

Board: 6 copper layers, 99.8 x 99.8 mm, 212 parts (73 on the bottom side), 123 nets.

Other parts of the board:
kibuzzard-69A6FBA9: G***; kibuzzard-69A6FBA9
kibuzzard-69A6FBC7: G***; kibuzzard-69A6FBC7
kibuzzard-69A6FBD5: G***; kibuzzard-69A6FBD5
kibuzzard-69A6FBDC: G***; kibuzzard-69A6FBDC
kibuzzard-69A6FC6B: G***; kibuzzard-69A6FC6B
kibuzzard-69A6FC8C: G***; kibuzzard-69A6FC8C
kibuzzard-69A6FD3E: G***; kibuzzard-69A6FD3E
kibuzzard-69A6FD14: G***; kibuzzard-69A6FD14
kibuzzard-69A6FD47: G***; kibuzzard-69A6FD47
kibuzzard-69A6FD75: G***; kibuzzard-69A6FD75
kibuzzard-69A6FDE1: G***; kibuzzard-69A6FDE1
kibuzzard-69A0511F: G***; kibuzzard-69A0511F
kibuzzard-69A0516F: G***; kibuzzard-69A0516F
kibuzzard-69A0517C: G***; kibuzzard-69A0517C
kibuzzard-69B032D8: G***; kibuzzard-69B032D8
kibuzzard-69B032F6: G***; kibuzzard-69B032F6
kibuzzard-69B01019: G***; kibuzzard-69B01019
kibuzzard-69B01039: G***; kibuzzard-69B01039
kibuzzard-69B01057: G***; kibuzzard-69B01057
kibuzzard-69B03341: G***; kibuzzard-69B03341
kibuzzard-69B03368: G***; kibuzzard-69B03368
kibuzzard-69B03378: G***; kibuzzard-69B03378
kibuzzard-699D9FD2: G***; kibuzzard-699D9FD2
kibuzzard-699DA05C: G***; kibuzzard-699DA05C
kibuzzard-699DA06A, kibuzzard-699DA06A#2, kibuzzard-699DA06A#3, kibuzzard-699DA06A#4, kibuzzard-699DA06A#5, kibuzzard-699DA06A#6: G***; kibuzzard-699DA06A
kibuzzard-699DA06F: G***; kibuzzard-699DA06F
kibuzzard-699DA048: G***; kibuzzard-699DA048
kibuzzard-699DB946: G***; kibuzzard-699DB946
kibuzzard-699DC026: G***; kibuzzard-699DC026
