degesz/LATEX_Bakalarka/Test_board_BAKALARKA/front_panel/front_panel.kicad_pcb

## KiCad design Test_board_BAKALARKA/front_panel/front_panel.kicad_pcb (2026-01-18)

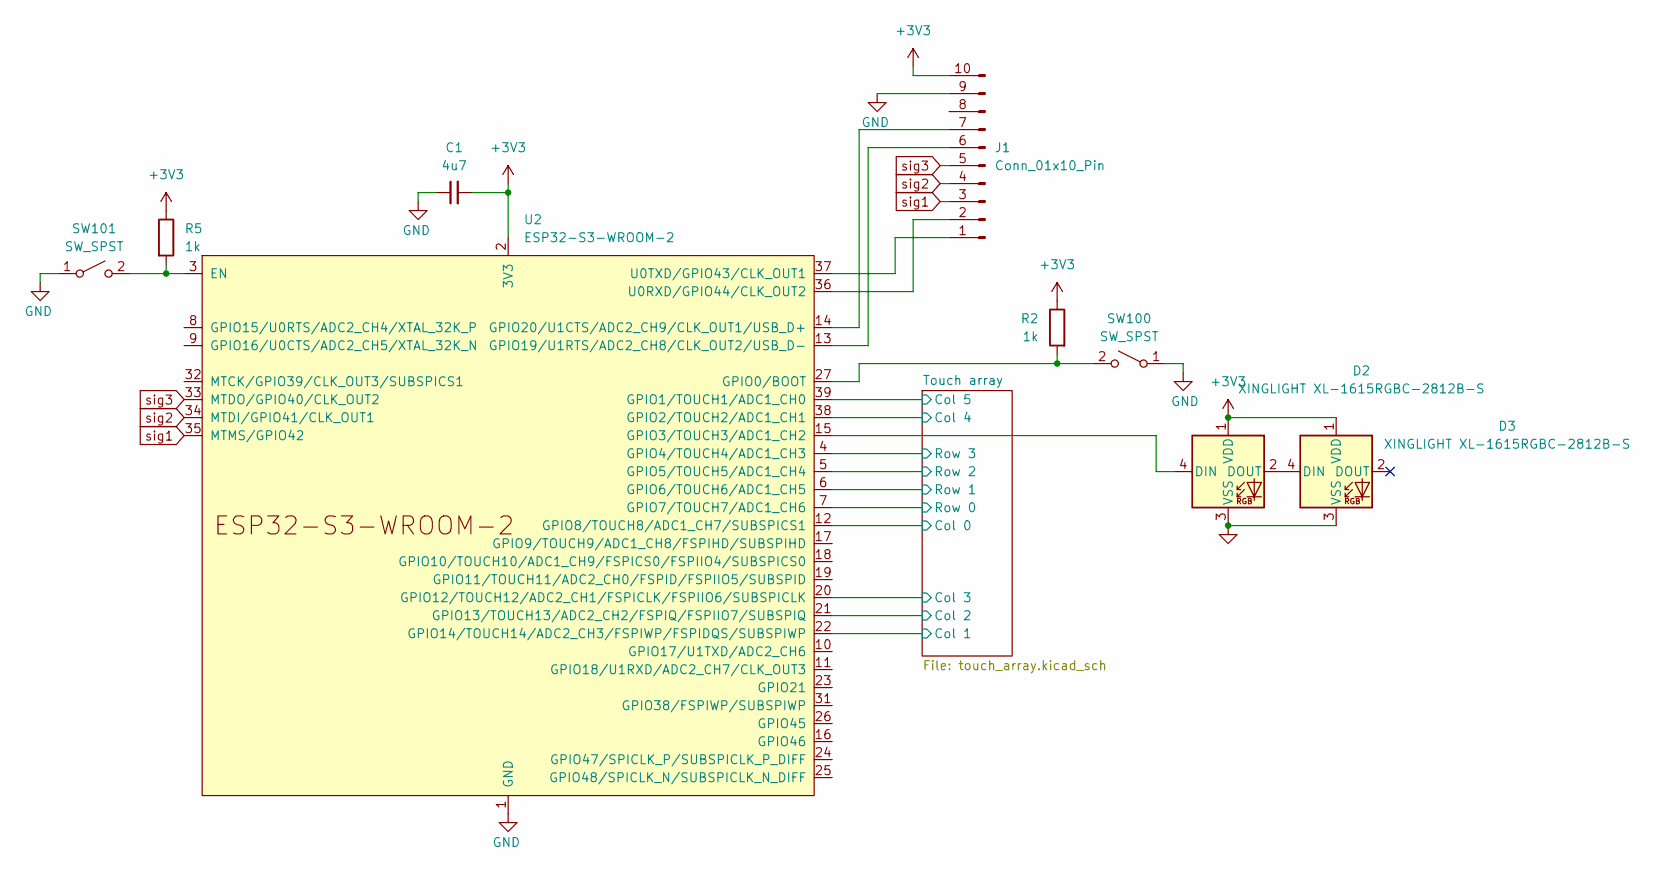
[picture p127: schematic front_panel.kicad_sch]

Parts:
C1: 4u7; C_0805_2012Metric_Pad1.18x1.45mm_HandSolder
D2: XINGLIGHT XL-1615RGBC-2812B-S
D3: XINGLIGHT XL-1615RGBC-2812B-S; Flipped_XINGLIGHT XL-1615RGBC-2812B-S_1
J1: Conn_01x10_Pin; FFC_FPC_10pin_connector
R2, R5: 1k; R_0603_1608Metric_Pad0.98x0.95mm_HandSolder
SW100, SW101: SW_SPST; SW_SPST_CK_RS282G05A3
U2: ESP32-S3-WROOM-2

Connections:
+3V3: C1.2, D2.1 (VDD), D3.1 (VDD), J1.10, R2.1, R5.1, U2.2 (3V3)
/Touch array/Col 0: U2.12 (GPIO8/TOUCH8/ADC1_CH7/SUBSPICS1); also elsewhere on the board
/Touch array/Col 1: U2.22 (GPIO14/TOUCH14/ADC2_CH3/FSPIWP/FSPIDQS/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); also elsewhere on the board
/Touch array/Col 2: U2.21 (GPIO13/TOUCH13/ADC2_CH2/FSPIQ/FSPIIO7/S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); also elsewhere on the board
/Touch array/Col 3: U2.20 (GPIO12/TOUCH12/ADC2_CH1/FSPICLK/FSPIIO6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); also elsewhere on the board
/Touch array/Col 4: U2.38 (GPIO2/TOUCH2/ADC1_CH1); also elsewhere on the board
/Touch array/Col 5: U2.39 (GPIO1/TOUCH1/ADC1_CH0); also elsewhere on the board
/Touch array/Row 0: U2.7 (GPIO7/TOUCH7/ADC1_CH6); also elsewhere on the board
/Touch array/Row 1: U2.6 (GPIO6/TOUCH6/ADC1_CH5); also elsewhere on the board
/Touch array/Row 2: U2.5 (GPIO5/TOUCH5/ADC1_CH4); also elsewhere on the board
/Touch array/Row 3: U2.4 (GPIO4/TOUCH4/ADC1_CH3); also elsewhere on the board
GND: C1.1, D2.3 (VSS), D3.3 (VSS), J1.9, SW100.1 (A), SW101.1 (A), U2.1 (GND), U2.40 (GND), U2.41 (GND)
unnamed: D2.4 (DIN), U2.15 (GPIO3/TOUCH3/ADC1_CH2)
unnamed: D2.2 (DOUT), D3.4 (DIN)
unnamed: J1.1, U2.37 (U0TXD/GPIO43/CLK_OUT1)
unnamed: J1.2, U2.36 (U0RXD/GPIO44/CLK_OUT2)
unnamed: J1.6, U2.13 (GPIO19/U1RTS/ADC2_CH8/CLK_OUT2/USB_D-)
unnamed: J1.7, U2.14 (GPIO20/U1CTS/ADC2_CH9/CLK_OUT1/USB_D+)
unnamed: R2.2, SW100.2 (B), U2.27 (GPIO0/BOOT)
unnamed: R5.2, SW101.2 (B), U2.3 (EN)
sig1: J1.3, U2.35 (MTMS/GPIO42)
sig2: J1.4, U2.34 (MTDI/GPIO41/CLK_OUT1)
sig3: J1.5, U2.33 (MTDO/GPIO40/CLK_OUT2)

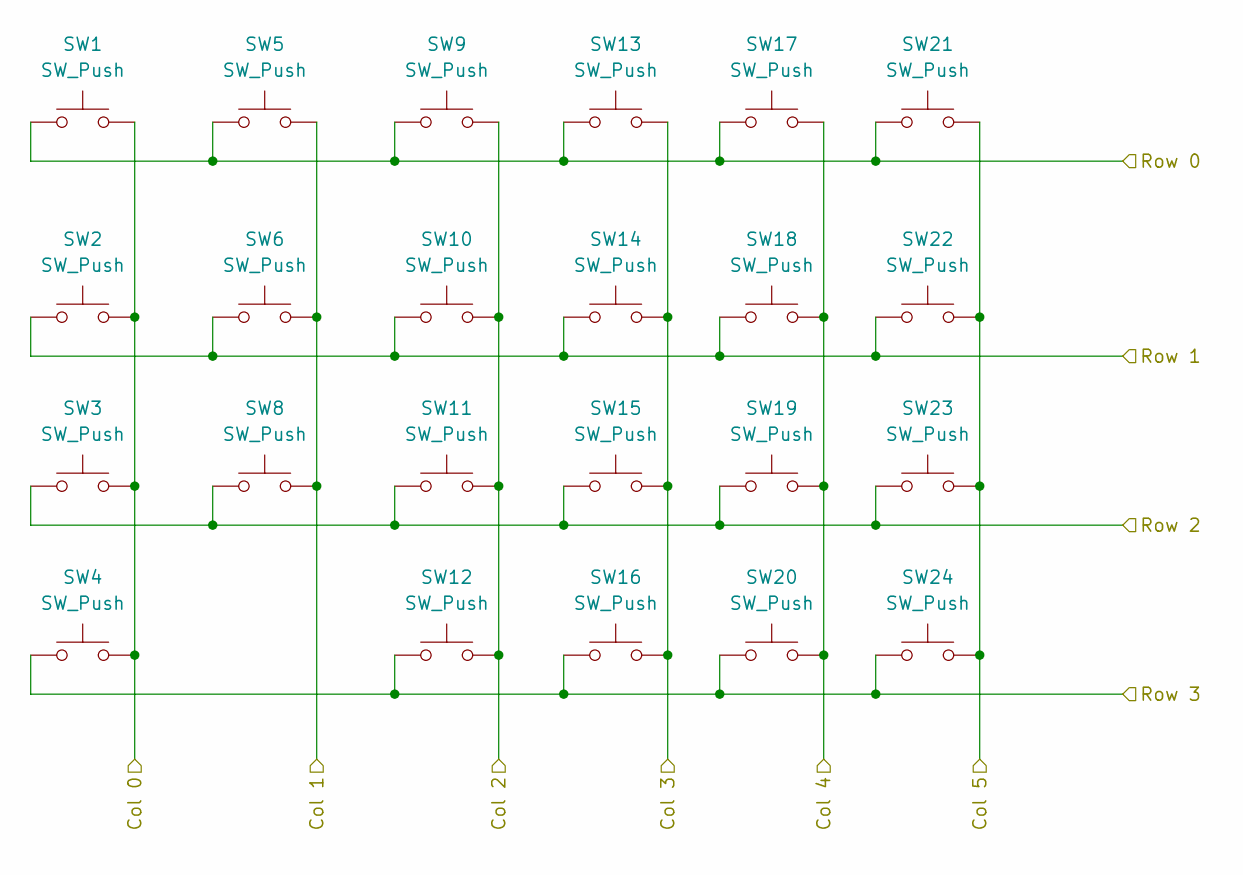
[picture p128: schematic touch_array.kicad_sch]

Parts:
SW1, SW2, SW3, SW4, SW9, SW10, SW11, SW12, SW13, SW14, SW15, SW16, SW17, SW18, SW19, SW20, SW21, SW22, SW23, SW24: SW_Push; Cap_Touch_Pad
SW5, SW8: SW_Push; cap_touch_triangle
SW6: SW_Push; Cap_Touch_Pad_big

Connections:
/Touch array/Col 0: SW1.2, SW2.2, SW3.2, SW4.2; also elsewhere on the board
/Touch array/Col 1: SW5.2, SW6.2, SW8.2; also elsewhere on the board
/Touch array/Col 2: SW9.2, SW10.2, SW11.2, SW12.2; also elsewhere on the board
/Touch array/Col 3: SW13.2, SW14.2, SW15.2, SW16.2; also elsewhere on the board
/Touch array/Col 4: SW17.2, SW18.2, SW19.2, SW20.2; also elsewhere on the board
/Touch array/Col 5: SW21.2, SW22.2, SW23.2, SW24.2; also elsewhere on the board
/Touch array/Row 0: SW1.1, SW5.1, SW9.1, SW13.1, SW17.1, SW21.1; also elsewhere on the board
/Touch array/Row 1: SW2.1, SW6.1, SW10.1, SW14.1, SW18.1, SW22.1; also elsewhere on the board
/Touch array/Row 2: SW3.1, SW8.1, SW11.1, SW15.1, SW19.1, SW23.1; also elsewhere on the board
/Touch array/Row 3: SW4.1, SW12.1, SW16.1, SW20.1, SW24.1; also elsewhere on the board

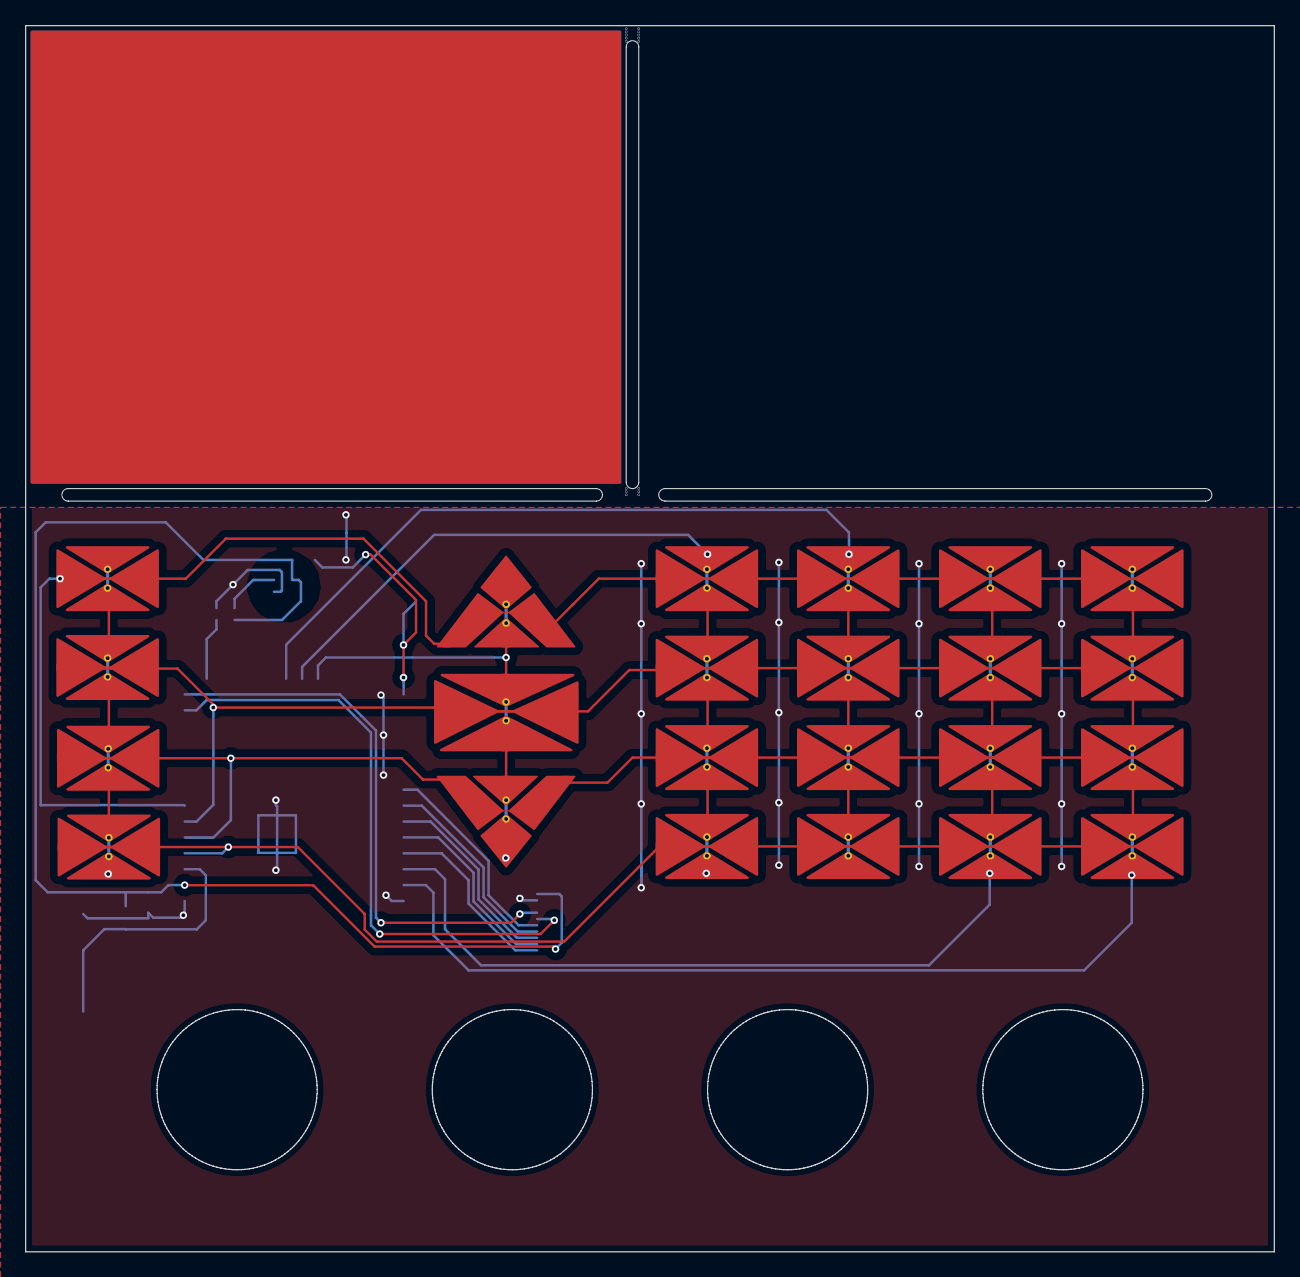
[picture p129: board front_panel.kicad_pcb from above]

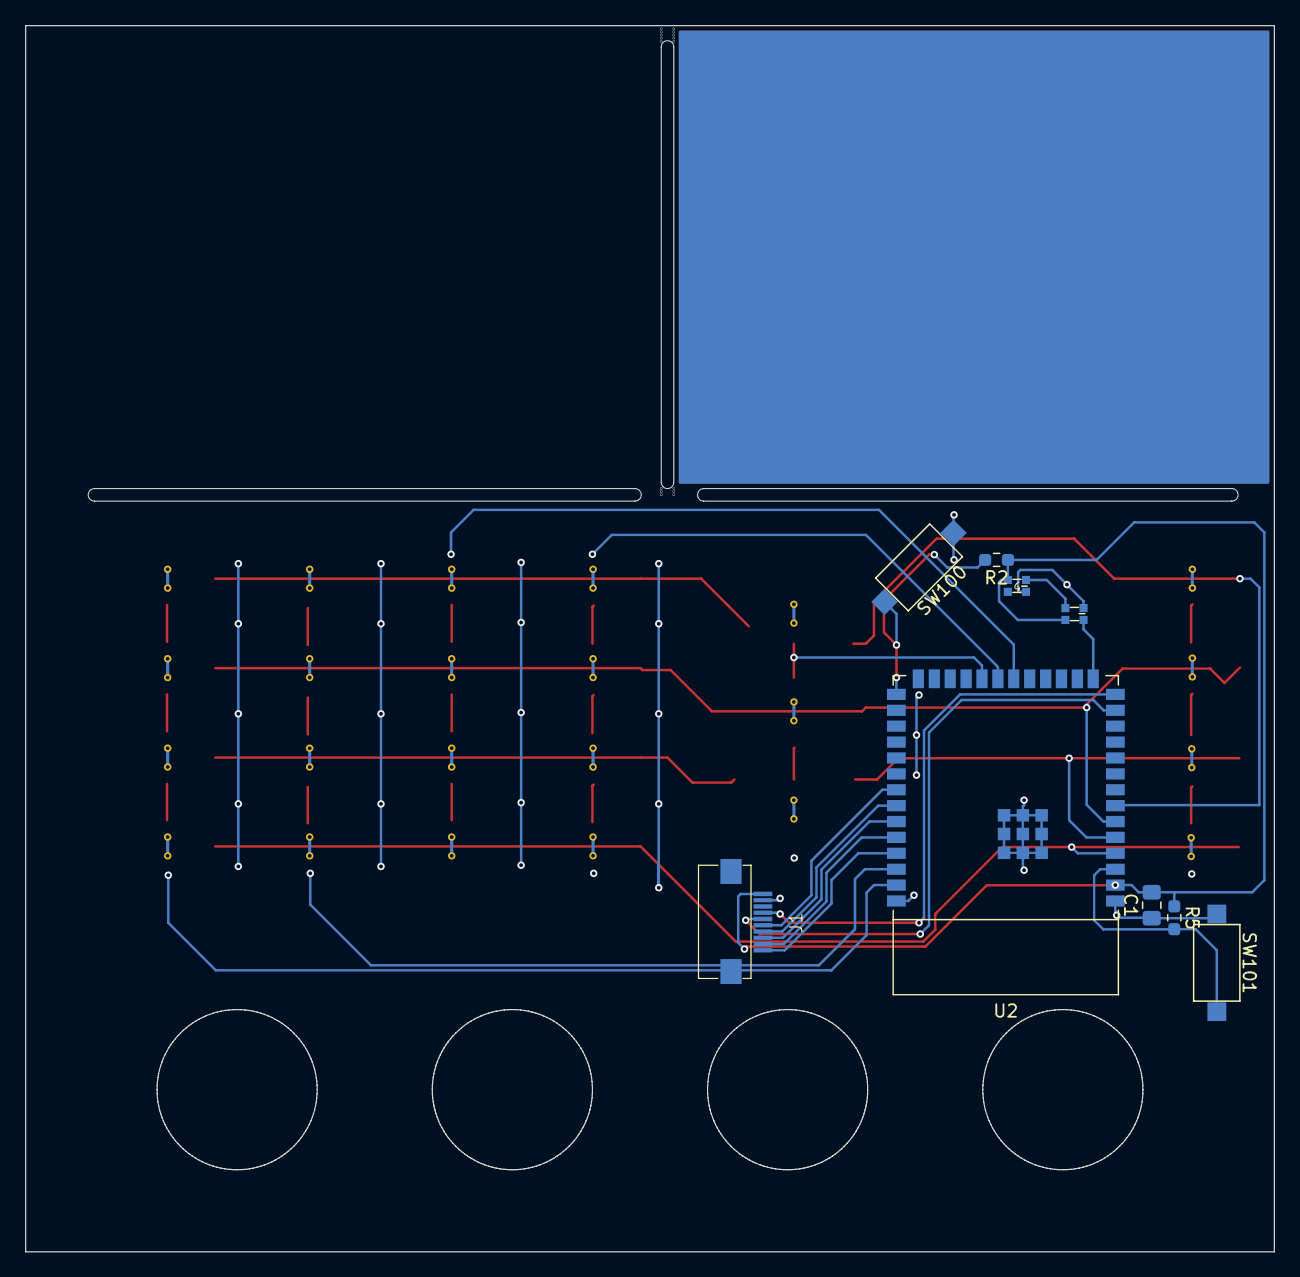
[picture p130: board front_panel.kicad_pcb from below]

Board: 2 copper layers, 99.8 x 98.0 mm, 32 parts (9 on the bottom side), 23 nets.
