degesz/LATEX_Bakalarka/Test_board_BAKALARKA/test_board.kicad_pcb

## KiCad design Test_board_BAKALARKA/test_board.kicad_pcb (2026-01-17)

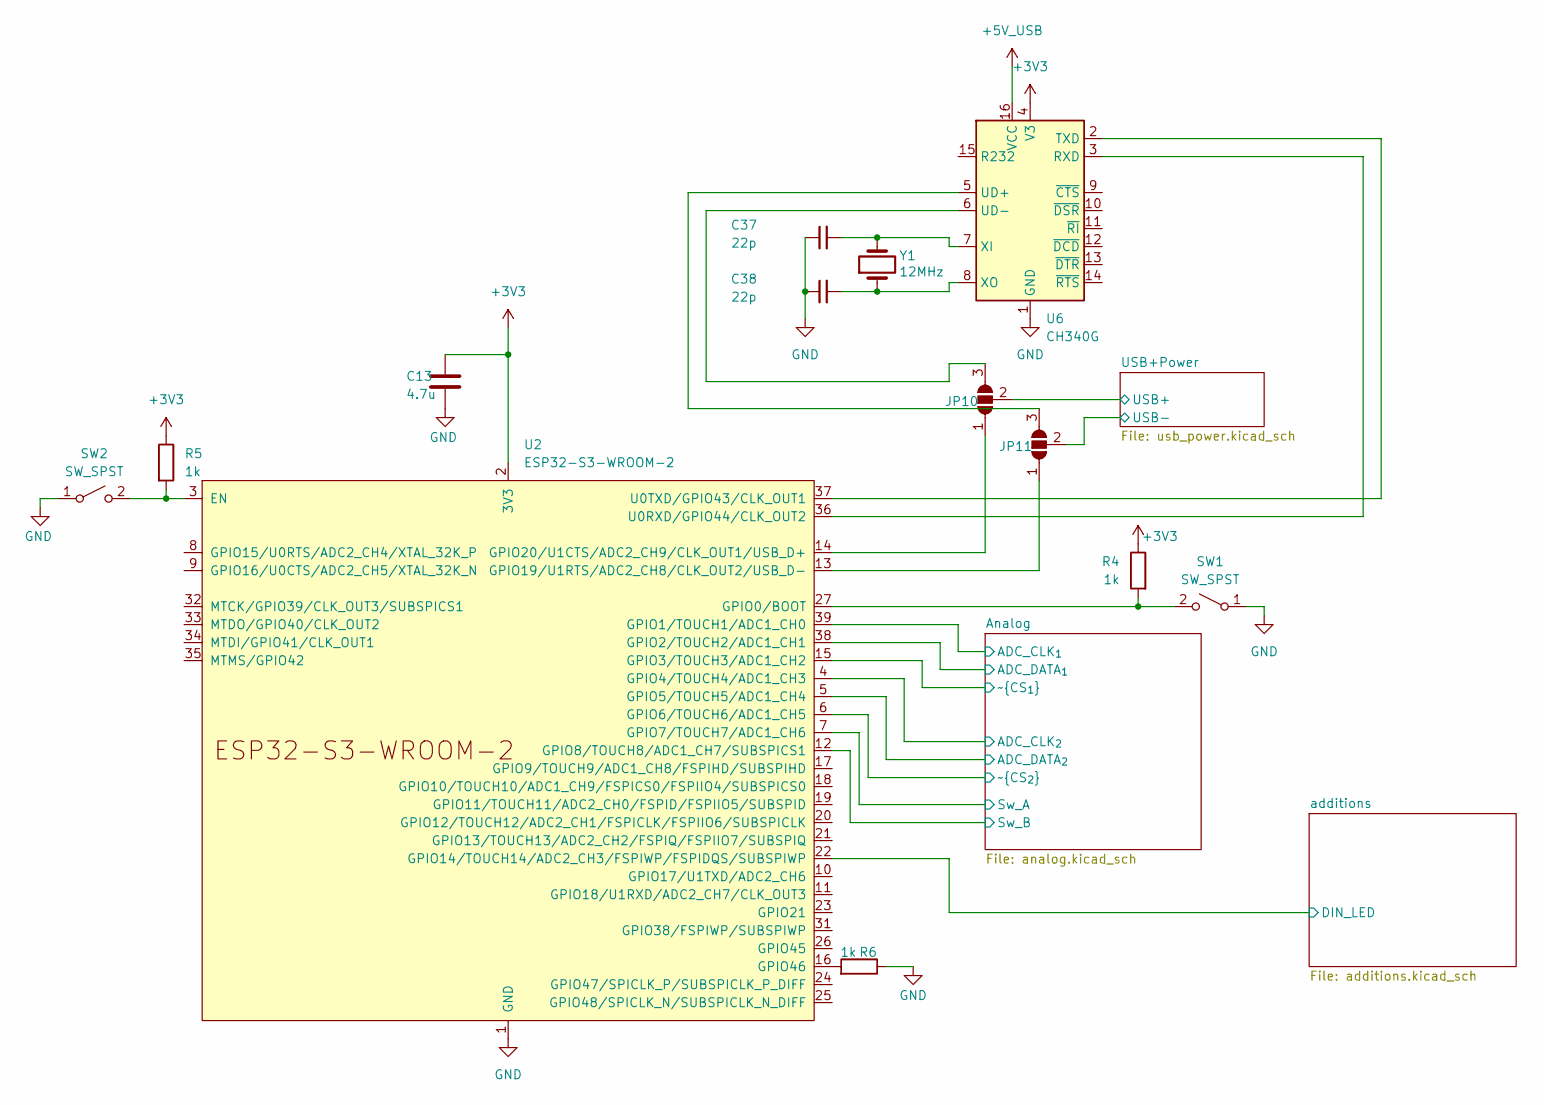
[picture p131: schematic test_board.kicad_sch, LCR metr - testovací deska]

Parts:
C13: 4.7u; C_0805_2012Metric_Pad1.18x1.45mm_HandSolder
C37, C38: 22p; C_0603_1608Metric_Pad1.08x0.95mm_HandSolder
JP10, JP11: SolderJumper_3_Open; SolderJumper-3_P1.3mm_Open_RoundedPad1.0x1.5mm
R4, R5, R6: 1k; R_0603_1608Metric_Pad0.98x0.95mm_HandSolder
SW1, SW2: SW_SPST; SW_SPST_CK_RS282G05A3
U2: ESP32-S3-WROOM-2
U6: CH340G; SOIC-16_3.9x9.9mm_P1.27mm
Y1: 12MHz; Crystal_SMD_HC49-SD_HandSoldering

Connections:
+3V3: C13.1, R4.1, R5.1, U2.2 (3V3), U6.4 (V3); also elsewhere on the board
+5V_USB: U6.16 (VCC); also elsewhere on the board
/Analog/ADC_CLK_{1}: U2.39 (GPIO1/TOUCH1/ADC1_CH0); also elsewhere on the board
/Analog/ADC_CLK_{2}: U2.4 (GPIO4/TOUCH4/ADC1_CH3); also elsewhere on the board
/Analog/ADC_DATA_{1}: U2.38 (GPIO2/TOUCH2/ADC1_CH1); also elsewhere on the board
/Analog/ADC_DATA_{2}: U2.5 (GPIO5/TOUCH5/ADC1_CH4); also elsewhere on the board
/Analog/Sw_A: U2.7 (GPIO7/TOUCH7/ADC1_CH6); also elsewhere on the board
/Analog/Sw_B: U2.12 (GPIO8/TOUCH8/ADC1_CH7/SUBSPICS1); also elsewhere on the board
/Analog/~CS_{1}: U2.15 (GPIO3/TOUCH3/ADC1_CH2); also elsewhere on the board
/Analog/~CS_{2}: U2.6 (GPIO6/TOUCH6/ADC1_CH5); also elsewhere on the board
/USB+Power/USB+: JP10.2 (C); also elsewhere on the board
/USB+Power/USB-: JP11.2 (C); also elsewhere on the board
/additions/DIN_LED: U2.22 (GPIO14/TOUCH14/ADC2_CH3/FSPIWP/FSPIDQS/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); also elsewhere on the board
GND: C13.2, C37.1, C38.1, R6.1, SW1.1 (A), SW2.1 (A), U2.1 (GND), U2.40 (GND), U2.41 (GND), U6.1 (GND); also elsewhere on the board
unnamed: JP10.1 (A), U2.14 (GPIO20/U1CTS/ADC2_CH9/CLK_OUT1/USB_D+)
unnamed: JP10.3 (B), U6.6 (UD-)
unnamed: JP11.1 (A), U2.13 (GPIO19/U1RTS/ADC2_CH8/CLK_OUT2/USB_D-)
unnamed: JP11.3 (B), U6.5 (UD+)
unnamed: R4.2, SW1.2 (B), U2.27 (GPIO0/BOOT)
unnamed: R5.2, SW2.2 (B), U2.3 (EN)
unnamed: R6.2, U2.16 (GPIO46)
unnamed: U2.36 (U0RXD/GPIO44/CLK_OUT2), U6.3 (RXD)
unnamed: U2.37 (U0TXD/GPIO43/CLK_OUT1), U6.2 (TXD)
unnamed: C37.2, U6.7 (XI), Y1.2
unnamed: C38.2, U6.8 (XO), Y1.1
