degesz/LATEX_Bakalarka/Test_board_BAKALARKA/test_board.kicad_pcb

## KiCad design Test_board_BAKALARKA/test_board.kicad_pcb (continued)

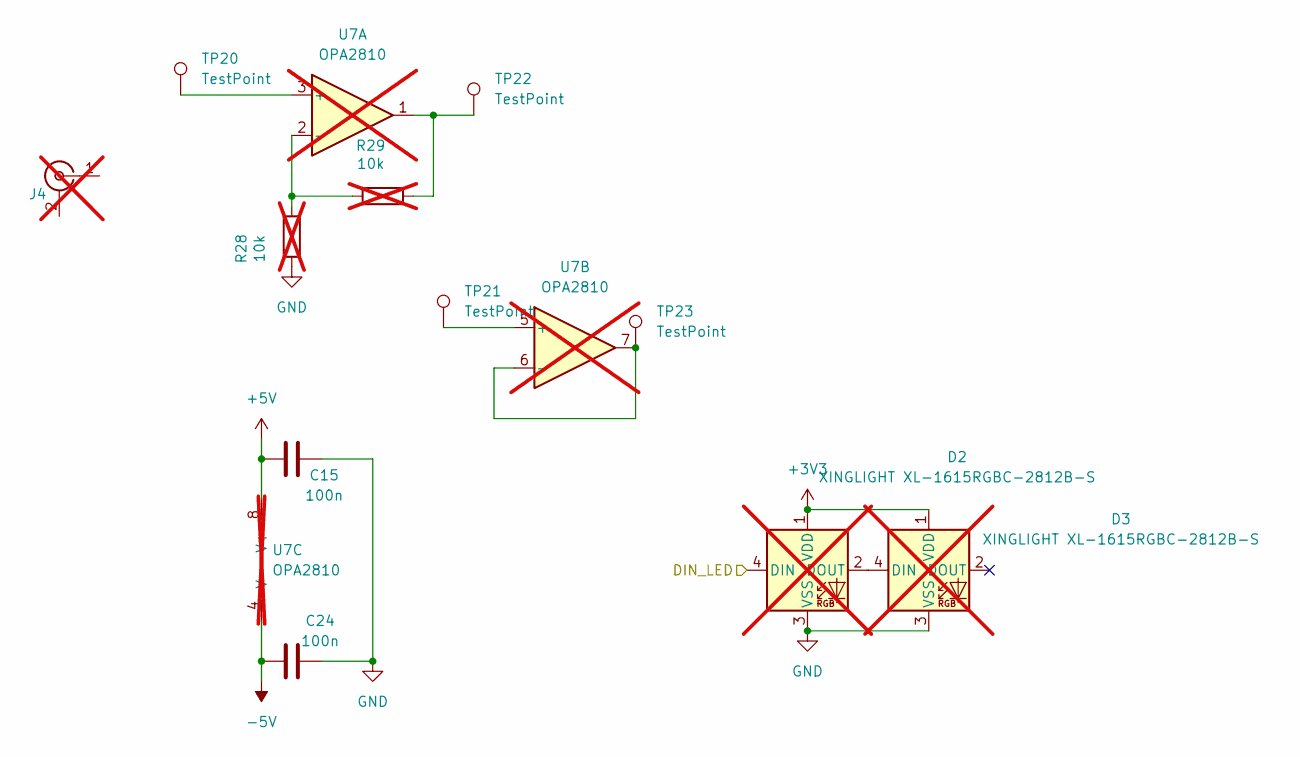
[picture p132: schematic additions.kicad_sch]

Parts:
C15, C24: 100n; C_0603_1608Metric_Pad1.08x0.95mm_HandSolder
D2, D3: XINGLIGHT XL-1615RGBC-2812B-S; not fitted
J4: Conn_Coaxial; BNC_Gold; not fitted
R28, R29: 10k; R_0603_1608Metric_Pad0.98x0.95mm_HandSolder; not fitted
TP20, TP21, TP22, TP23: TestPoint; Pin_D1.0mm_L10.0mm
U7: OPA2810; SOIC-8_3.9x4.9mm_P1.27mm; not fitted

Connections:
+3V3: D2.1 (VDD), D3.1 (VDD); also elsewhere on the board
+5V: C15.2, U7.8 (V+); also elsewhere on the board
-5V: C24.2, U7.4 (V-); also elsewhere on the board
/additions/DIN_LED: D2.4 (DIN); also elsewhere on the board
GND: C15.1, C24.1, D2.3 (VSS), D3.3 (VSS), R28.1; also elsewhere on the board
unnamed: D2.2 (DOUT), D3.4 (DIN)
unnamed: R29.2, TP22.1, U7.1
unnamed: TP20.1, U7.3 (+)
unnamed: R28.2, R29.1, U7.2 (-)
unnamed: TP21.1, U7.5 (+)
unnamed: TP23.1, U7.6 (-), U7.7

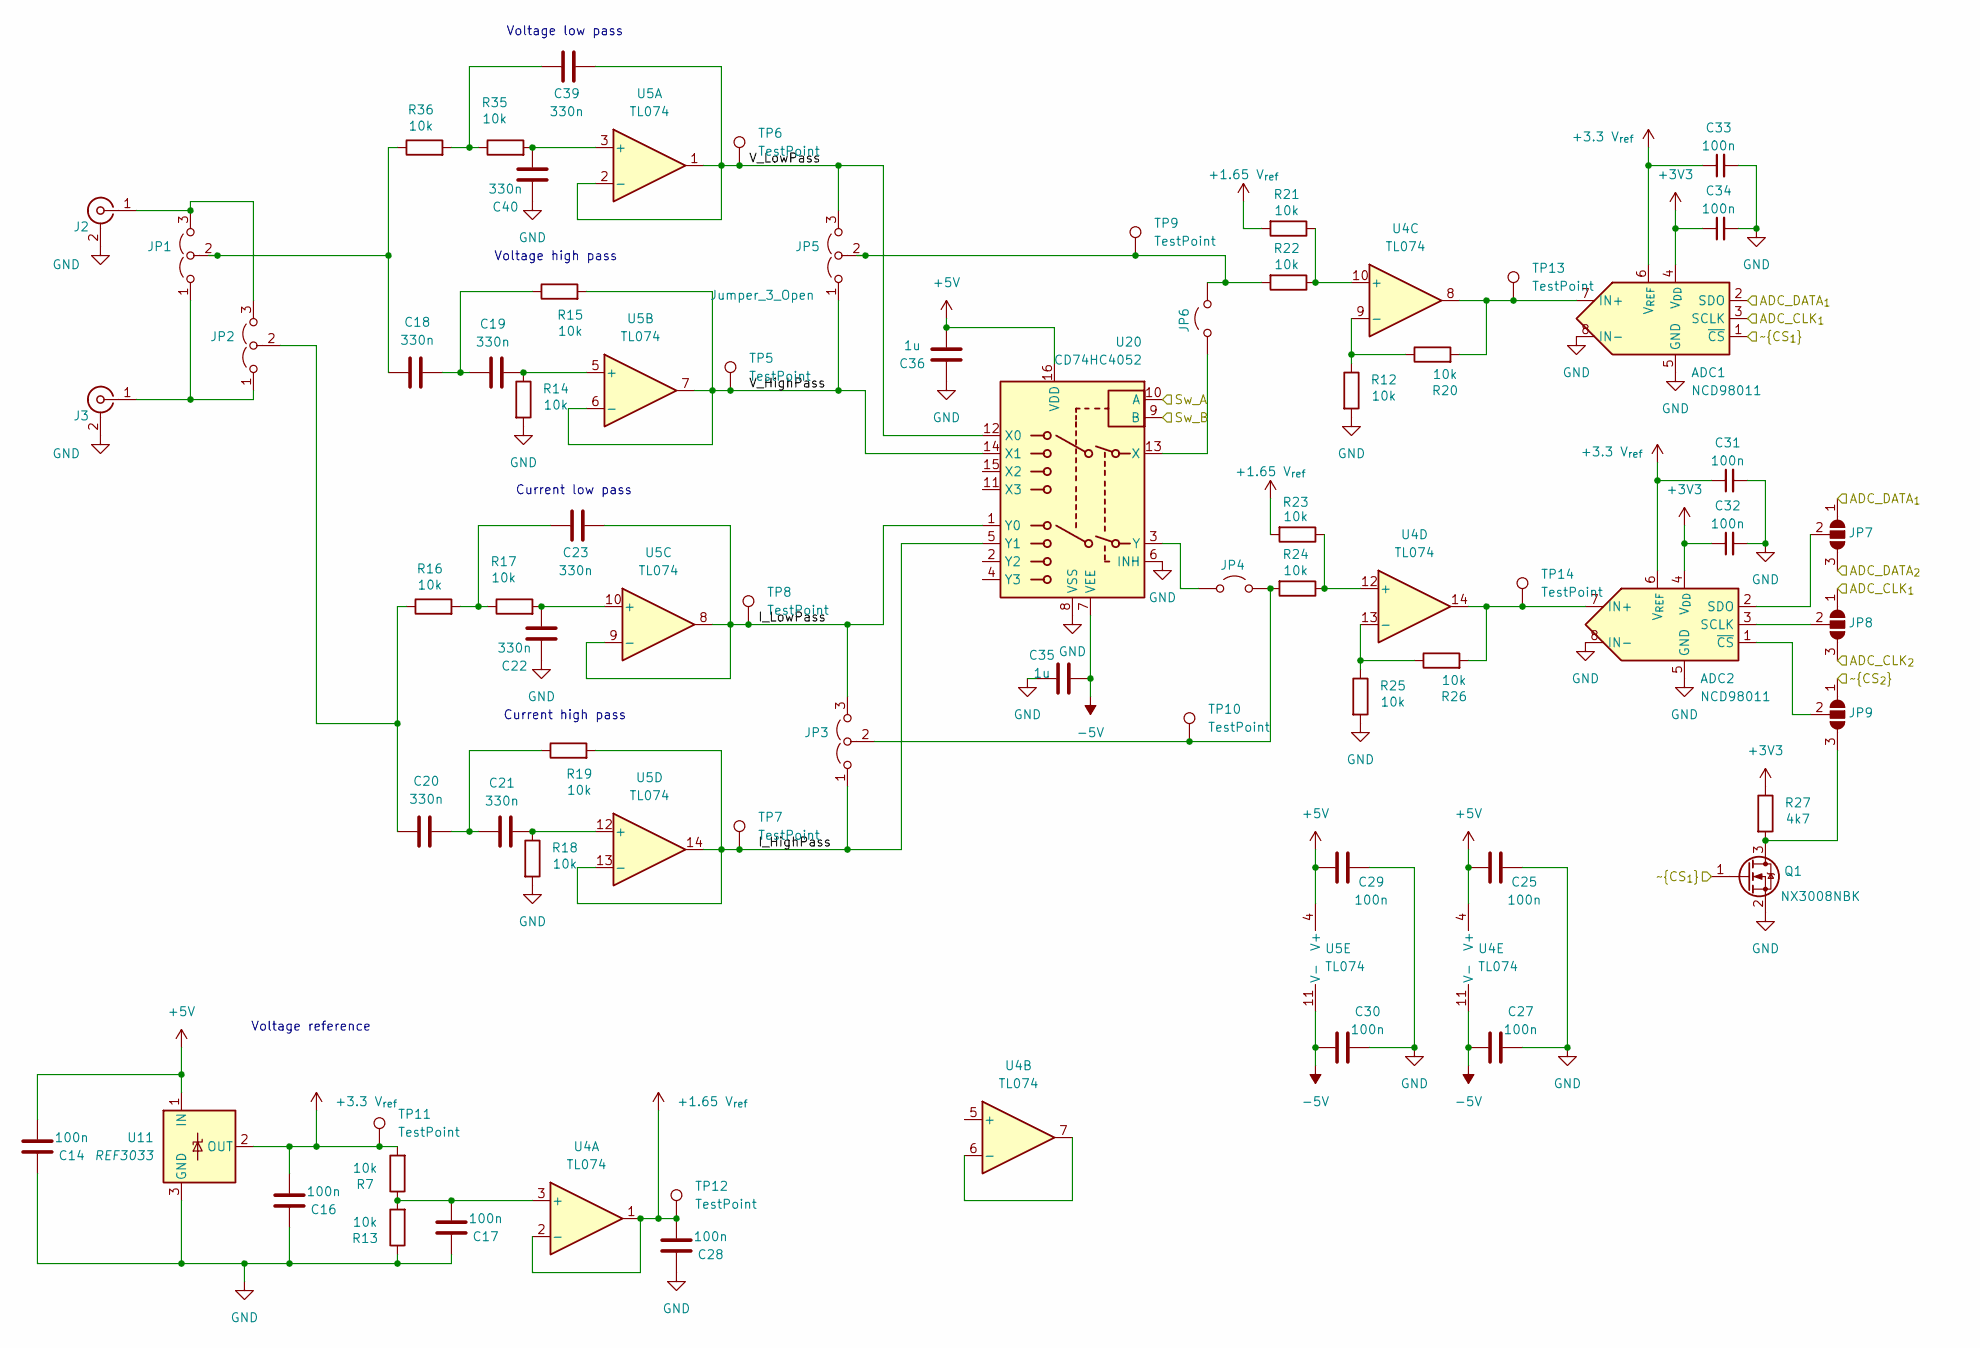
[picture p133: schematic analog.kicad_sch]

Parts:
ADC1, ADC2: NCD98011; Texas_UQFN-8_1.5x1.5mm_P0.5mm
C14, C16, C17, C25, C27, C28, C29, C30, C31, C32, C33, C34: 100n; C_0603_1608Metric_Pad1.08x0.95mm_HandSolder
C18, C19, C20, C21, C22, C23, C39, C40: 330n; C_0603_1608Metric_Pad1.08x0.95mm_HandSolder
C35, C36: 1u; C_0603_1608Metric_Pad1.08x0.95mm_HandSolder
J2, J3: Conn_Coaxial; BNC_Amphenol_B6252HB-NPP3G-50_Horizontal
JP1, JP2, JP3, JP5: Jumper_3_Open; PinHeader_1x03_P2.54mm_Vertical
JP4, JP6: Jumper_2_Open; PinHeader_1x02_P2.54mm_Vertical
JP7, JP8, JP9: SolderJumper_3_Open; SolderJumper-3_P1.3mm_Open_RoundedPad1.0x1.5mm
Q1: NX3008NBK; SOT-323_SC-70_Handsoldering
R7, R12, R13, R14, R15, R16, R17, R18, R19, R20, R21, R22, R23, R24, R25, R26, R35, R36: 10k; R_0603_1608Metric_Pad0.98x0.95mm_HandSolder
R27: 4k7; R_0603_1608Metric_Pad0.98x0.95mm_HandSolder
TP5, TP6, TP7, TP8, TP9, TP10, TP11, TP12, TP13, TP14: TestPoint; Pin_D1.0mm_L10.0mm
U4, U5: TL074; TSSOP-14_4.4x5mm_P0.65mm
U11: REF3033; SOT-23
U20: CD74HC4052; TSSOP-16_4.4x5mm_P0.65mm

Connections:
+1.65 V_{ref}: C28.2, R21.2, R23.2, TP12.1, U4.1, U4.2 (-)
+3.3 V_{ref}: ADC1.6 (V_{REF}), ADC2.6 (V_{REF}), C16.2, C31.1, C33.1, R7.2, TP11.1, U11.2 (OUT)
+3V3: ADC1.4 (V_{DD}), ADC2.4 (V_{DD}), C32.1, C34.1, R27.1; also elsewhere on the board
+5V: C14.2, C25.2, C29.2, C36.2, U4.4 (V+), U5.4 (V+), U11.1 (IN), U20.16 (VDD); also elsewhere on the board
-5V: C27.2, C30.2, C35.2, U4.11 (V-), U5.11 (V-), U20.7 (VEE); also elsewhere on the board
/Analog/ADC_CLK_{1}: ADC1.3 (SCLK), JP8.1 (A); also elsewhere on the board
/Analog/ADC_CLK_{2}: JP8.3 (B); also elsewhere on the board
/Analog/ADC_DATA_{1}: ADC1.2 (SDO), JP7.1 (A); also elsewhere on the board
/Analog/ADC_DATA_{2}: JP7.3 (B); also elsewhere on the board
/Analog/I_HighPass: JP3.1 (A), R19.2, TP7.1, U5.13 (-), U5.14, U20.5 (Y1)
/Analog/I_LowPass: C23.1, JP3.3 (B), TP8.1, U5.8, U5.9 (-), U20.1 (Y0)
/Analog/Sw_A: U20.10 (A); also elsewhere on the board
/Analog/Sw_B: U20.9 (B); also elsewhere on the board
/Analog/V_HighPass: JP5.1 (A), R15.2, TP5.1, U5.6 (-), U5.7, U20.14 (X1)
/Analog/V_LowPass: C39.1, JP5.3 (B), TP6.1, U5.1, U5.2 (-), U20.12 (X0)
/Analog/~CS_{1}: ADC1.1 (~CS), Q1.1 (G); also elsewhere on the board
/Analog/~CS_{2}: JP9.1 (A); also elsewhere on the board
GND: ADC1.5 (GND), ADC1.8 (IN-), ADC2.5 (GND), ADC2.8 (IN-), C14.1, C16.1, C17.1, C22.2, C25.1, C27.1, C28.1, C29.1, C30.1, C31.2, C32.2, C33.2, C34.2, C35.1, C36.1, C40.2, J2.2 (Ext), J3.2 (Ext), Q1.2 (S), R12.2, R13.1, R14.2, R18.2, R25.2, U11.3 (GND), U20.6 (INH), U20.8 (VSS); also elsewhere on the board
unnamed: ADC1.7 (IN+), R20.2, TP13.1, U4.8
unnamed: ADC2.7 (IN+), R26.2, TP14.1, U4.14
unnamed: ADC2.3 (SCLK), JP8.2 (C)
unnamed: ADC2.2 (SDO), JP7.2 (C)
unnamed: ADC2.1 (~CS), JP9.2 (C)
unnamed: C18.1, C19.2, R15.1
unnamed: C20.1, C21.2, R19.1
unnamed: C23.2, R16.2, R17.1
unnamed: C39.2, R35.1, R36.2
unnamed: J2.1 (In), JP1.3 (B), JP2.3 (B)
unnamed: J3.1 (In), JP1.1 (A), JP2.1 (A)
unnamed: C18.2, JP1.2 (C), R36.1
unnamed: C20.2, JP2.2 (C), R16.1
unnamed: JP3.2 (C), JP4.2 (B), R24.2, TP10.1
unnamed: JP4.1 (A), U20.3 (Y)
unnamed: JP5.2 (C), JP6.2 (B), R22.2, TP9.1
unnamed: JP6.1 (A), U20.13 (X)
unnamed: JP9.3 (B), Q1.3 (D), R27.2
unnamed: C17.2, R7.1, R13.2, U4.3 (+)
unnamed: U4.6 (-), U4.7
unnamed: R21.1, R22.1, U4.10 (+)
unnamed: R12.1, R20.1, U4.9 (-)
unnamed: R23.1, R24.1, U4.12 (+)
unnamed: R25.1, R26.1, U4.13 (-)
unnamed: C40.1, R35.2, U5.3 (+)
unnamed: C19.1, R14.1, U5.5 (+)
unnamed: C22.1, R17.2, U5.10 (+)
unnamed: C21.1, R18.1, U5.12 (+)

Notes on the sheet:
Current high pass
Current low pass
Voltage low pass
Voltage reference
Voltage high pass

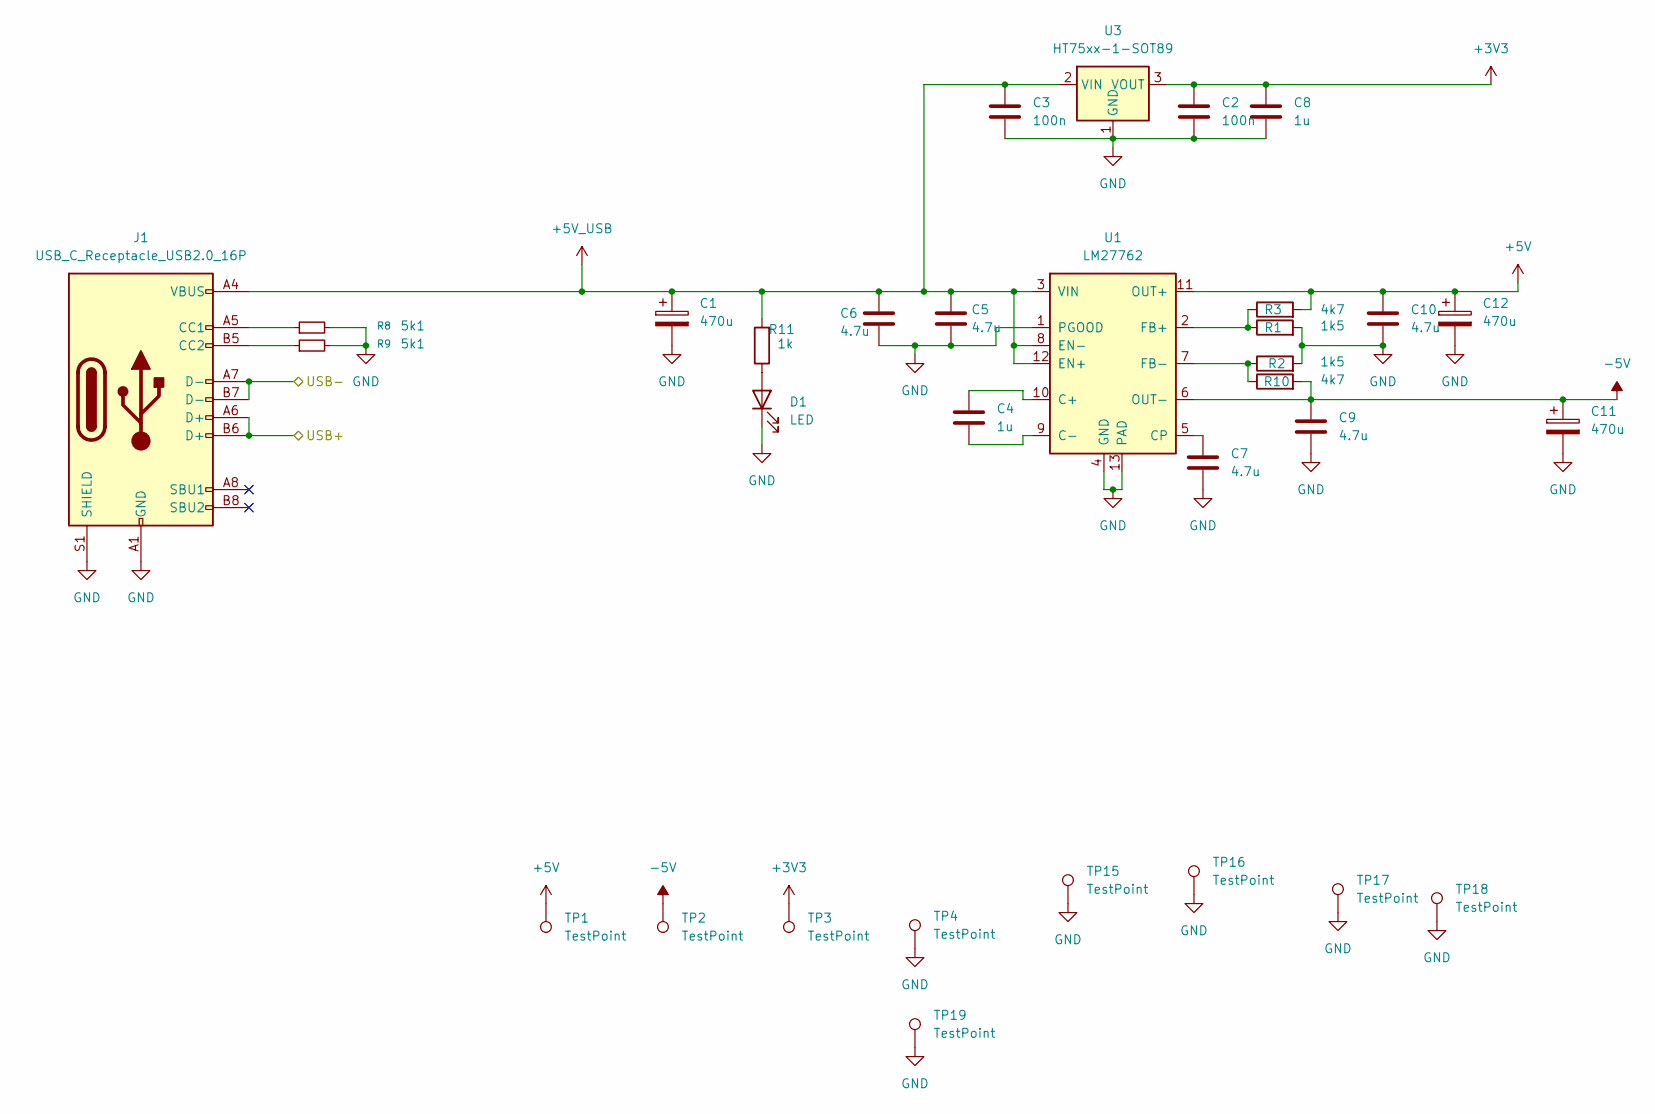
[picture p134: schematic usb_power.kicad_sch]

Parts:
C1, C11, C12: 470u; CP_Radial_D8.0mm_P3.80mm
C2, C3: 100n; C_0603_1608Metric_Pad1.08x0.95mm_HandSolder
C4: 1u; R_0603_1608Metric_Pad0.98x0.95mm_HandSolder
C5, C6, C7, C9, C10: 4.7u; C_0805_2012Metric_Pad1.18x1.45mm_HandSolder
C8: 1u; C_0603_1608Metric_Pad1.08x0.95mm_HandSolder
D1: LED; LED_miniPLCC_2315_Handsoldering
J1: USB_C_Receptacle_USB2.0_16P; USB_C_Receptacle_GCT_USB4105-xx-A_16P_TopMnt_Horizontal
R1, R2: 1k5; R_0603_1608Metric_Pad0.98x0.95mm_HandSolder
R3, R10: 4k7; R_0603_1608Metric_Pad0.98x0.95mm_HandSolder
R8, R9: 5k1; R_0603_1608Metric_Pad0.98x0.95mm_HandSolder
R11: 1k; R_0603_1608Metric_Pad0.98x0.95mm_HandSolder
TP1, TP2, TP3, TP4, TP15, TP16, TP17, TP18, TP19: TestPoint; Pin_D1.3mm_L11.0mm_LooseFit
U1: LM27762; WSON-12-1EP_3x2mm_P0.5mm_EP1x2.65_ThermalVias
U3: HT75xx-1-SOT89; SOT-89-3_Handsoldering

Connections:
+3V3: C2.1, C8.1, TP3.1, U3.3 (VOUT); also elsewhere on the board
+5V: C10.1, C12.1, R3.2, TP1.1, U1.11 (OUT+); also elsewhere on the board
+5V_USB: C1.1, C3.1, C5.1, C6.1, J1.A4 (VBUS), J1.A9 (VBUS), J1.B4 (VBUS), J1.B9 (VBUS), R11.2, U1.3 (VIN), U1.8 (EN-), U1.12 (EN+), U3.2 (VIN); also elsewhere on the board
-5V: C9.1, C11.1, R10.2, TP2.1, U1.6 (OUT-); also elsewhere on the board
/USB+Power/USB+: J1.A6 (D+), J1.B6 (D+); also elsewhere on the board
/USB+Power/USB-: J1.A7 (D-), J1.B7 (D-); also elsewhere on the board
GND: C1.2, C2.2, C3.2, C5.2, C6.2, C7.2, C8.2, C9.2, C10.2, C11.2, C12.2, D1.1 (K), J1.A1 (GND), J1.A12 (GND), J1.B1 (GND), J1.B12 (GND), J1.S1 (SHIELD), R1.2, R2.2, R8.2, R9.2, TP4.1, TP15.1, TP16.1, TP17.1, TP18.1, TP19.1, U1.1 (PGOOD), U1.4 (GND), U1.13 (PAD), U3.1 (GND); also elsewhere on the board
unnamed: D1.2 (A), R11.1
unnamed: J1.A5 (CC1), R8.1
unnamed: J1.B5 (CC2), R9.1
unnamed: C4.1, U1.10 (C+)
unnamed: C4.2, U1.9 (C-)
unnamed: C7.1, U1.5 (CP)
unnamed: R1.1, R3.1, U1.2 (FB+)
unnamed: R2.1, R10.1, U1.7 (FB-)

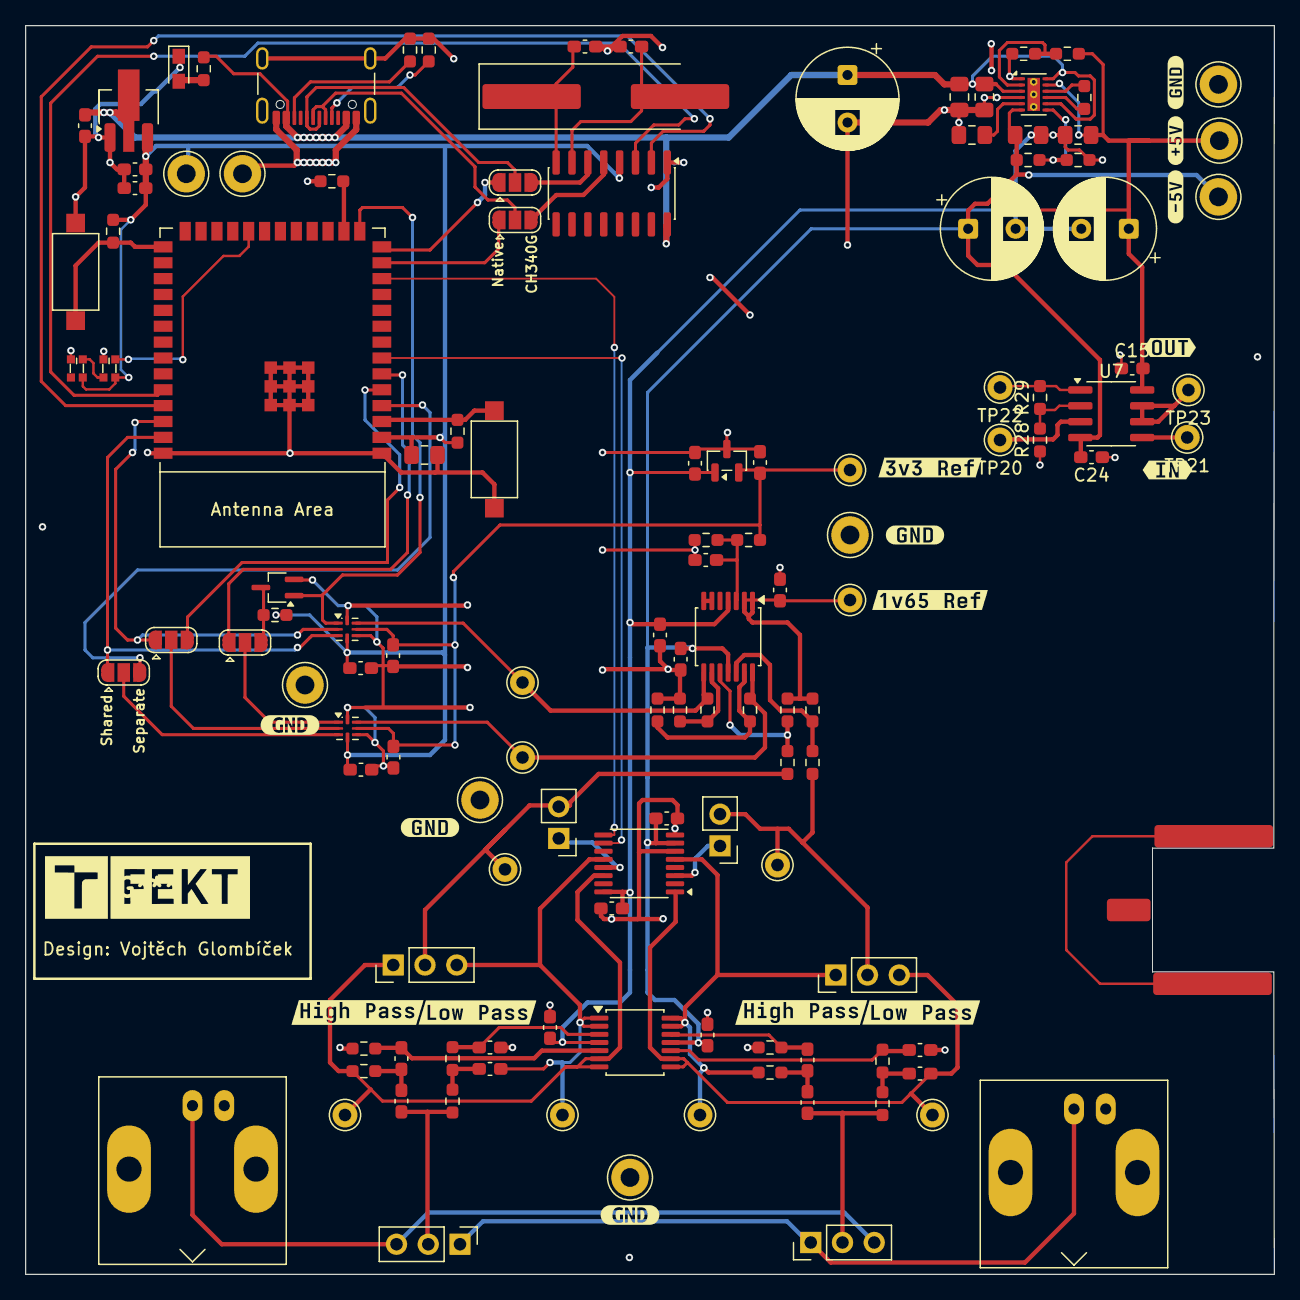
[picture p135: board test_board.kicad_pcb from above]

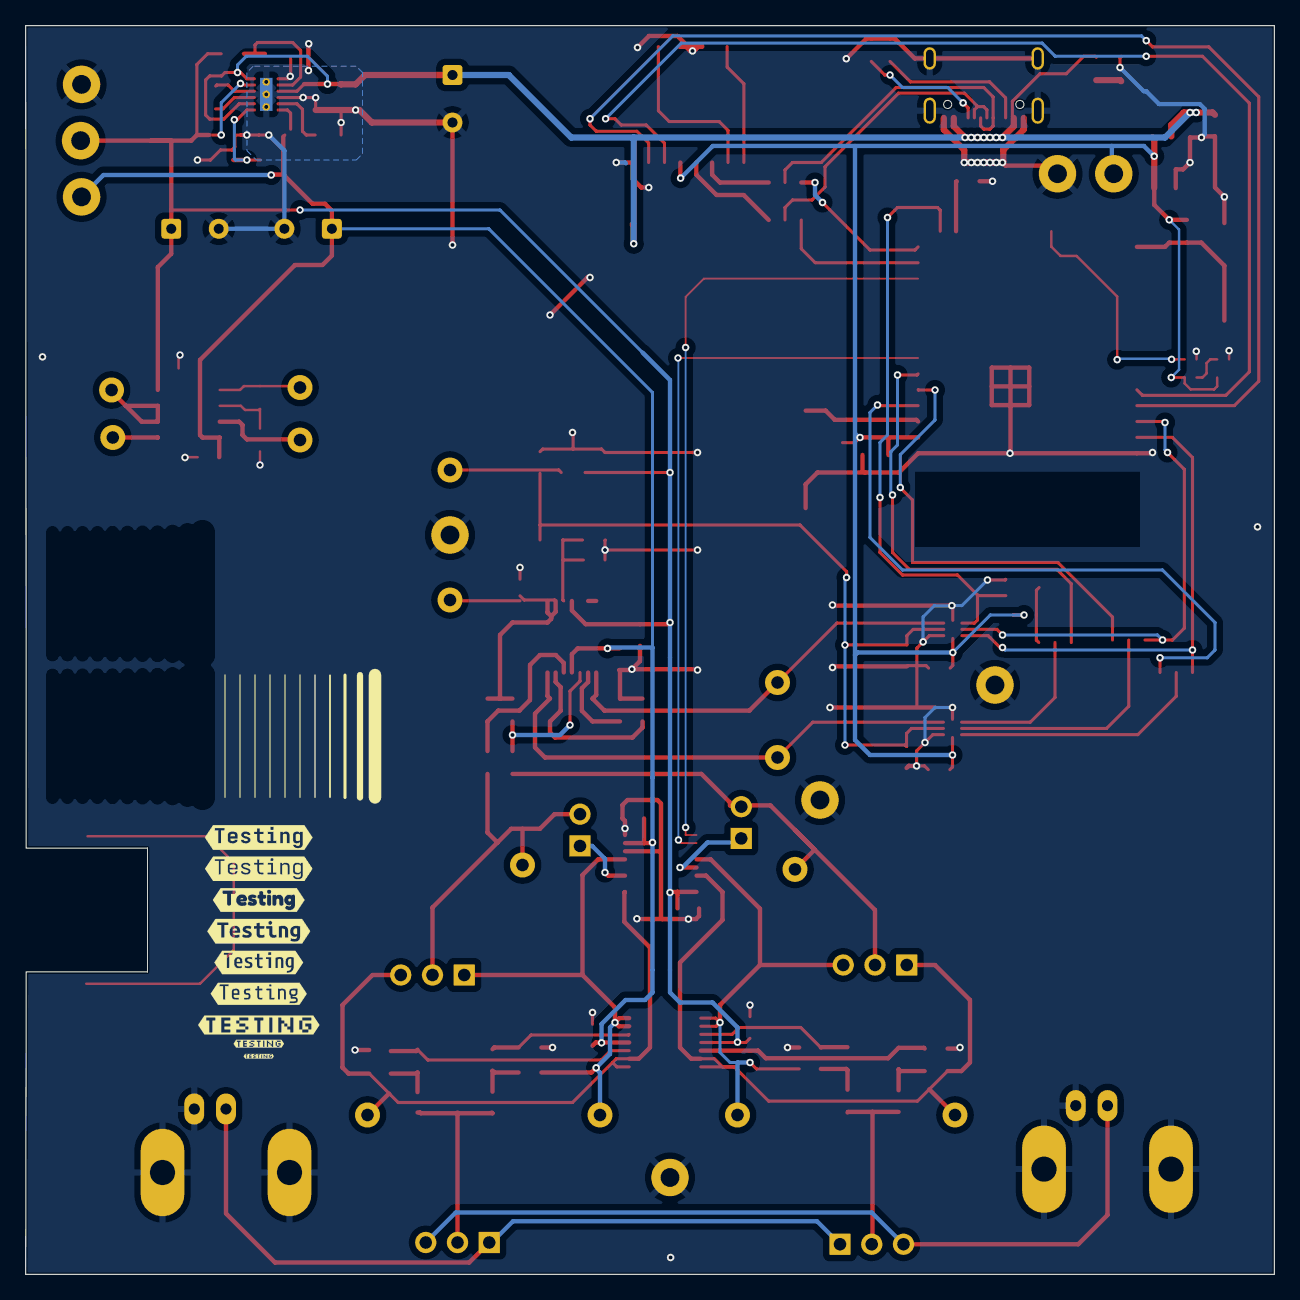
[picture p136: board test_board.kicad_pcb from below]

Board: 2 copper layers, 99.9 x 99.9 mm, 150 parts (10 on the bottom side), 75 nets.

Other parts of the board:
kibuzzard-69665B05: G***; kibuzzard-69665B05
kibuzzard-69665B09: G***; kibuzzard-69665B09
kibuzzard-69665B11: G***; kibuzzard-69665B11
kibuzzard-696656D5: G***; kibuzzard-696656D5
kibuzzard-696656FC: G***; kibuzzard-696656FC
kibuzzard-696658C9: G***; kibuzzard-696658C9
kibuzzard-696658E8: G***; kibuzzard-696658E8
kibuzzard-696658F1: G***; kibuzzard-696658F1
kibuzzard-696658F7: G***; kibuzzard-696658F7
kibuzzard-696658FF: G***; kibuzzard-696658FF
kibuzzard-6958001D, kibuzzard-6958001D#2: G***; kibuzzard-6958001D
kibuzzard-6966571E: G***; kibuzzard-6966571E
kibuzzard-6966573E: G***; kibuzzard-6966573E
kibuzzard-6966592B: G***; kibuzzard-6966592B
kibuzzard-6966594C: G***; kibuzzard-6966594C
kibuzzard-69665706: G***; kibuzzard-69665706
kibuzzard-69665710: G***; kibuzzard-69665710
kibuzzard-69665718: G***; kibuzzard-69665718
kibuzzard-69665729: G***; kibuzzard-69665729
kibuzzard-69665736: G***; kibuzzard-69665736
kibuzzard-69665743: G***; kibuzzard-69665743
kibuzzard-69665908: G***; kibuzzard-69665908
kibuzzard-69665967: G***; kibuzzard-69665967
