degesz/LATEX_Bakalarka/(commit log)

2025-11-26 moving one folder up
    [i_v_conv.kicad_sch, resonant.kicad_sch, schemata.kicad_pcb, schemata.kicad_sch, wheatstone.kicad_sch]
2025-12-03 prace na test board schem
    [analog.kicad_sch, schemata.kicad_pcb, test_board.kicad_pcb, test_board.kicad_sch, usb_power.kicad_sch]
2025-12-08 pridani textu peak detect, xor phase, signal source
    [XOR_phase.kicad_sch, analog.kicad_sch, peak_detect.kicad_sch, schemata.kicad_sch, test_board.kicad_pcb, test_board.kicad_sch]
2025-12-09 update rizeni amplitudy
    [amplitude.kicad_sch, schemata.kicad_sch]
2025-12-21 pridane nastaveni dc offsetu do zdroje a neco ke vzorkovani
    [DC_offset.kicad_sch, XOR_phase.kicad_sch, amplitude.kicad_sch, i_v_conv.kicad_sch, peak_detect.kicad_sch, resonant.kicad_sch, schemata.kicad_sch, wheatstone.kicad_sch]
2025-12-27 work on lot of things
    [DC_offset.kicad_sch]
2025-12-29 prace na prototypu a tak
    [wheatstone.kicad_sch]
2026-01-01 pridani zaveru, opraveni chyb, a tak. prepnuti na onepage render
    [73100-0131.STEP, LCR_Meter - Díl29^LCR_Meter-1.STL, LCR_Meter.kicad_pcb, LCR_Meter.kicad_sch, LEDs.kicad_sch, PSU_USB.kicad_sch, RELAY8_J104D2C24VDC_15S_CRS.step, TactileButton(6x3,5mm)_SMD.stp]
2026-01-05 fix citace a uvod
    [73100-0131.STEP, DC_offset.kicad_sch, LCR_Meter - Díl29^LCR_Meter-1.STL, LCR_Meter.kicad_pcb, LCR_Meter.kicad_sch, LEDs.kicad_sch, PSU_USB.kicad_sch, RELAY8_J104D2C24VDC_15S_CRS.step]
2026-01-17 testboard frontpanel
    [front_panel.kicad_pcb, front_panel.kicad_sch, test_board.kicad_pcb]
2026-01-18 front panel and test board ordered
    [Drill_PTH_Through.DRL, Drill_PTH_Through_Via.DRL, Gerber_BoardOutlineLayer.GKO, Gerber_BottomLayer.GBL, Gerber_BottomPasteMaskLayer.GBP, Gerber_BottomSilkscreenLayer.GBO, Gerber_BottomSolderMaskLayer.GBS, Gerber_TopLayer.GTL]
2026-02-22 start work on 2nd 2nd_prototype_LCRmeter
    [73100-0131.STEP, ESP32-S2-SOLO-2.STEP, GY-511_LSM303DLHC.step, LEDs.kicad_sch, PSU_USB.kicad_sch, RELAY8_J104D2C24VDC_15S_CRS.step, TactileButton(6x3,5mm)_SMD.stp, V2_LCR_Meter.kicad_pcb]
2026-02-24 work on layout proto2
    [LEDs.kicad_sch, PSU_USB.kicad_sch, V2_LCR_Meter.kicad_pcb, V2_LCR_Meter.kicad_sch, frontend.kicad_sch, sig_source.kicad_sch, test1_bom.csv, test1_designators.csv]
2026-02-26 routing v2 work almost complete
    [V2_LCR_Meter.kicad_pcb, V2_LCR_Meter.kicad_sch, frontend.kicad_sch]
2026-03-05 finished with offset amps
    [LCR_Meter.kicad_pcb, V2_LCR_Meter.kicad_pcb, finaltest_bom.csv, finaltest_designators.csv, finaltest_positions.csv, frontend.kicad_sch]
2026-03-10 finished final final_2
    [V2_LCR_Meter.kicad_pcb, frontend.kicad_sch, sig_source.kicad_sch]
2026-04-02 somewhat working 2nd prototype
2026-04-05 somewhat working, memory issues
    [acquisition_engine.cpp, acquisition_engine.h, board_config.h, command_interface.cpp, command_interface.h, firmware_state.h, impedance_analyzer.cpp, impedance_analyzer.h]
2026-04-09 some upgrades to the viewing software. remove calibration
2026-05-01 Removed obsolete PDF files and updated LaTeX documents with new sections and references.
    [Final_LCR_Meter.kicad_sch, LEDs.kicad_sch, PSU_USB.kicad_sch, V2_LCR_Meter.kicad_sch, frontend.kicad_sch, sig_source.kicad_sch]
2026-05-06 upgrades to pc app
    [1000lcr_measurements_20260505_213827.csv, 1X_1000SAMPLES_100.csv, 1X_400SAMPLES_300.csv, 2X_1000SAMPLES_100.csv, 2X_400SAMPLES_300.csv, lcr_measurements_20260505_212813.csv, meas.csv]
2026-05-06 Stop tracking local schematic history
2026-05-06 export options + cleanup
    [lcr_measurements_20260506_114310.csv]
2026-05-15 4wire a dalsi
    [DC_offset.kicad_sch, XOR_phase.kicad_sch, amplitude.kicad_sch, i_v_conv.kicad_sch, peak_detect.kicad_sch, range_switch.kicad_sch, resonant.kicad_sch, schemata.kicad_sch]
2026-05-19 nejake zpracovani vysledku mereni
    [lcr_measurements_20260516_175730.csv, lcr_measurements_20260516_175934.csv]
2026-05-21 nejake edity vysledku a kompenzace seriovym rezistorem
    [c_big_100khz_1k_500.csv, c_big_500_1000.csv, range_switch.kicad_sch, schemata.kicad_sch, toroid_10khz_1000_500.csv, zero_comp.kicad_sch]
2026-06-16 Mark bakalarka as complete
    [73100-0131.STEP, ESP32-S2-SOLO-2.STEP, GY-511_LSM303DLHC.step, LCR_Meter.kicad_pcb, LCR_Meter.kicad_sch, LEDs.kicad_sch, PSU_USB.kicad_sch, RELAY8_J104D2C24VDC_15S_CRS.step]
